ruben-iteng/ato-library/README.md

<!-- This document is autogenerated - Do not edit manually!! -->

# ato-library

This is a monorepo for various [ato](https://docs.atopile.io) and [fabll](https://docs.atopile.io/atopile/guides/faebryk) packages for your projects made with [atopile](https://www.github.com/atopile/atopile) that can be found in the official [atopile package registry](https://packages.atopile.io/)

## Available Packages

| Package | Modules | Description | Version |
|---|---|---|---|
| [analog-devices-max14778](packages/analog-devices-max14778/README.md) | 1 module | Analog Devices MAX14778 dual 4:1 +/-25V above/below the rails analog multiplexer | 0.1.2 |
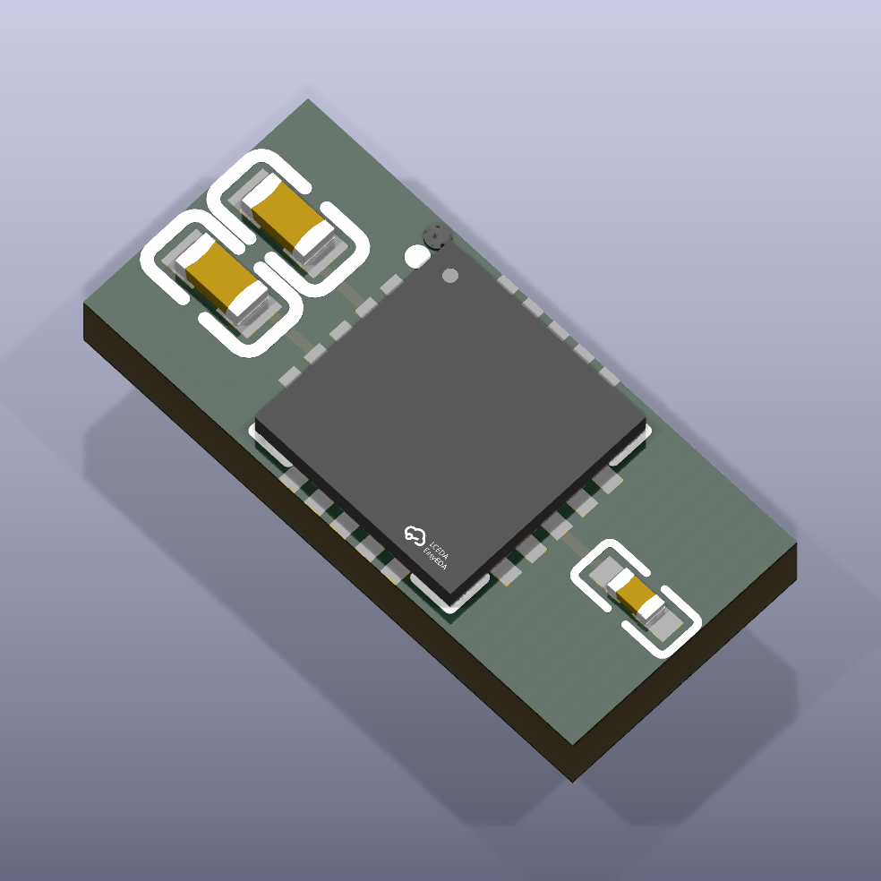
[picture p1: packages/analog-devices-max14778/assets/analog_devices_max14778_driver.png]
analog_devices_max14778_driver
|  | analog_devices_max14778_driver | Analog Devices MAX14778 dual 4:1 +/-25V above/below the rails analog multiplexer | |
| [connectors](packages/connectors/README.md) | 4 modules | Miscellaneous connectors | 0.2.3 |
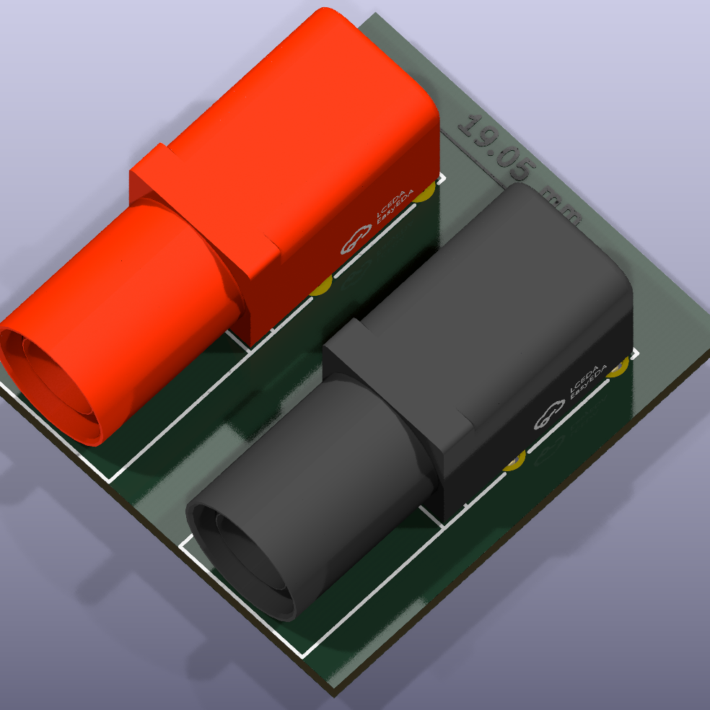
[picture p2: packages/connectors/assets/dual_banana_connectors.png]
dual_banana_connectors
|  | dual_banana_connectors | Dual banana connectors (Red and Black) with 3/4\" (19.05mm) spacing. | |
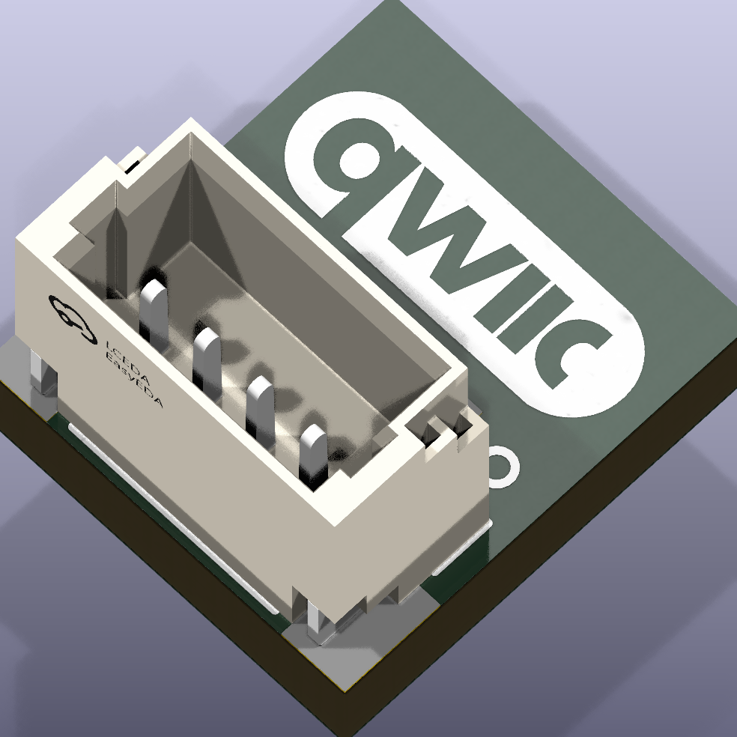
[picture p3: packages/connectors/assets/qwiic_vertical.png]
qwiic_vertical
|  | qwiic_vertical | Vertical QWIIC connector<br> https://www.sparkfun.com/qwiic | |
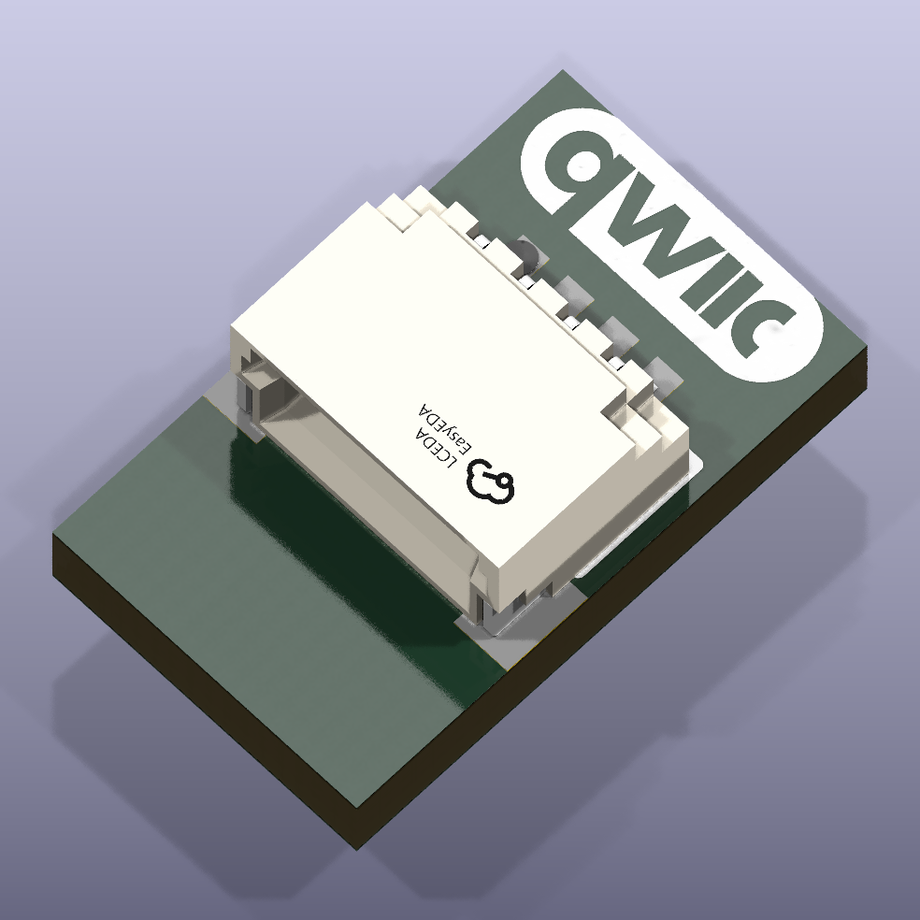
[picture p4: packages/connectors/assets/qwiic_horizontal.png]
qwiic_horizontal
|  | qwiic_horizontal | Horizontal QWIIC connector<br> https://www.sparkfun.com/qwiic | |
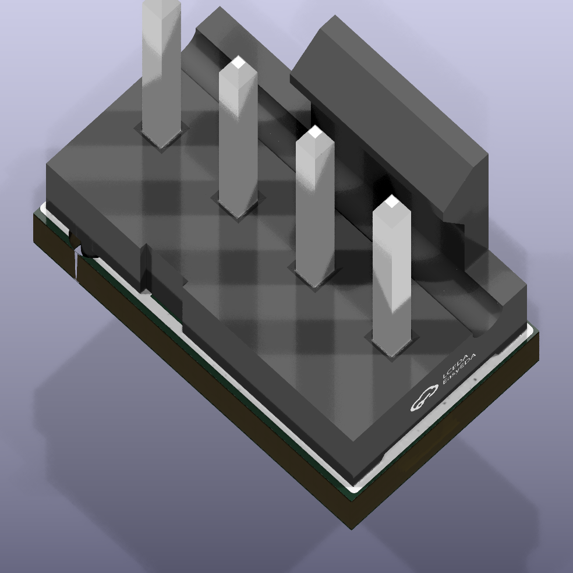
[picture p5: packages/connectors/assets/fan_connector.png]
fan_connector
|  | fan_connector | Connector for standard 4-pin 12v computer fans<br> - 12V<br> - Tach<br> - PWM | |
| [dcdc-converters](packages/dcdc-converters/README.md) | 2 modules | DCDC converters | 0.2.2 |
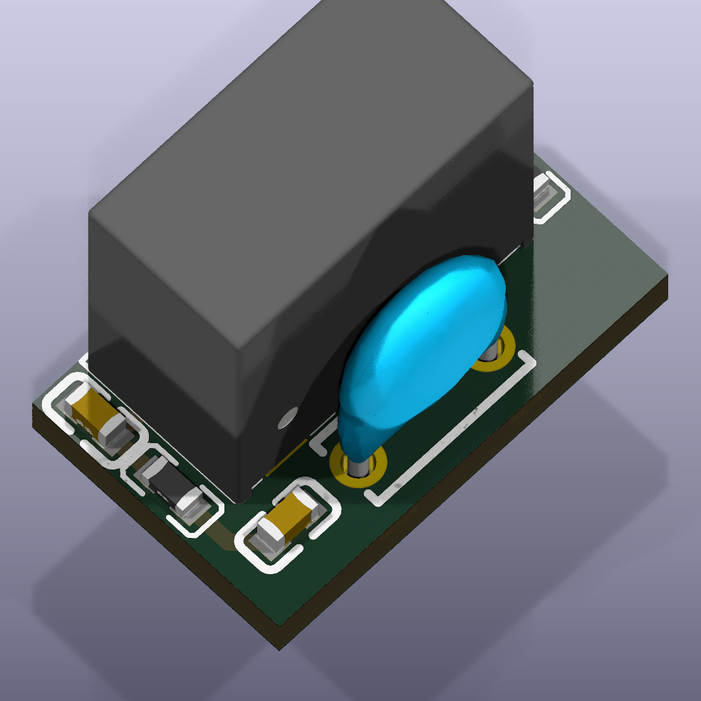
[picture p6: packages/dcdc-converters/assets/b0505s1wr3.png]
b0505s1wr3
|  | b0505s1wr3 | EVISUN B0505S-1WR3 5V to 5V isolated DCDC converter with shortcircuit protection<br> - 5V input<br> - 5V output<br> - 1W power rating | |
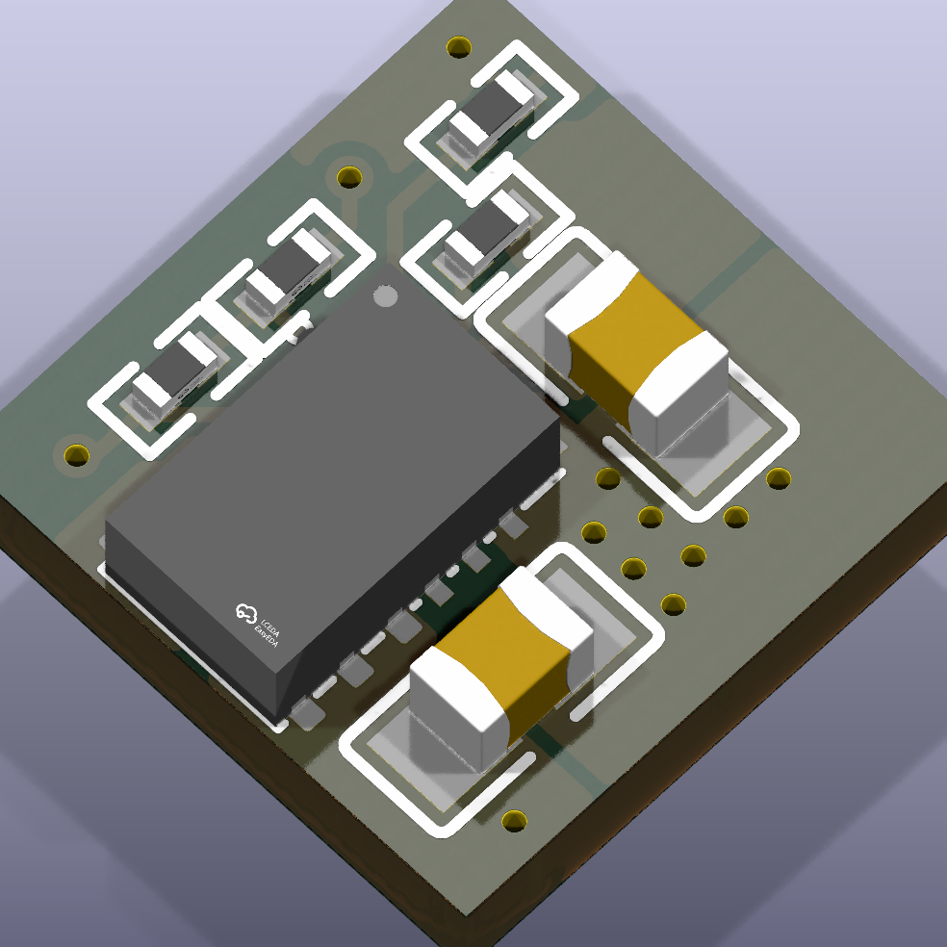
[picture p7: packages/dcdc-converters/assets/mpm3610-12vin-5vout.png]
mpm3610-12vin-5vout
|  | mpm3610-12vin-5vout | MPM3610 with component parameters optimized for 12V input and 5V output | |
| [debug-interfaces](packages/debug-interfaces/README.md) | 4 modules | SWD and tag connect headers for programming and debugging | 0.2.3 |
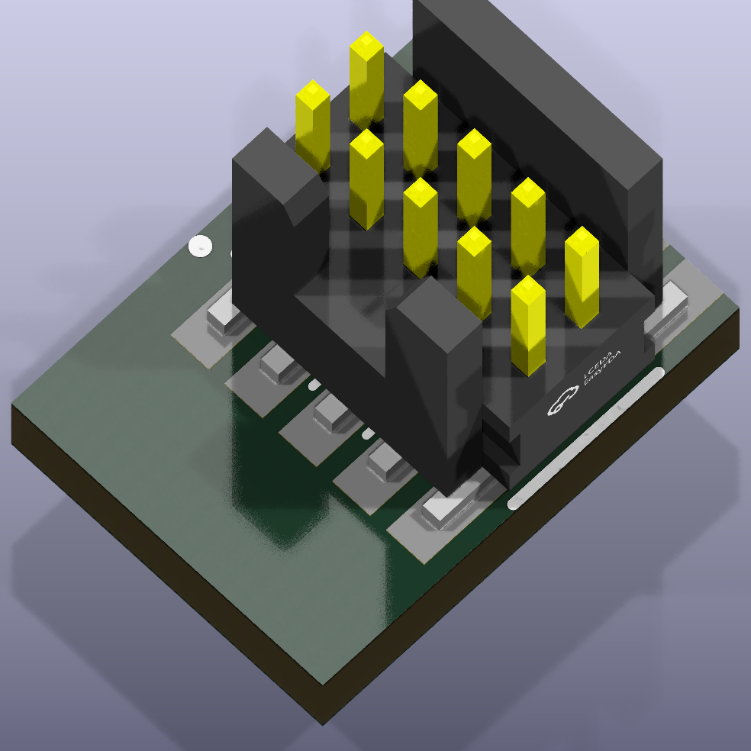
[picture p8: packages/debug-interfaces/assets/arm_cortex_m_debug_header.png]
arm_cortex_m_debug_header
|  | arm_cortex_m_debug_header | 10 pin debug header with SWD pinout according to ARM Cortex M debug specification<br> https://documentation-service.arm.com/static/5fce6c49e167456a35b36af1 | |
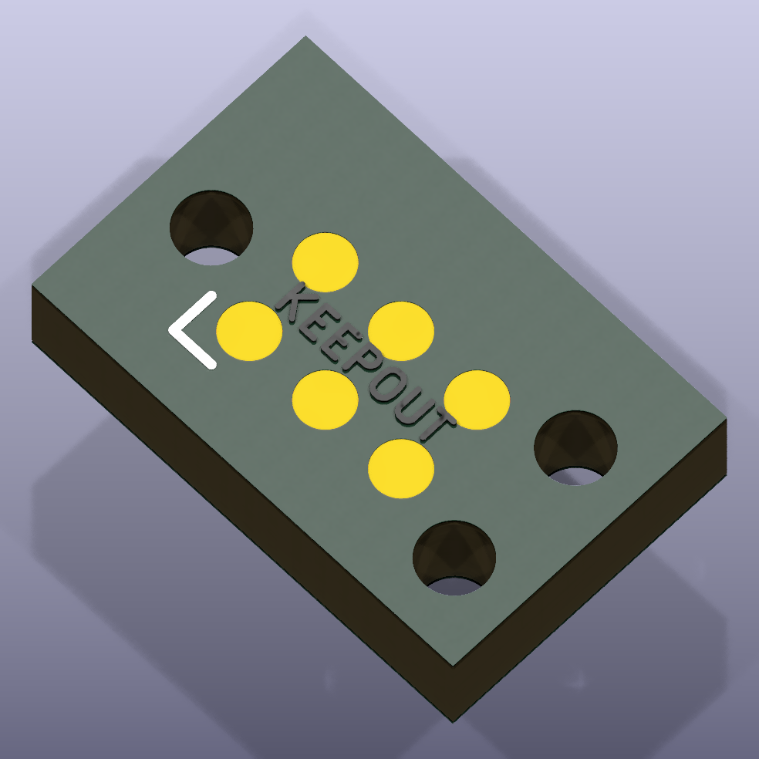
[picture p9: packages/debug-interfaces/assets/swd_tc2030_idc_nl.png]
swd_tc2030_idc_nl
|  | swd_tc2030_idc_nl | Tag-Connect TC2030-IDC-NL (6-pin) landing pattern with SWD pinout | |
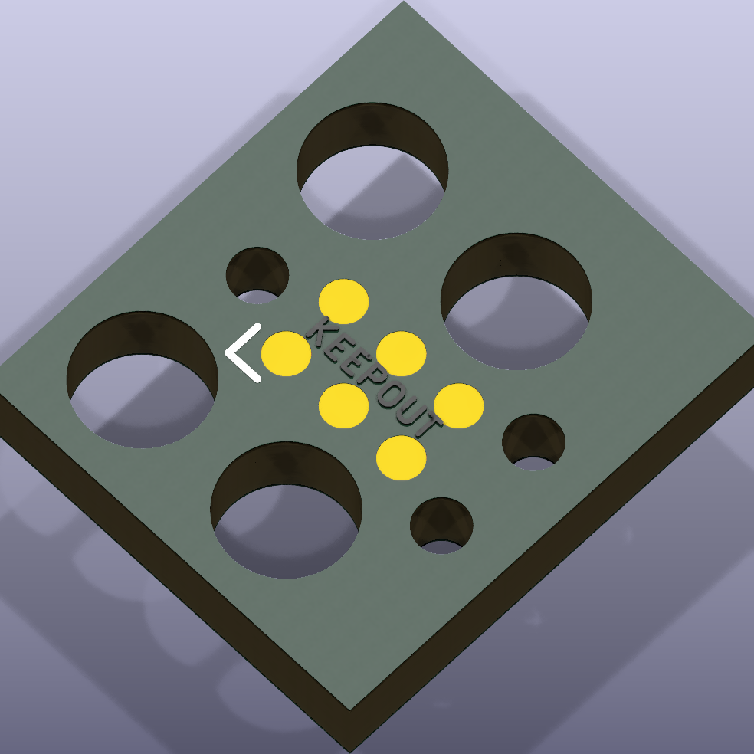
[picture p10: packages/debug-interfaces/assets/swd_tc2030_idc_fp.png]
swd_tc2030_idc_fp
|  | swd_tc2030_idc_fp | Tag-Connect TC2030-IDC-FP (6-pin) landing pattern with SWD pinout | |
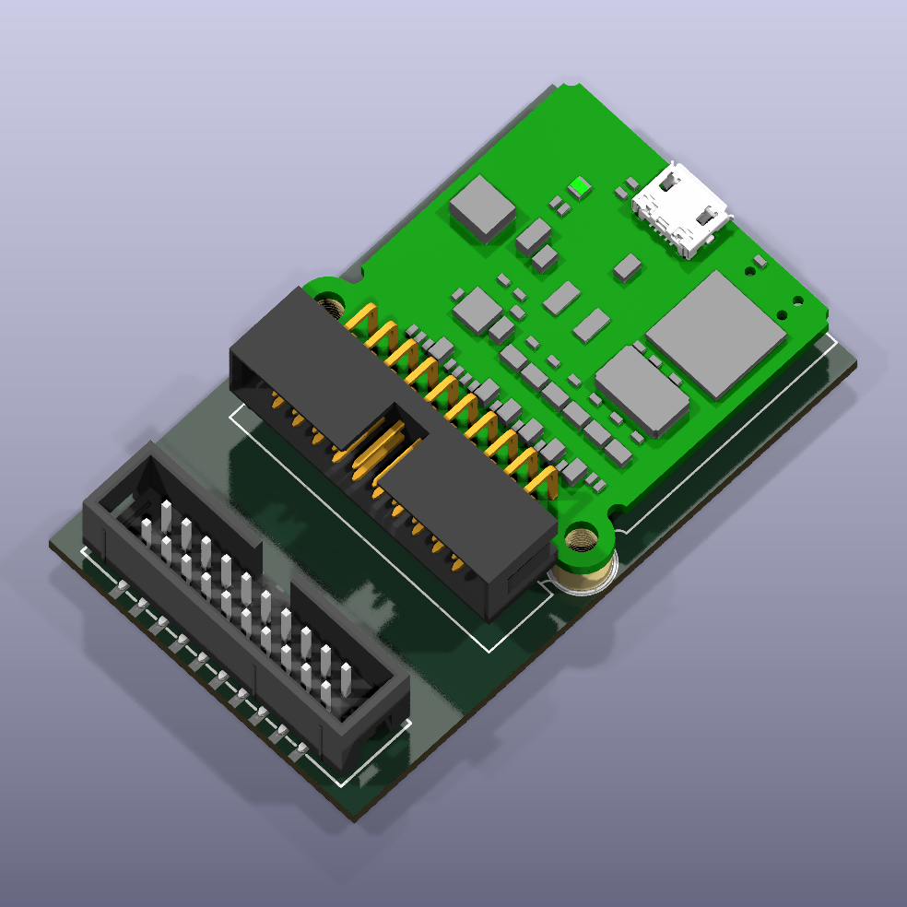
[picture p11: packages/debug-interfaces/assets/segger_jlink_compact.png]
segger_jlink_compact
|  | segger_jlink_compact | SEGGER J-Link compact PCBA mount | |
| [esp32c3](packages/esp32c3/README.md) | 2 modules | ESP32 C3 microcontroller | 0.2.3 |
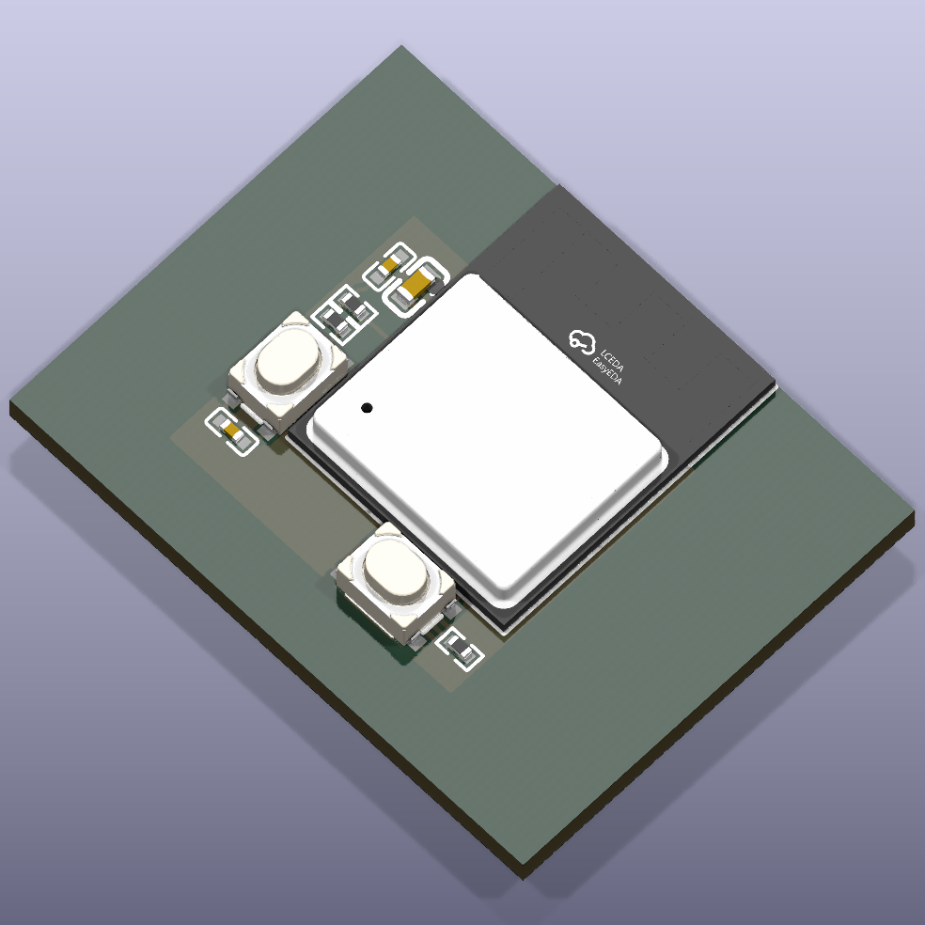
[picture p12: packages/esp32c3/assets/esp32_c3_mini_driver.png]
esp32_c3_mini_driver
|  | esp32_c3_mini_driver | ESP32 S3 WROOM-1 module with build-in antenna and supporting components | |
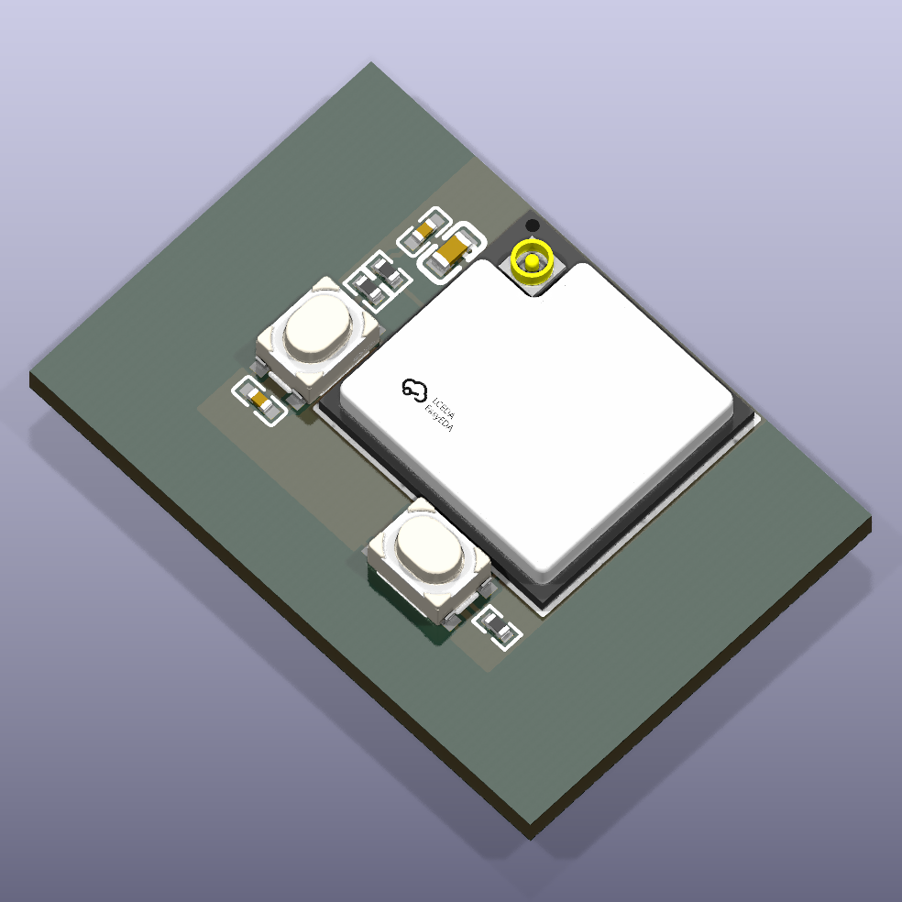
[picture p13: packages/esp32c3/assets/esp32_c3_mini_ufl_driver.png]
esp32_c3_mini_ufl_driver
|  | esp32_c3_mini_ufl_driver | ESP32 S3 WROOM-1 module with u.fl antenna connector and supporting components | |
| [esp32s3](packages/esp32s3/README.md) | 1 module | ESP32 S3 microcontroller | 0.2.2 |
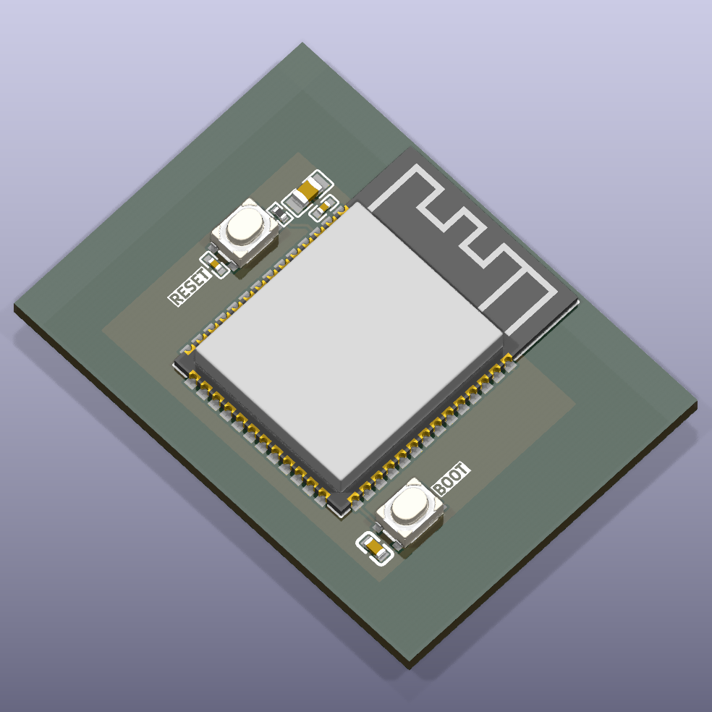
[picture p14: packages/esp32s3/assets/esp32_s3_wroom_driver.png]
esp32_s3_wroom_driver
|  | esp32_s3_wroom_driver | ESP32 S3 WROOM-1 module with build-in antenna and supporting components<br> - 32MB flash<br> - 2MB PSRAM | |
| [ina228](packages/ina228/README.md) | 1 module | INA228 low voltage power monitor with I2C interface | 0.2.2 |
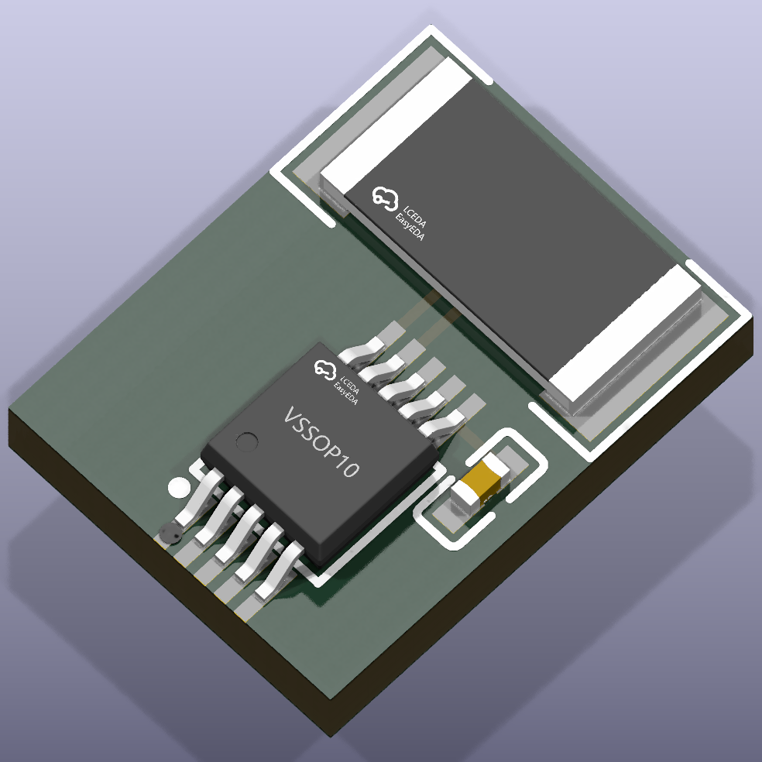
[picture p15: packages/ina228/assets/ina228.png]
ina228
|  | ina228 | INA228 85-V, 20-bit, ultra-precise, I2C output<br> current/voltage/power/energy/charge monitor with alert | |
| [ldos](packages/ldos/README.md) | 1 module | Various Low Dropout Regulators (LDOs) | 0.2.3 |
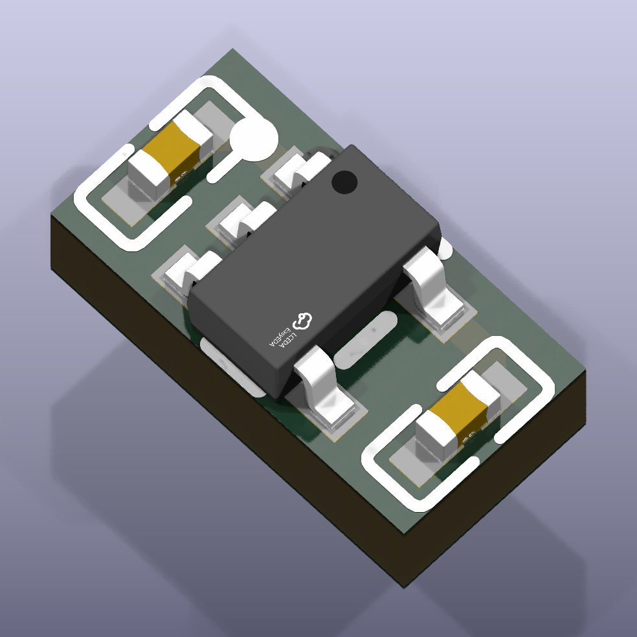
[picture p16: packages/ldos/assets/5v_to_3v3.png]
5v_to_3v3
|  | 5v_to_3v3 | 5V to 3.3V 600mA (max 1100mA) LDO | |
| [leds](packages/leds/README.md) | 2 modules | Various (addressable) LED components and modules | 0.2.2 |
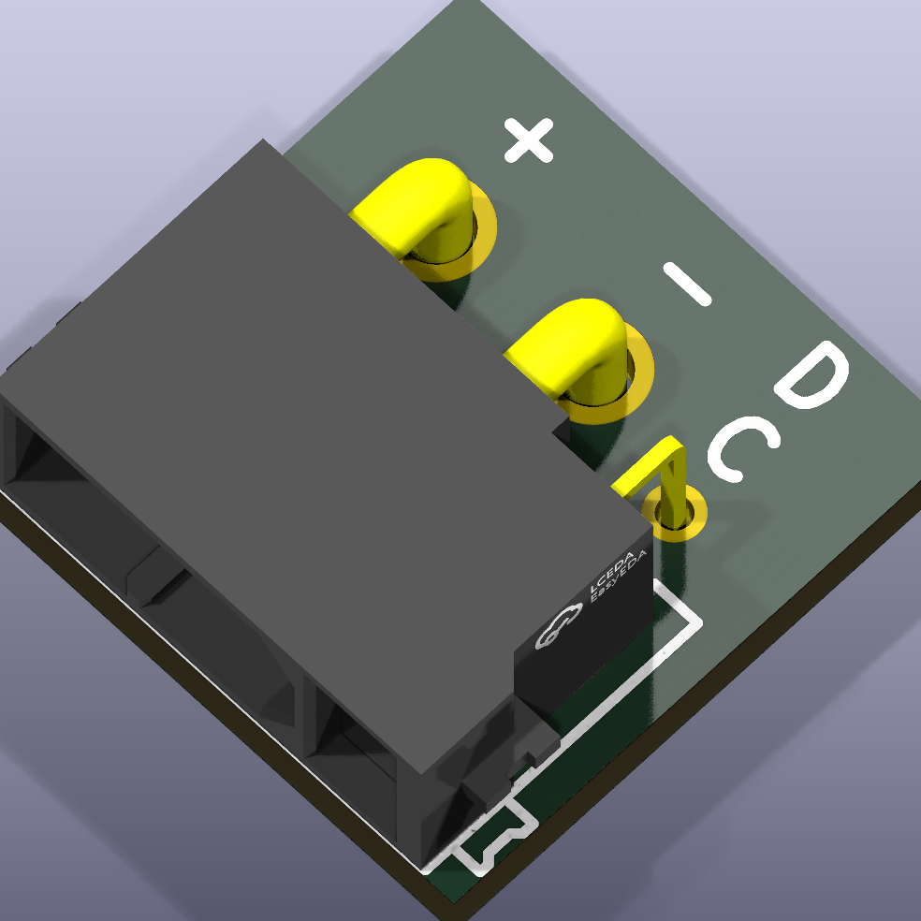
[picture p17: packages/leds/assets/addressable_led_connector_driver.png]
addressable_led_connector_driver
|  | addressable_led_connector_driver | XT30 connector with 2 additional data pins.<br> Wired for connecting to addressable LED strips. | |
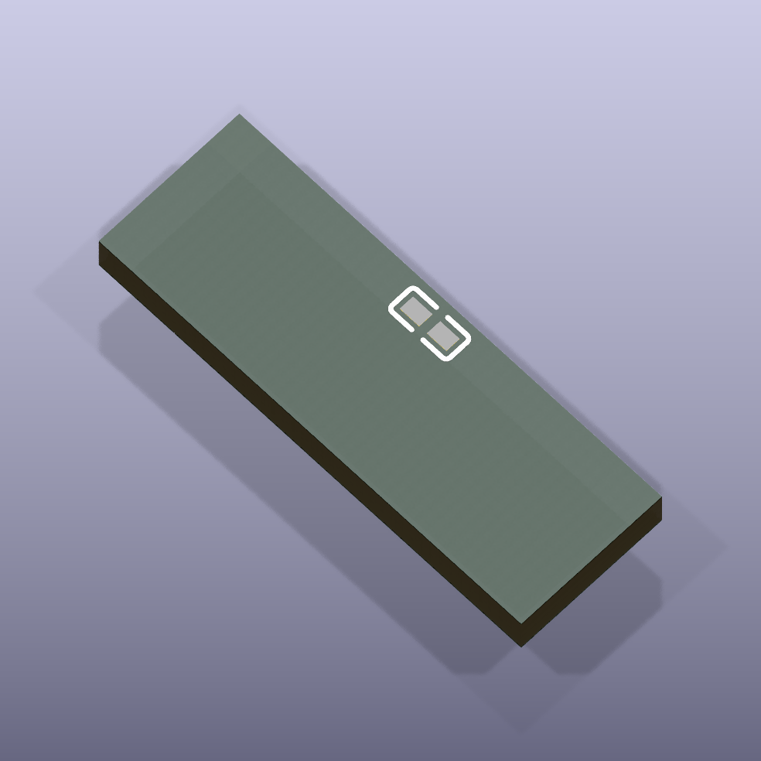
[picture p18: packages/leds/assets/addressable_led_driver.png]
addressable_led_driver
|  | addressable_led_driver | Addressable LED with decoupling capacitors.<br><br> Usage:<br> from "ruben-iteng/ato-library/leds/addressable_leds.ato" import AddressableLED<br><br> module MyProject:<br> ...<br> leds = new AddressableLED[3]<br><br> power = new ElectricPower<br> data_in = new ElectricLogic<br><br> for led in leds:<br> led -> WS2812B_5050_Black<br> led.power ~ power<br><br> data_in ~> leds[0] ~> leds[1] ~> leds[2] | |
| [logic](packages/logic/README.md) | 5 modules | Digital logic related components and modules | 0.2.2 |
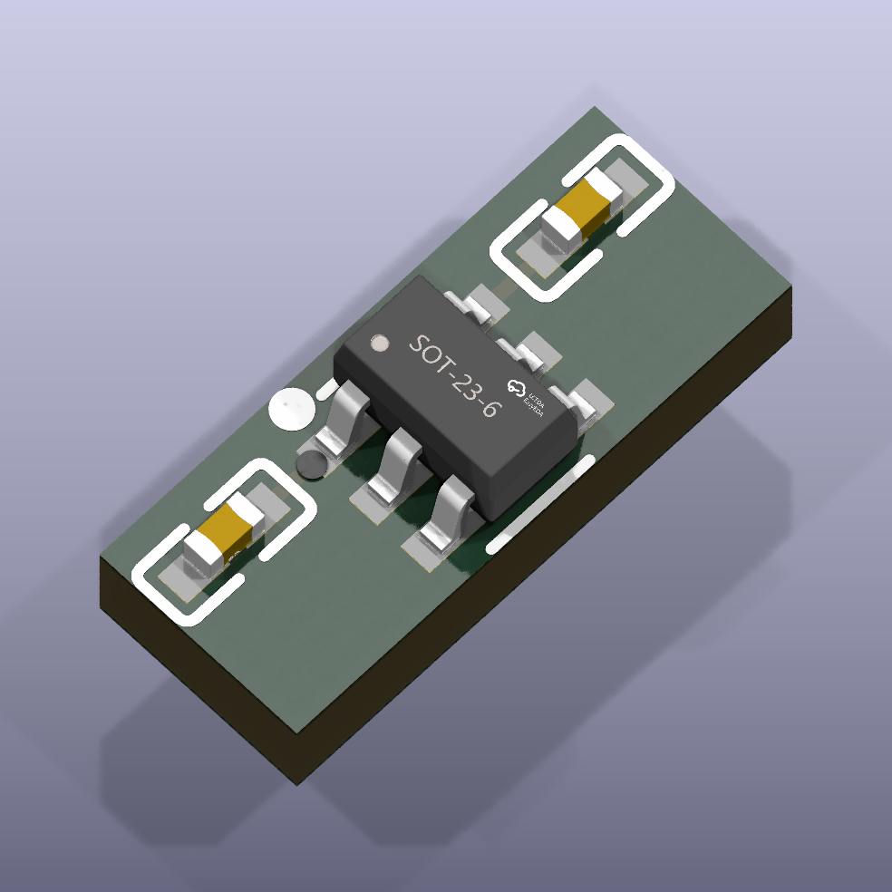
[picture p19: packages/logic/assets/aip74lvc1t45_driver.png]
aip74lvc1t45_driver
|  | aip74lvc1t45_driver | Single channel bidirectional buffer.<br> 1.2V-5.5V logic levels.<br> SOT-23-6 | |
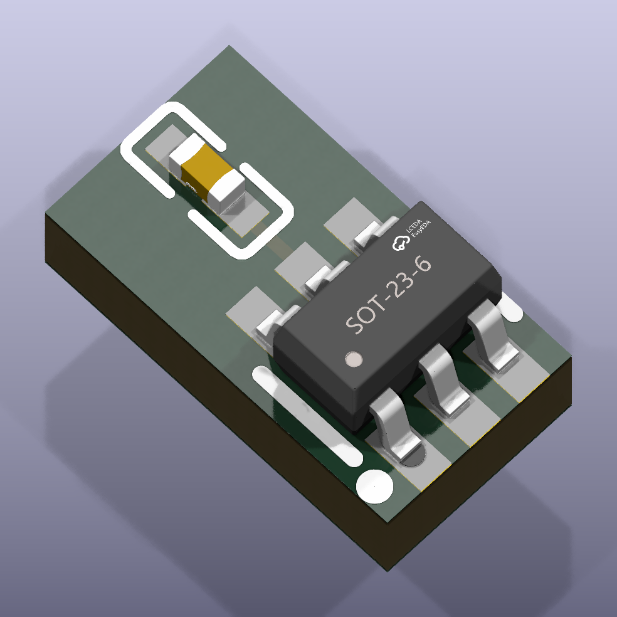
[picture p20: packages/logic/assets/sn74lvc2g34dbvrumw_driver.png]
sn74lvc2g34dbvrumw_driver
|  | sn74lvc2g34dbvrumw_driver | UMWYoutai Semiconductor Co., Ltd.<br> 74LVC2G34 Dual buffer. | |
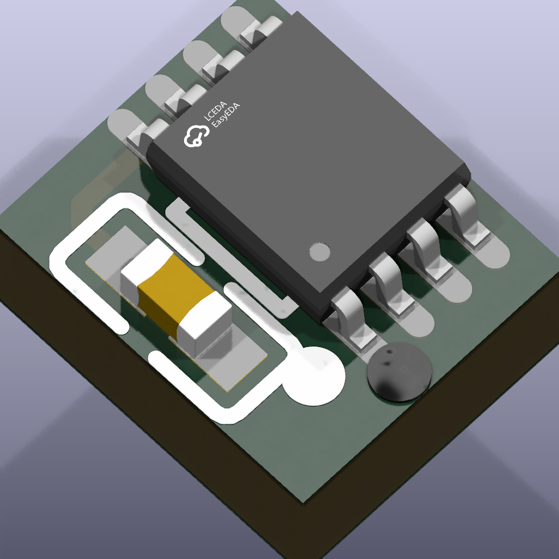
[picture p21: packages/logic/assets/sn74lvc3g14dc_driver.png]
sn74lvc3g14dc_driver
|  | sn74lvc3g14dc_driver | - | |
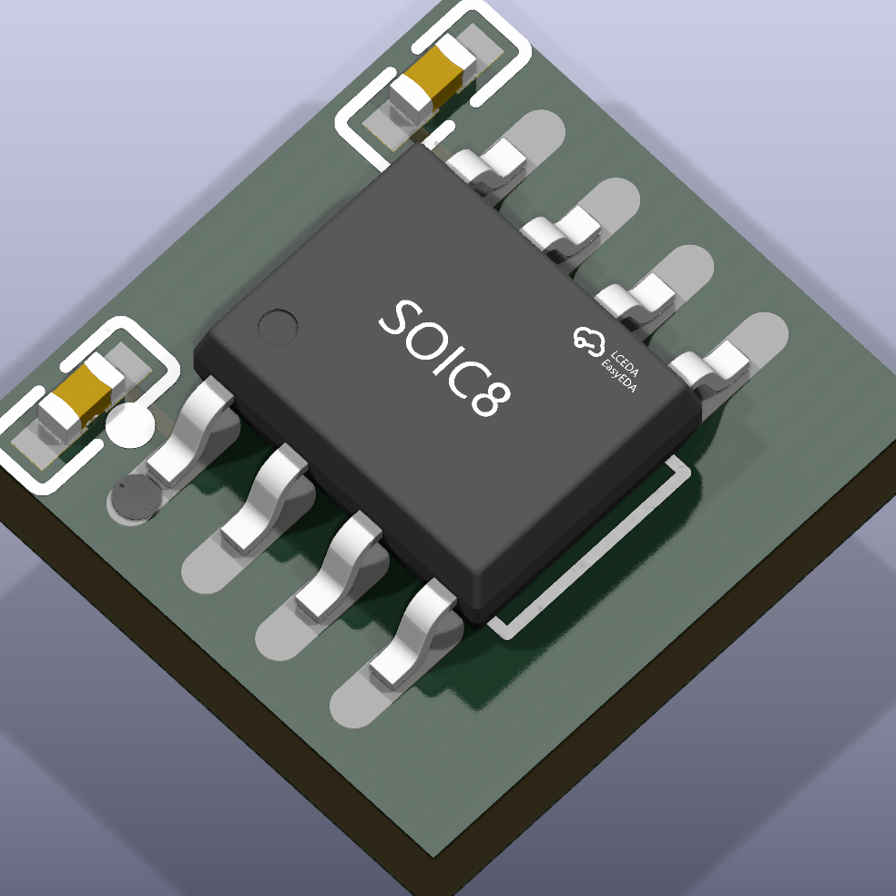
[picture p22: packages/logic/assets/iso1540_driver.png]
iso1540_driver
|  | iso1540_driver | ISO1540 low-power bidirectional I2C isolators.<br> - 3.0V to 5.5V power and signal levels<br> - up to 100Mhz I2C | |
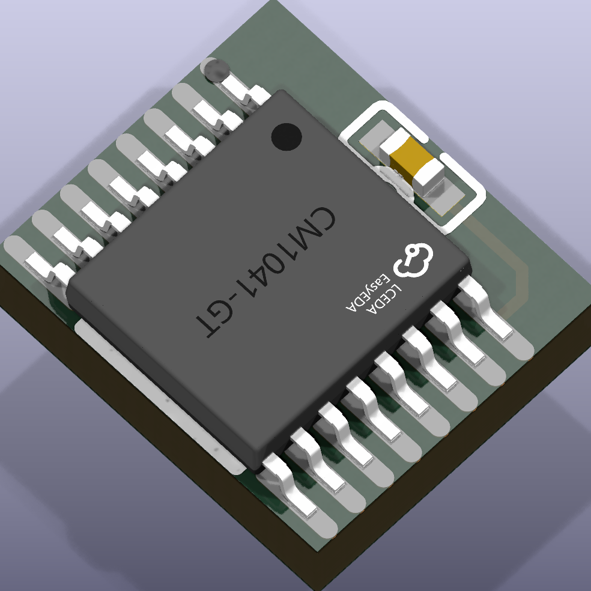
[picture p23: packages/logic/assets/sn74cb3q3251pwr_driver.png]
sn74cb3q3251pwr_driver
|  | sn74cb3q3251pwr_driver | Texas Instruments SN74CB3Q3251PWR<br> 1 to/from 8 FET multiplexer/demultiplexer<br> 2.5V/3.3V low-voltage high-bandwidth bus switch | |
| [logos](packages/logos/README.md) | 1 module | Various logos | 0.2.0 |
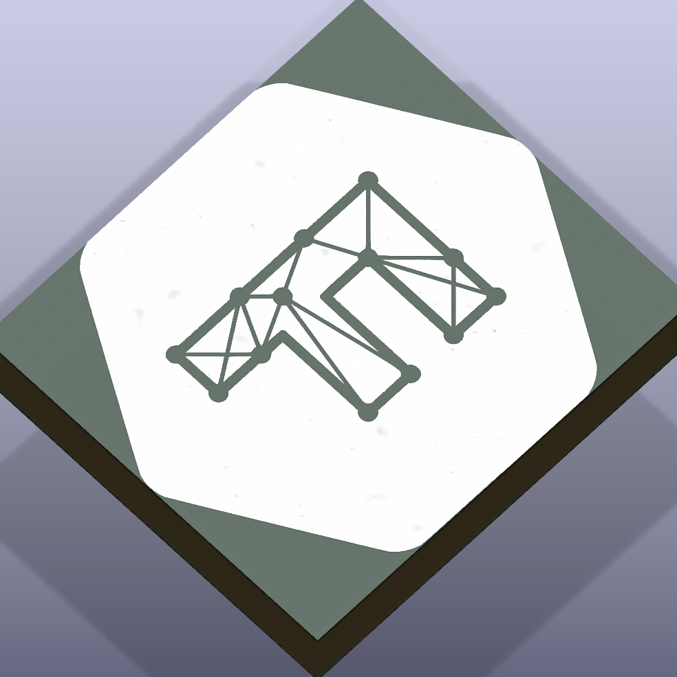
[picture p24: packages/logos/assets/faebryk_logo_8x9mm.png]
faebryk_logo_8x9mm
|  | faebryk_logo_8x9mm | faebryk Logo 8x9mm | |
| [microchip-emc2101](packages/microchip-emc2101/README.md) | 1 module | Microchip EMC2101 fan driver | 0.1.2 |
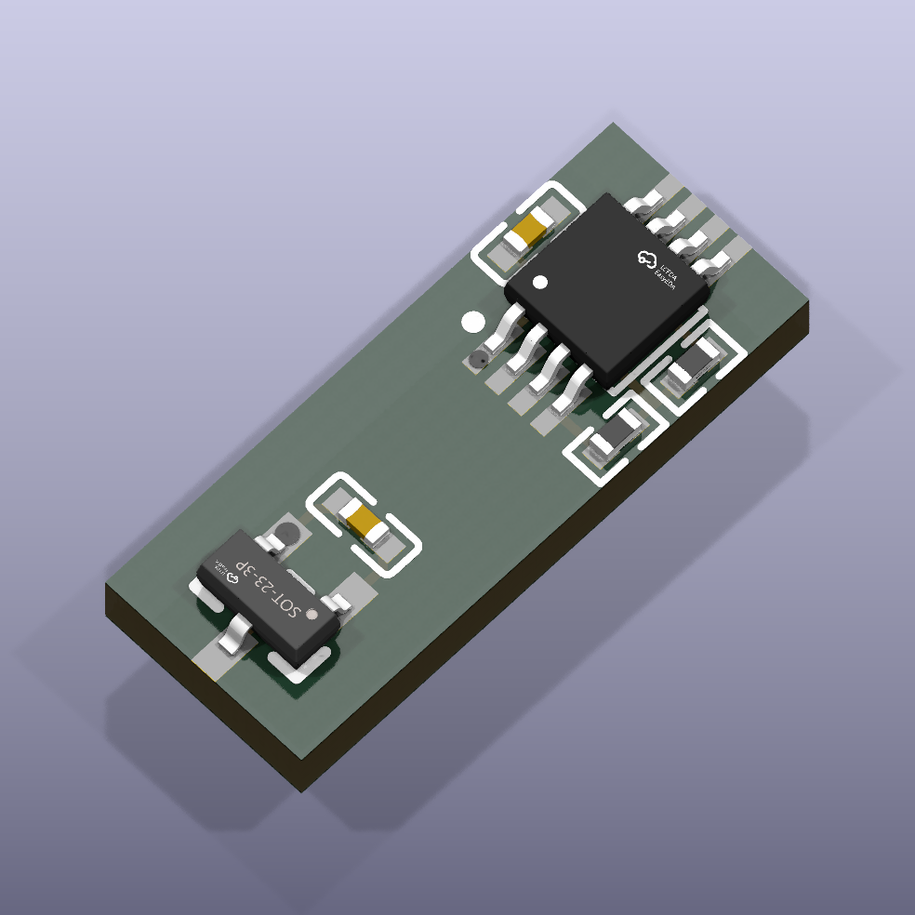
[picture p25: packages/microchip-emc2101/assets/microchip_emc2101_driver.png]
microchip_emc2101_driver
|  | microchip_emc2101_driver | MicrochipEMC2101 fan driver<br> Automatic Beta Compensation<br> - Resistance Error Correction<br> - Self-programming with available SMBus compatible EEPROM<br> - Selectable PWM or DAC fan driver output<br> - Temperature Monitors<br> - External channel ±1°C accuracy<br> - Internal channel ±2°C accuracy<br> - 3.3 Volt Operation (5 Volt Tolerant Input Buffers)<br> - SMBus 2.0 Compliant Interface, supports TIMEOUT | |
| [nxp_semiconductors-pca95xx](packages/nxp_semiconductors-pca95xx/README.md) | 7 modules | NXP Semiconductors PCA95xx family of I2C I/O expanders | 0.2.0 |
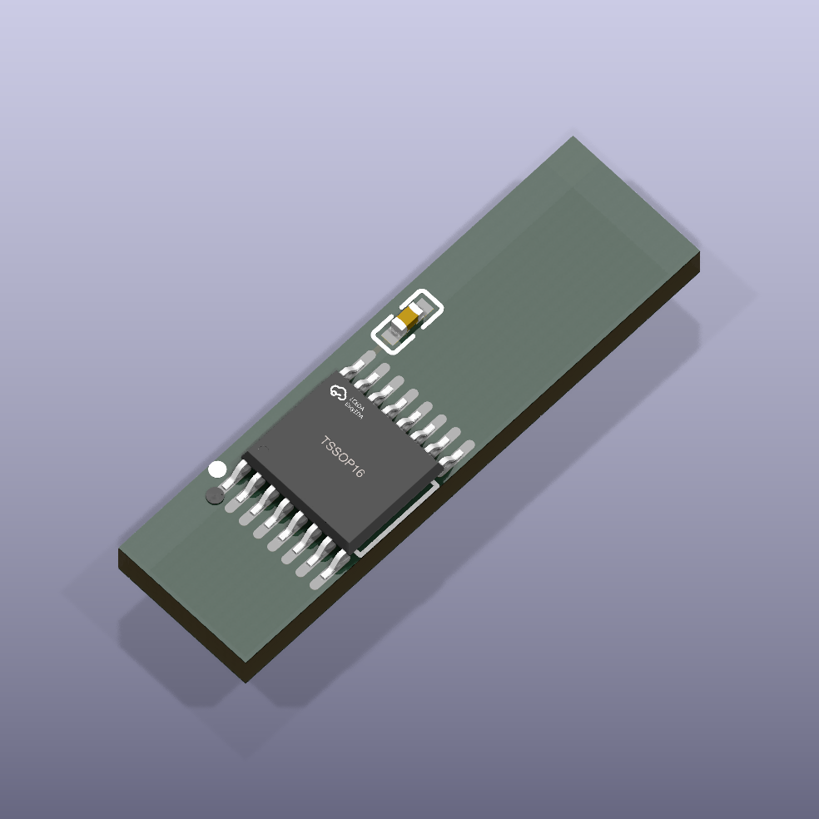
[picture p26: packages/nxp_semiconductors-pca95xx/assets/pca9554pw_driver.png]
pca9554pw_driver
|  | pca9554pw_driver | NXP Semiconductors PCA9554 TSSOP16 package | |
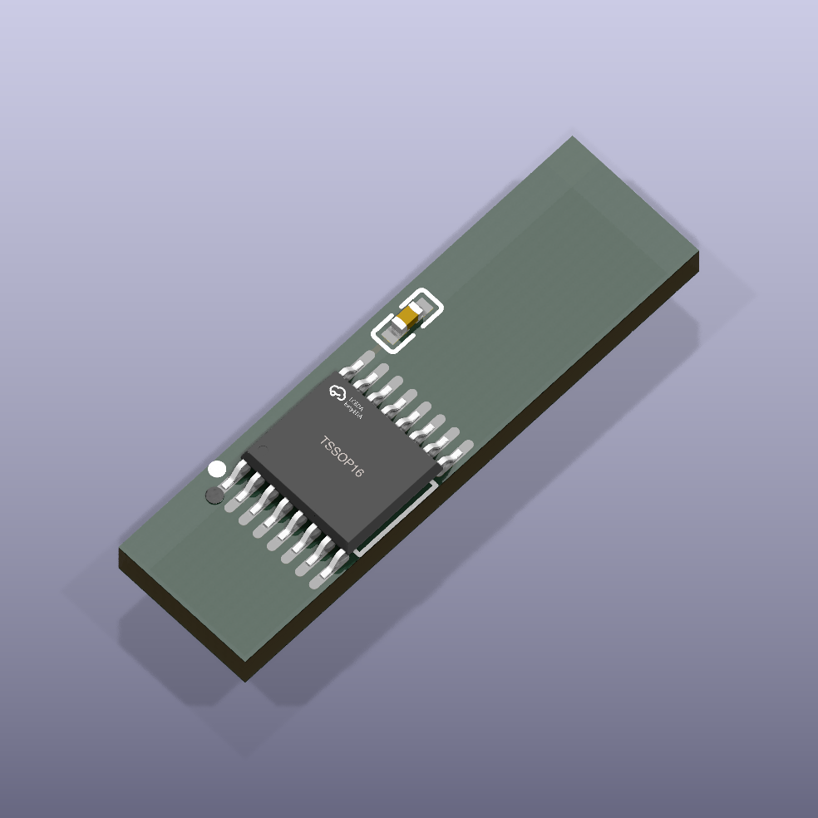
[picture p27: packages/nxp_semiconductors-pca95xx/assets/pca9554apw_driver.png]
pca9554apw_driver
|  | pca9554apw_driver | NXP Semiconductors PCA9554A TSSOP16 package | |
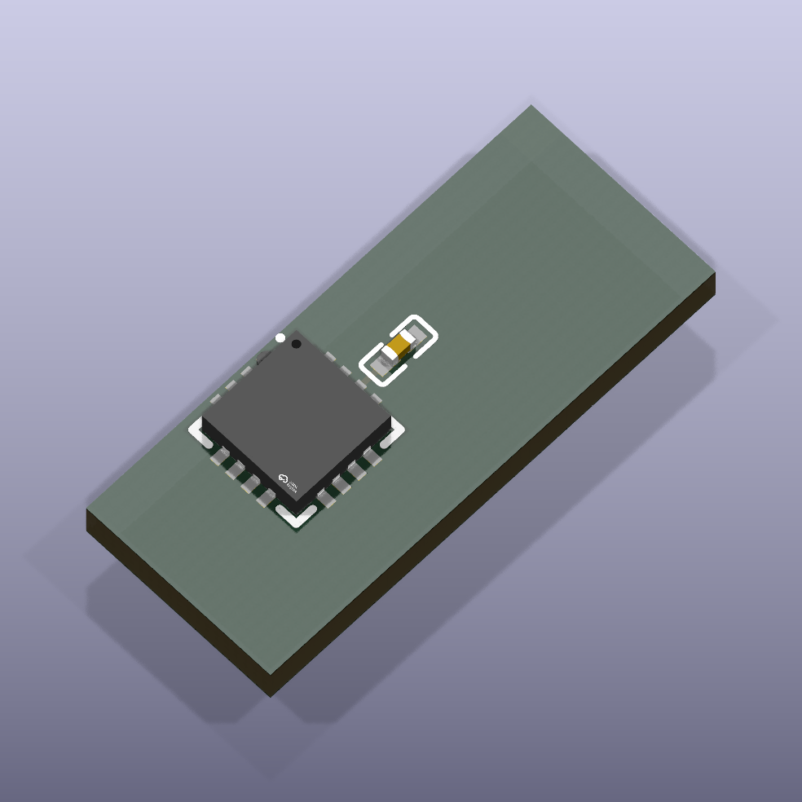
[picture p28: packages/nxp_semiconductors-pca95xx/assets/pca9554abs_driver.png]
pca9554abs_driver
|  | pca9554abs_driver | NXP Semiconductors PCA9554A HVQFN16(4x4mm) package | |
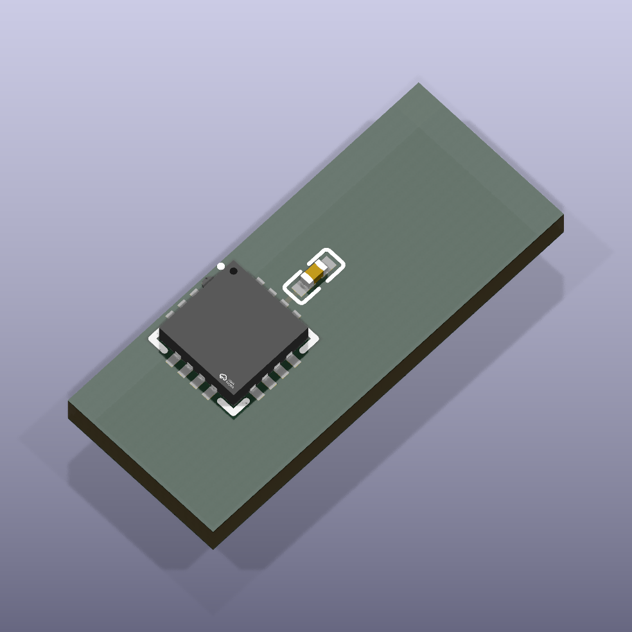
[picture p29: packages/nxp_semiconductors-pca95xx/assets/pca9554bs_driver.png]
pca9554bs_driver
|  | pca9554bs_driver | NXP Semiconductors PCA9554 HVQFN16(4x4mm) package | |
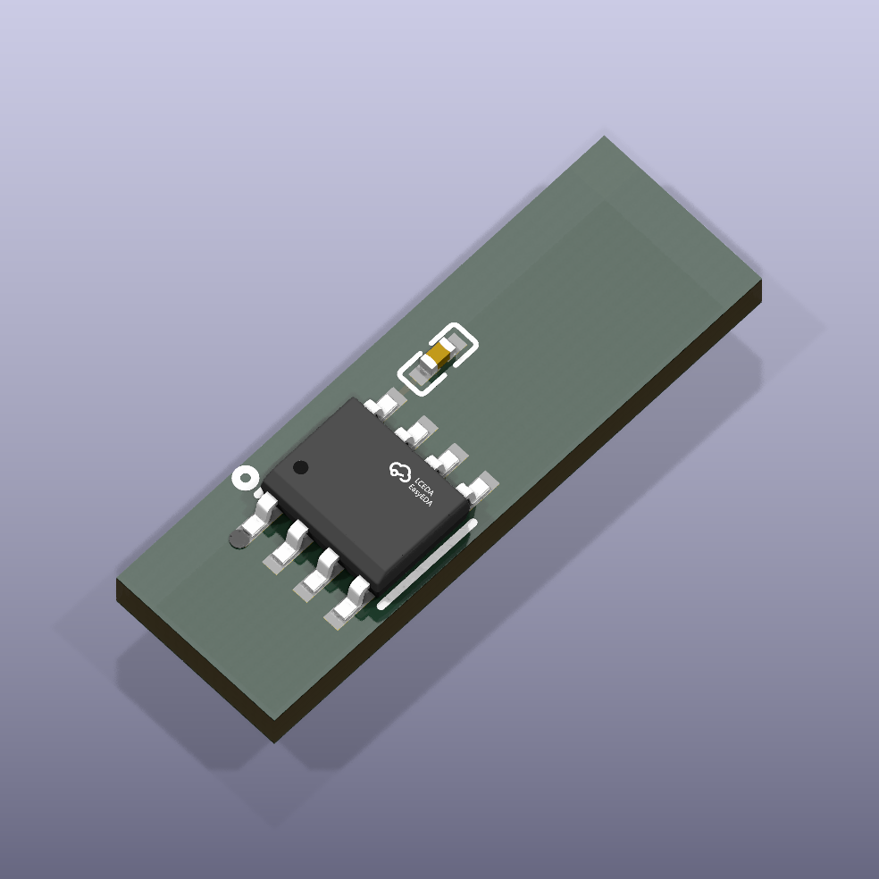
[picture p30: packages/nxp_semiconductors-pca95xx/assets/pca9536d_driver.png]
pca9536d_driver
|  | pca9536d_driver | NXP Semiconductors PCA9536D SO-8 package | |
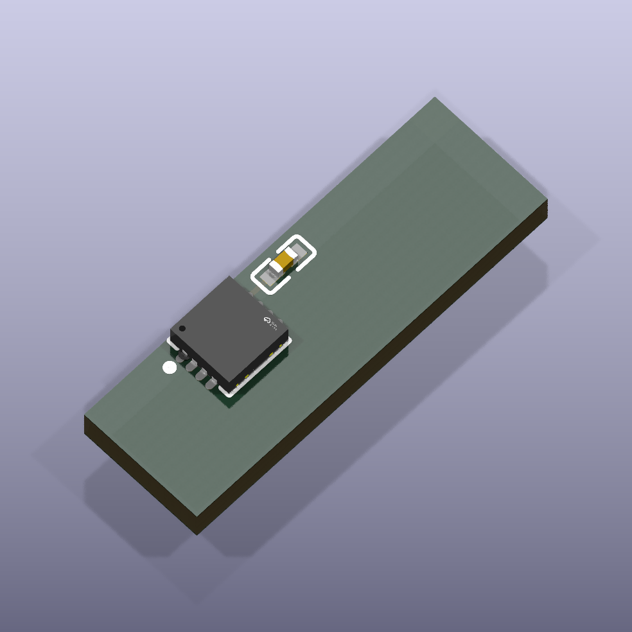
[picture p31: packages/nxp_semiconductors-pca95xx/assets/pca9536tk_driver.png]
pca9536tk_driver
|  | pca9536tk_driver | NXP Semiconductors PCA9536TK HVSON-8 package | |
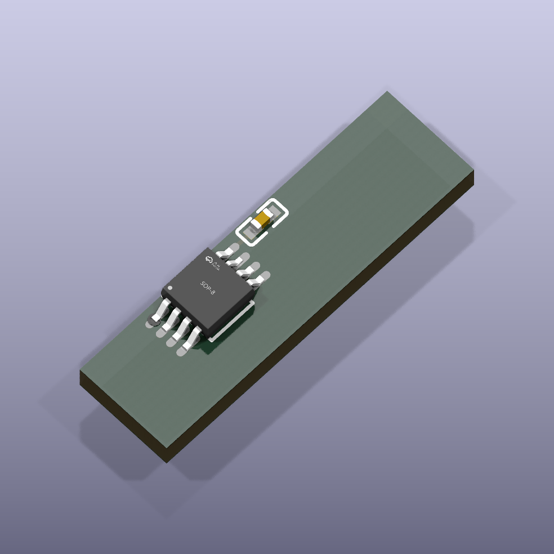
[picture p32: packages/nxp_semiconductors-pca95xx/assets/pca9536dp_driver.png]
pca9536dp_driver
|  | pca9536dp_driver | NXP Semiconductors PCA9536DP TSSOP-8 package | |
| [relays](packages/relays/README.md) | 3 modules | Relay modules | 0.2.2 |
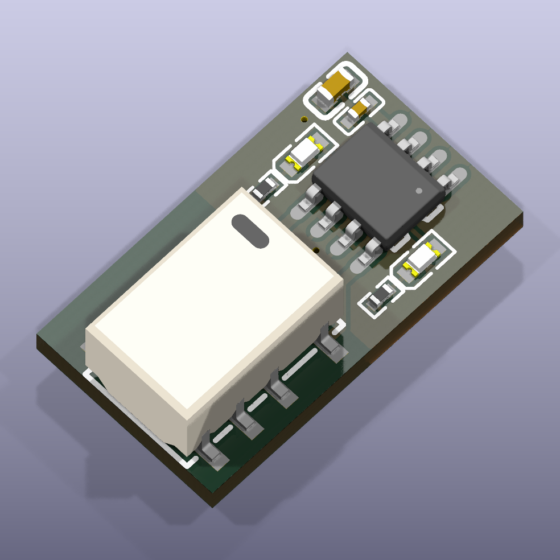
[picture p33: packages/relays/assets/driven_dpdt_bistable_relay.png]
driven_dpdt_bistable_relay
|  | driven_dpdt_bistable_relay | Bistable DPDT relay with driver and indicator LEDs<br> - 5V coil power<br> - 5V/3.3V logic power<br> - 2A contact carry current<br> - TC118S DC motor driver (H-bridge) as relay driver | |
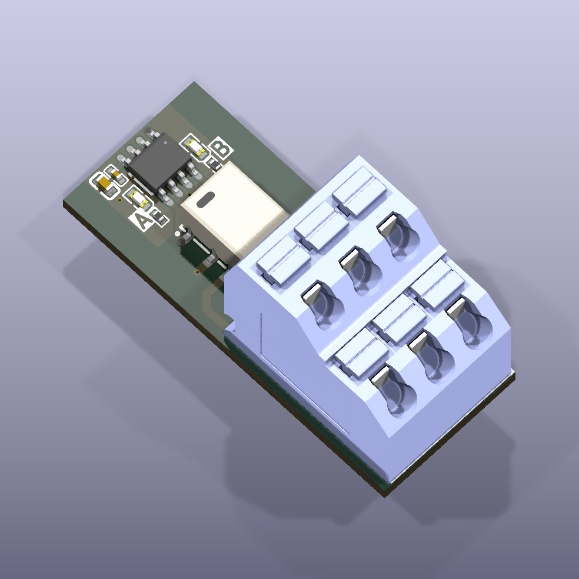
[picture p34: packages/relays/assets/driven_dpdt_bistable_relay_push_terminal.png]
driven_dpdt_bistable_relay_push_terminal
|  | driven_dpdt_bistable_relay_push_terminal | DrivenDPDTBistableRelay with push terminal | |
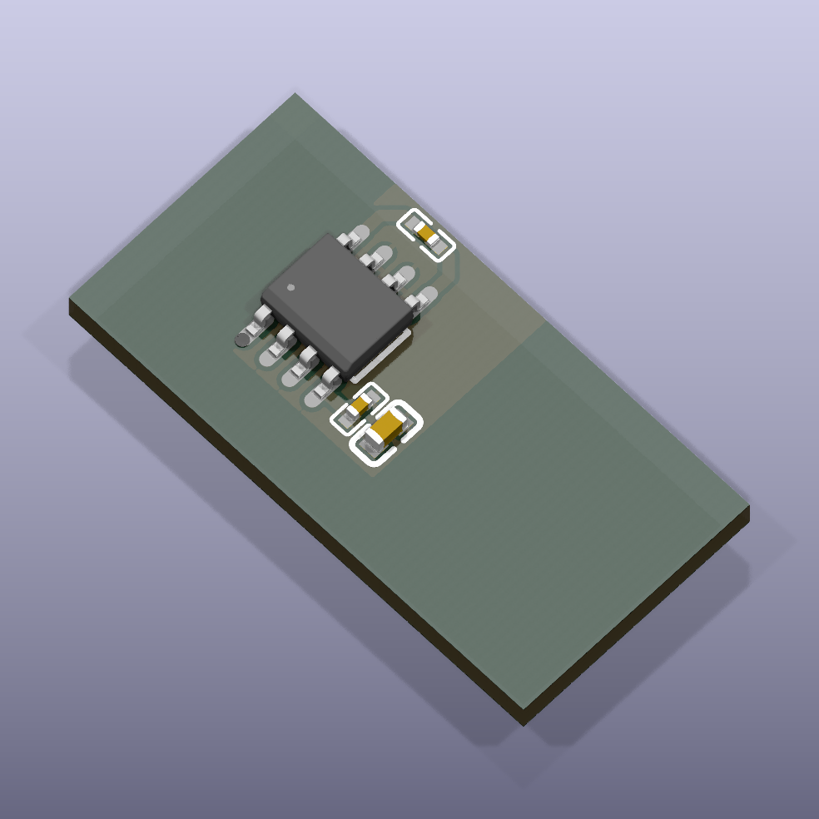
[picture p35: packages/relays/assets/dc_motor_driver.png]
dc_motor_driver
|  | dc_motor_driver | Shenzhen Fuman Elec TC118S dc motor driver<br> - Single-channel built-in high-power MOS full-bridge driver<br> - Supports forward, reverse, stop, and brake functions<br> - Built-in efficient thermal response and thermal protection<br> - Low on-resistance (1.6Ω)<br> - Maximum continuous output current: 1.8A, peak current: 2.5A | |
| [rohm_semiconductor_bh1750fvi](packages/rohm_semiconductor_bh1750fvi/README.md) | 1 module | ROHM Semiconductor BH1750FVI-TR Digital Ambient Light Sensor with I2C interface | 0.1.1 |
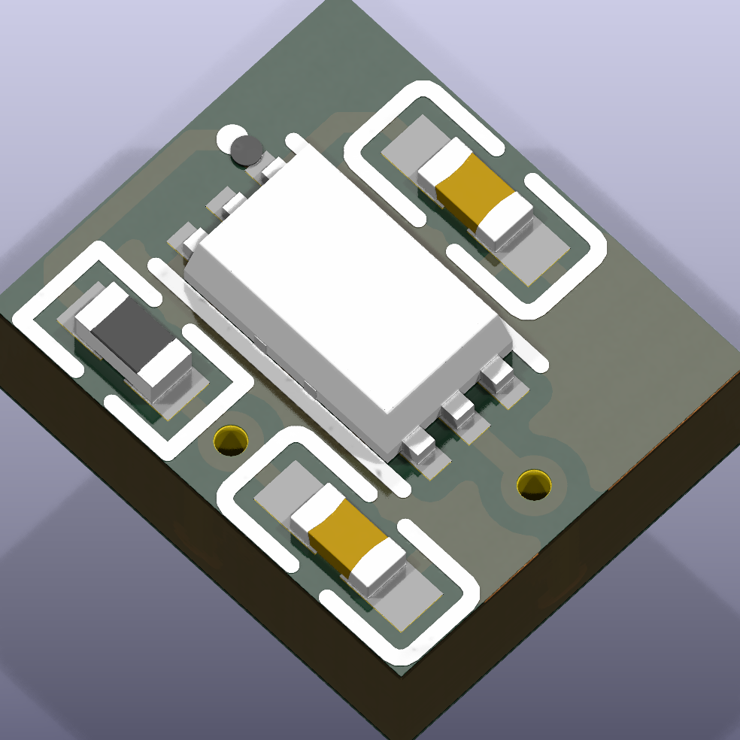
[picture p36: packages/rohm_semiconductor_bh1750fvi/assets/bh1750_driver.png]
bh1750_driver
|  | bh1750_driver | Digital ambient light sensor with I2C interface<br><br> - I2C bus Interface (f/s Mode Support)<br> - Spectral responsibility is approximately human eye response<br> - Illuminance to Digital Converter<br> - Wide range and High resolution (1 - 65535 lx)<br> - Low Current by power down function<br> - 50Hz/60Hz Light noise reject-function<br> - 1.8V Logic input interface<br> - No need any external parts<br> - Light source dependency is little (Incandescent Lamp, Fluorescent Lamp, Halogen Lamp, White LED, Sun Light)<br> - It is possible to select 2 type of I2C slave-address<br> - Adjustable measurement result for influence of optical window (It is possible to detect min. 0.11 lx, max. 100000 lx by using this function)<br> - Small measurement variation (+/- 20%)<br> - The influence of infrared is very small | |
| [rs485](packages/rs485/README.md) | 4 modules | RS485 related modules | 0.2.3 |
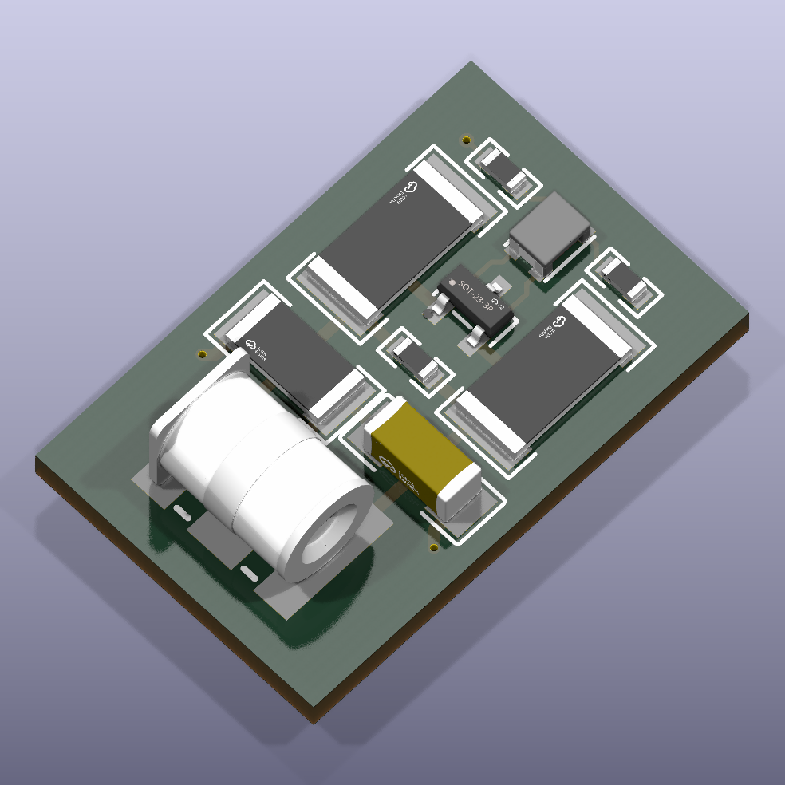
[picture p37: packages/rs485/assets/bus_protection.png]
bus_protection
|  | bus_protection | RS485 bus protection.<br> - Overvoltage protection<br> - Overcurrent protection<br> - Common mode filter<br> - Termination resistor<br> - ESD protection<br> - Lightning protection<br><br> based on: https://www.mornsun-power.com/public/uploads/pdf/TD(H)541S485H.pdf | |
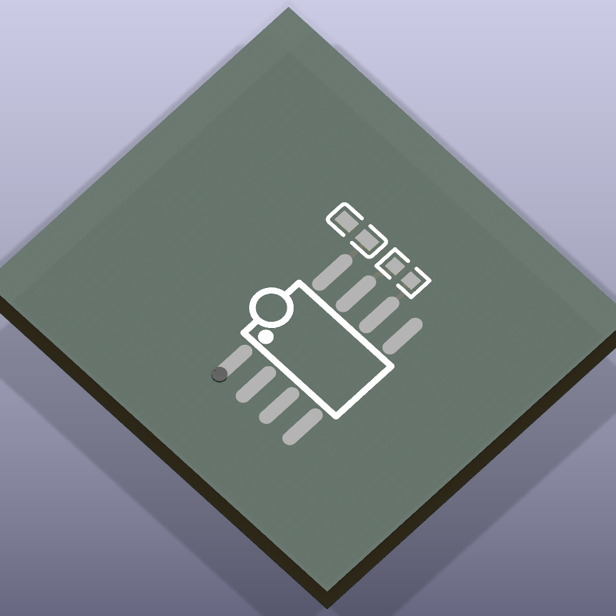
[picture p38: packages/rs485/assets/maxlinear_sp3485en_driver.png]
maxlinear_sp3485en_driver
|  | maxlinear_sp3485en_driver | Simple UART to RS485 converter.<br> UART and write enable interface in, RS485 interface out. | |
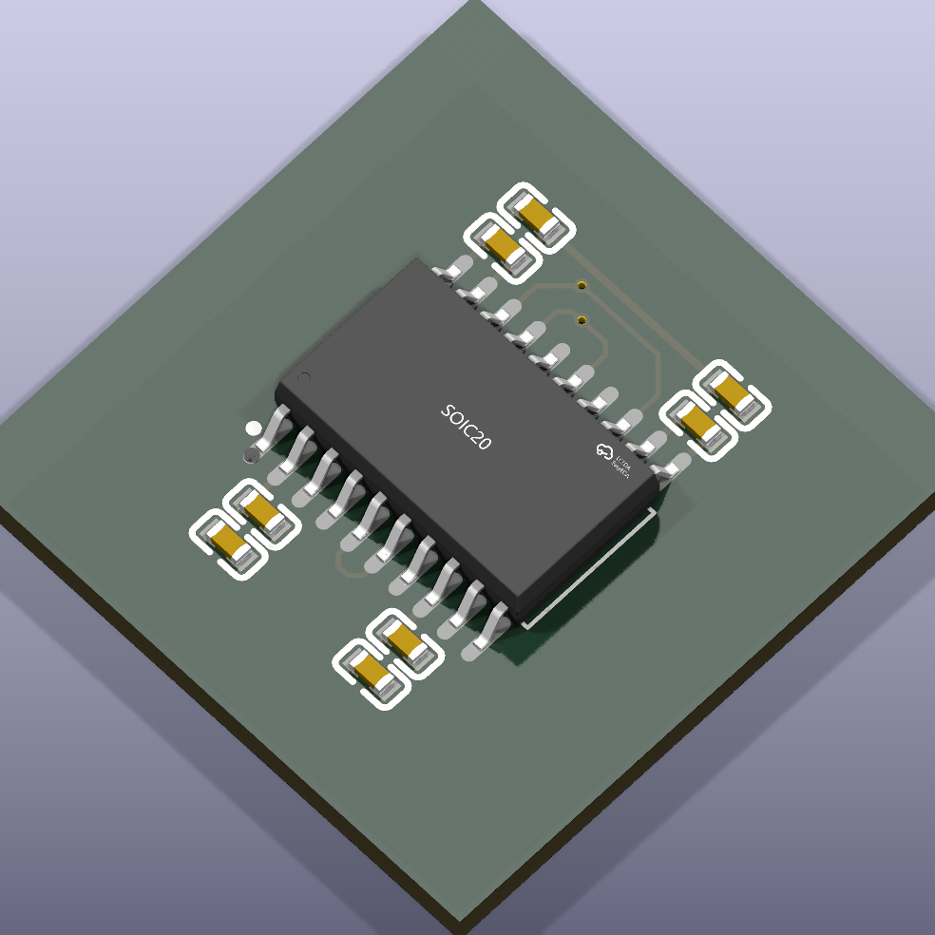
[picture p39: packages/rs485/assets/analog_devices_adm2587ebrwz_driver.png]
analog_devices_adm2587ebrwz_driver
|  | analog_devices_adm2587ebrwz_driver | Isolated UART to half duplex RS485 interface | |
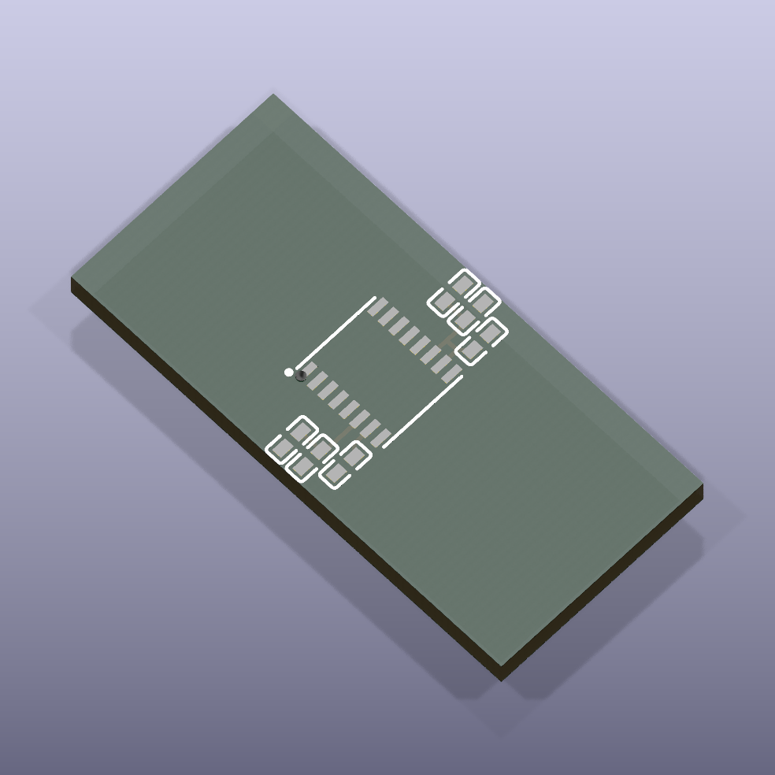
[picture p40: packages/rs485/assets/chipanalog_is2092a_driver.png]
chipanalog_is2092a_driver
|  | chipanalog_is2092a_driver | Isolated powered UART to RS485 transceiver design block.<br> - 3.3V or 5V logic power<br> - 3.3V or 5V module power<br> - 0.5 Mbps UART<br> - Read enable/write enable input<br> - RS485 half duplex<br> - ANSI/ESDA/JEDEC JS-001 ESD protection<br> - JESD22-C101 CDM protection | |
| [switches](packages/switches/README.md) | 2 modules | Rotary encoders, switches, and other switch like components and modules | 0.1.4 |
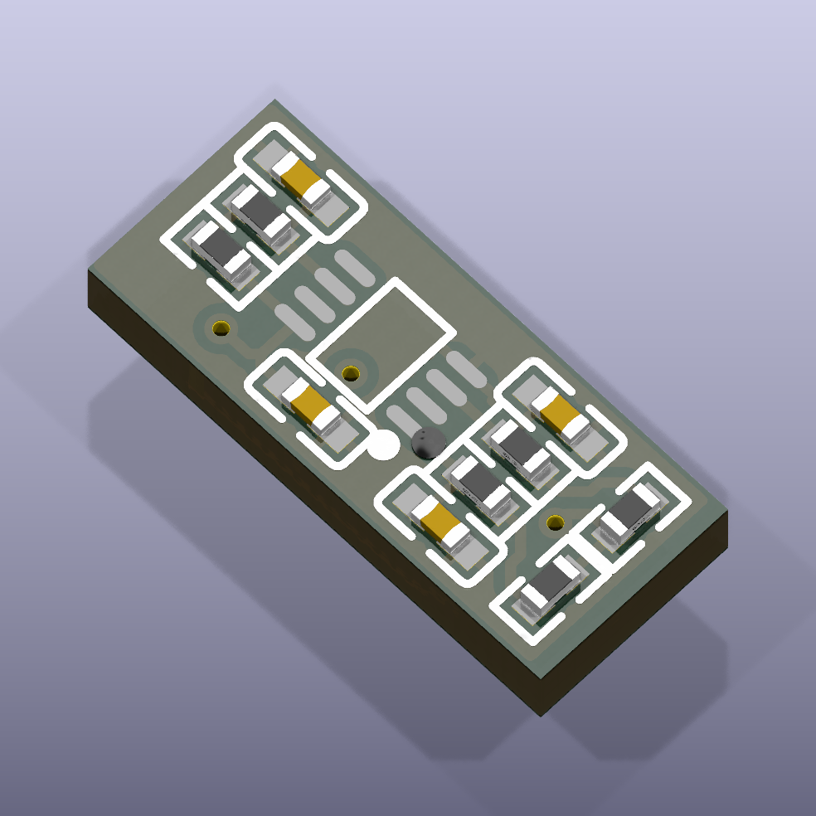
[picture p41: packages/switches/assets/rotary_encoder_advanced.png]
rotary_encoder_advanced
|  | rotary_encoder_advanced | Rotary encoder + switchwith debouncing and hysteresis.<br><br> Specialize the rotary encoder in your application:<br> rot_encoder = new RotaryEncoderAdvanced<br> rot_encoder.encoder -> ALPSALPINE_EC11E15244B2 | |
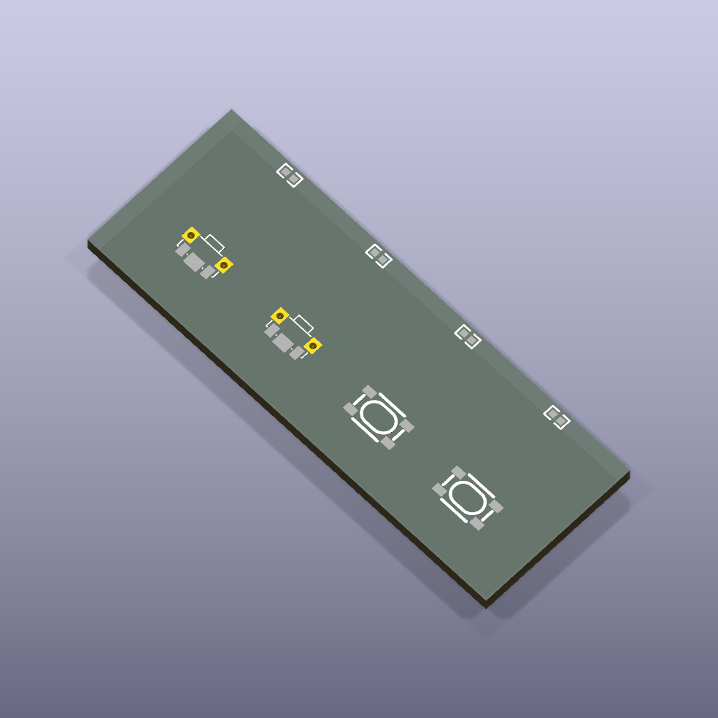
[picture p42: packages/switches/assets/test.png]
test
|  | test | Test module for buttons | |
| [texas_instruments_lm66200](packages/texas_instruments_lm66200/README.md) | 1 module | Texas Instruments LM66200DRLR 1.6 V to 5 V, 2.5-A Dual Ideal Diode With Automatic Switchover | 0.1.1 |
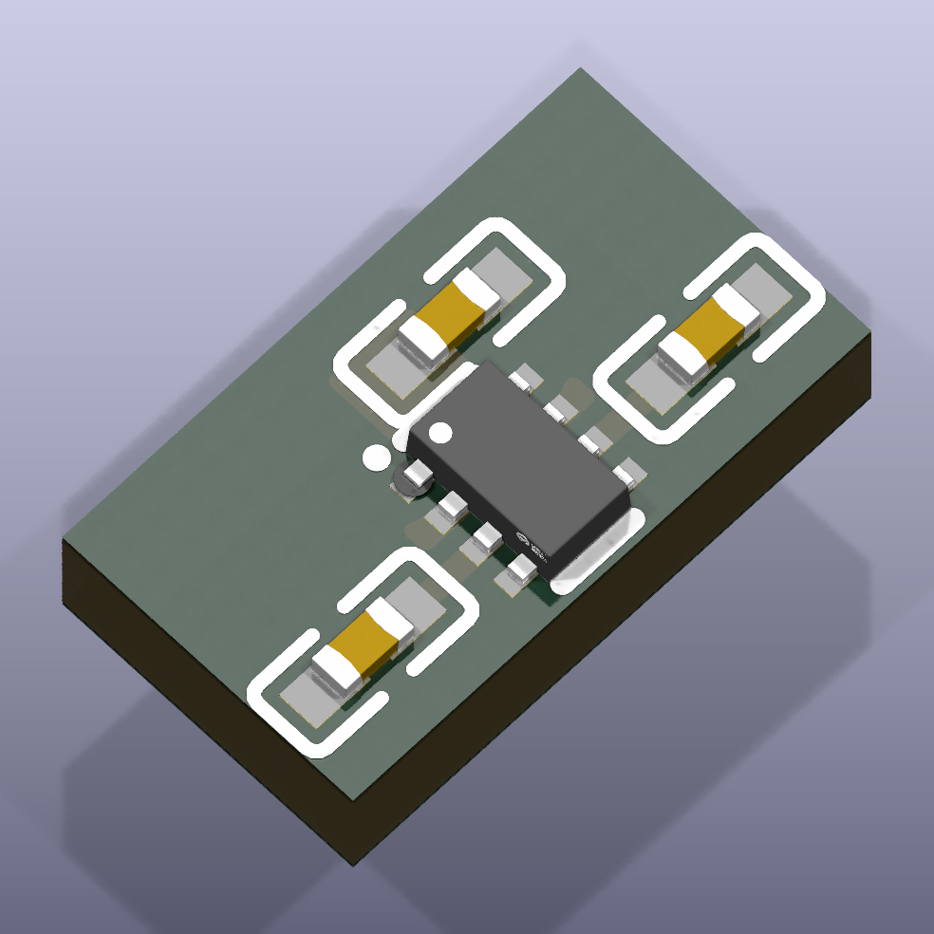
[picture p43: packages/texas_instruments_lm66200/assets/lm66200.png]
lm66200
|  | lm66200 | Texas Instruments LM66200 dual ideal diode with automatic switchover.<br> - Input voltage range: 1.6 V to 5.5 V<br> - Maximum continuous current: 2.5 A<br> - On-resistance: 40 mΩ (typical)<br> - Standby current: 50 nA (typical)<br> - Quiescent current: 1.32 μA (typical)<br> - Automatic diode switchover<br> - Controlled output slew rate:<br> - 1.3 ms (typical) at 3.3 V.<br> - Reverse current blocking when VOUT > VINx.<br> - Thermal shutdown. | |
| [usb](packages/usb/README.md) | 4 modules | USB connectors and circuitry | 0.3.1 |
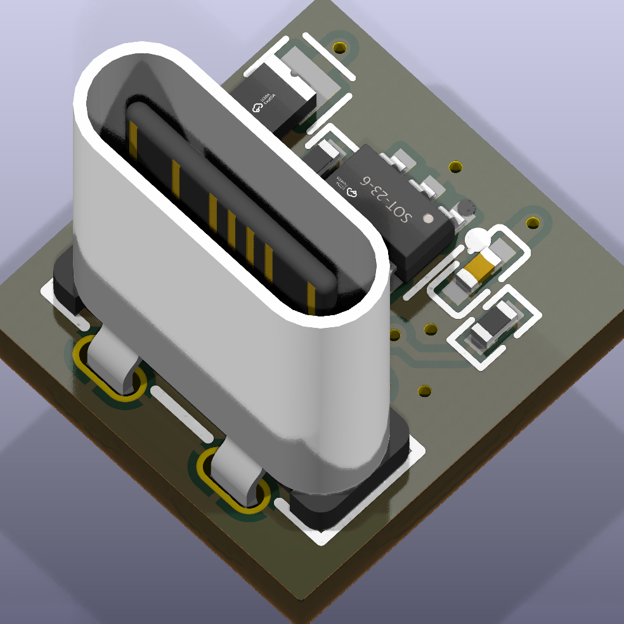
[picture p44: packages/usb/assets/usb_2_0_type_c_data_power_vertical_connector.png]
usb_2_0_type_c_data_power_vertical_connector
|  | usb_2_0_type_c_data_power_vertical_connector | USB 2.0 Type-C connector<br> - 5V PD compatible<br> - ESD protection<br> - Fuse [500mA(hold), 1A(trip)]<br> - Vertical USB Type-C connector | |
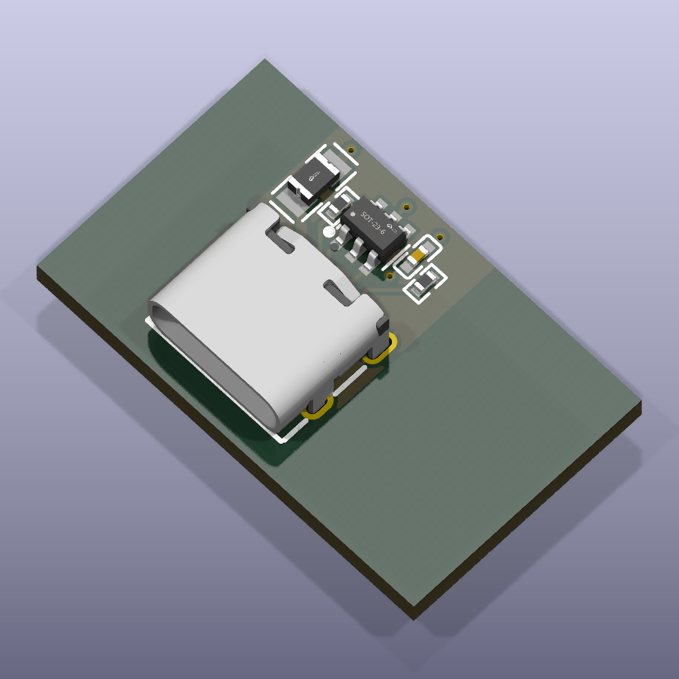
[picture p45: packages/usb/assets/usb_2_0_type_c_data_power_horizontal_connector.png]
usb_2_0_type_c_data_power_horizontal_connector
|  | usb_2_0_type_c_data_power_horizontal_connector | USB 2.0 Type-C connector<br> - 5V PD compatible<br> - ESD protection<br> - Fuse [500mA(hold), 1A(trip)]<br> - Horizontal USB Type-C connector | |
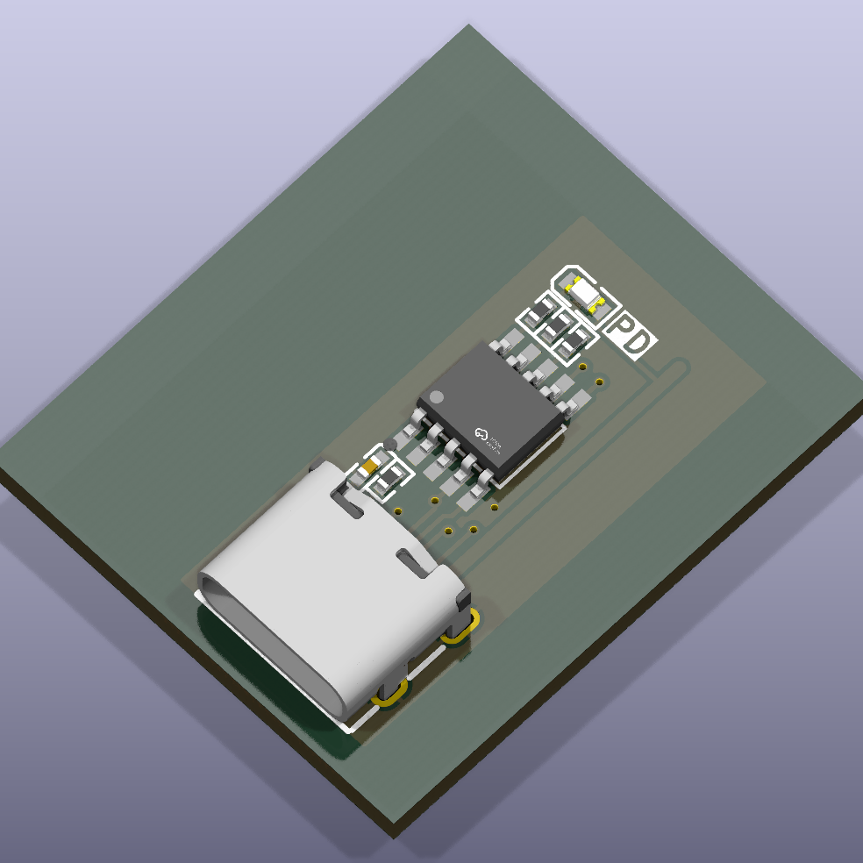
[picture p46: packages/usb/assets/usb_pd_power_sink_horizontal_connector.png]
usb_pd_power_sink_horizontal_connector
|  | usb_pd_power_sink_horizontal_connector | USB PD power sink with Horizontal Type-C connector<br><br> Set the requested PD voltages as follows:<br> 9V  -> resistance = 6.8kohm<br> 12V -> resistance = 24kohm<br> 15V -> resistance = 56kohm<br> 20V -> resistance = DNP<br> pd_sink = new USBPDPowerSink<br> pd_sink.pd_trigger.voltage_set_resistor.resistance = 56kohm +/- 1% | |
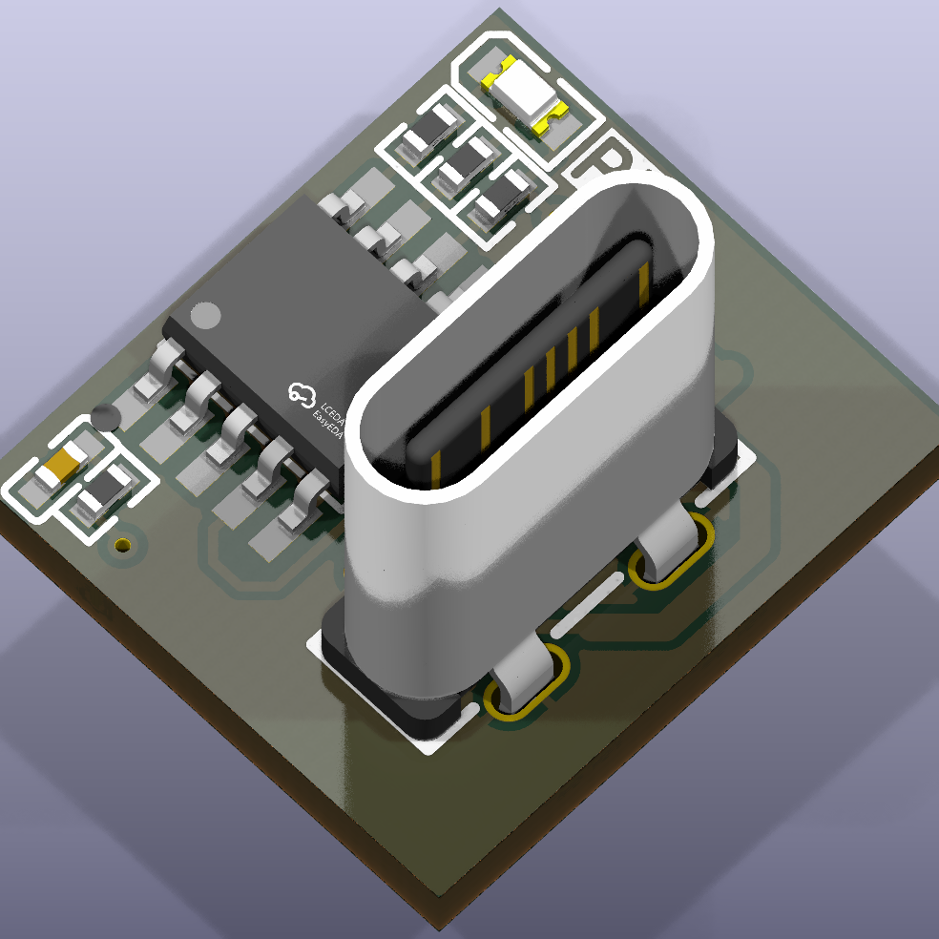
[picture p47: packages/usb/assets/usb_pd_power_sink_vertical_connector.png]
usb_pd_power_sink_vertical_connector
|  | usb_pd_power_sink_vertical_connector | USB PD power sink with Vertical Type-C connector<br><br> Set the requested PD voltages as follows:<br> 9V  -> resistance = 6.8kohm<br> 12V -> resistance = 24kohm<br> 15V -> resistance = 56kohm<br> 20V -> resistance = DNP<br> pd_sink = new USBPDPowerSink<br> pd_sink.pd_trigger.voltage_set_resistor.resistance = 56kohm +/- 1% | |
