ruben-iteng/ato-library/packages/analog-devices-max14778/README.md

# analog-devices-max14778

Analog Devices MAX14778 dual 4:1 +/-25V above/below the rails analog multiplexer

## Package Information

- Version: 0.1.2
- Total Modules: 1
- Author(s): Ruben Baldewsing
- License: MIT
- Homepage: https://github.com/ruben-iteng/ato-library/blob/main/packages/analog-devices-max14778/README.md

## Available Modules

### Module List

| Image | Module | Description |
|---|---|---|
|analog_devices_max14778_driver| analog_devices_max14778_driver | Analog Devices MAX14778 dual 4:1 +/-25V above/below the rails analog multiplexer |
