ruben-iteng/ato-library/packages/esp32c3/README.md

# esp32c3

ESP32 C3 microcontroller

## Package Information

- Version: 0.2.3
- Total Modules: 2
- Author(s): Ruben Baldewsing
- License: MIT
- Homepage: https://github.com/ruben-iteng/ato-library/blob/main/packages/esp32c3/README.md

## Available Modules

### Module List

| Image | Module | Description |
|---|---|---|
|esp32_c3_mini_driver| esp32_c3_mini_driver | ESP32 S3 WROOM-1 module with build-in antenna and supporting components |
|esp32_c3_mini_ufl_driver| esp32_c3_mini_ufl_driver | ESP32 S3 WROOM-1 module with u.fl antenna connector and supporting components |
