ruben-iteng/ato-library/packages/esp32s3/README.md

# esp32s3

ESP32 S3 microcontroller

## Package Information

- Version: 0.2.2
- Total Modules: 1
- Author(s): Ruben Baldewsing
- License: MIT
- Homepage: https://github.com/ruben-iteng/ato-library/blob/main/packages/esp32s3/README.md

## Available Modules

### Module List

| Image | Module | Description |
|---|---|---|
|esp32_s3_wroom_driver| esp32_s3_wroom_driver | ESP32 S3 WROOM-1 module with build-in antenna and supporting components<br> - 32MB flash<br> - 2MB PSRAM |
