ruben-iteng/ato-library/packages/ina228/README.md

# ina228

INA228 low voltage power monitor with I2C interface

## Package Information

- Version: 0.2.2
- Total Modules: 1
- Author(s): Ruben Baldewsing
- License: MIT
- Homepage: https://github.com/ruben-iteng/ato-library/blob/main/packages/ina228/README.md

## Available Modules

### Module List

| Image | Module | Description |
|---|---|---|
|ina228| ina228 | INA228 85-V, 20-bit, ultra-precise, I2C output<br> current/voltage/power/energy/charge monitor with alert |
