ruben-iteng/ato-library/packages/ldos/README.md

# ldos

Various Low Dropout Regulators (LDOs)

## Package Information

- Version: 0.2.3
- Total Modules: 1
- Author(s): Ruben Baldewsing
- License: MIT
- Homepage: https://github.com/ruben-iteng/ato-library/blob/main/packages/ldos/README.md

## Available Modules

### Module List

| Image | Module | Description |
|---|---|---|
|5v_to_3v3| 5v_to_3v3 | 5V to 3.3V 600mA (max 1100mA) LDO |
