ruben-iteng/ato-library/packages/switches/README.md

# switches

Rotary encoders, switches, and other switch like components and modules

## Package Information

- Version: 0.1.4
- Total Modules: 2
- Author(s): Ruben Baldewsing
- License: MIT
- Homepage: https://github.com/ruben-iteng/ato-library/blob/main/packages/switches/README.md

## Available Modules

### Module List

| Image | Module | Description |
|---|---|---|
|rotary_encoder_advanced| rotary_encoder_advanced | Rotary encoder + switchwith debouncing and hysteresis.<br><br> Specialize the rotary encoder in your application:<br> rot_encoder = new RotaryEncoderAdvanced<br> rot_encoder.encoder -> ALPSALPINE_EC11E15244B2 |
|test| test | Test module for buttons |
