ruben-iteng/ato-library/packages/logos/README.md

# logos

Various logos

## Package Information

- Version: 0.2.0
- Total Modules: 1
- Author(s): Ruben Baldewsing
- License: MIT
- Homepage: https://github.com/ruben-iteng/ato-library/blob/main/packages/logos/README.md

## Available Modules

### Module List

| Image | Module | Description |
|---|---|---|
|faebryk_logo_8x9mm| faebryk_logo_8x9mm | faebryk Logo 8x9mm |
