ruben-iteng/ato-library/packages/connectors/parts/Sparkfun_QWIIC_Logo/README.md

QWIIC logo aquired from https://www.sparkfun.com/qwiic
https://cdn.sparkfun.com/assets/custom_pages/2/7/2/SparkFun_Qwiic_Logo_-_KiCad.zip
at 2025-05-11
