ruben-iteng/ato-library/packages/analog-devices-max14778/parts/FH_0603B104K101NT/C0603_L1.6-W0.8-H0.8.step

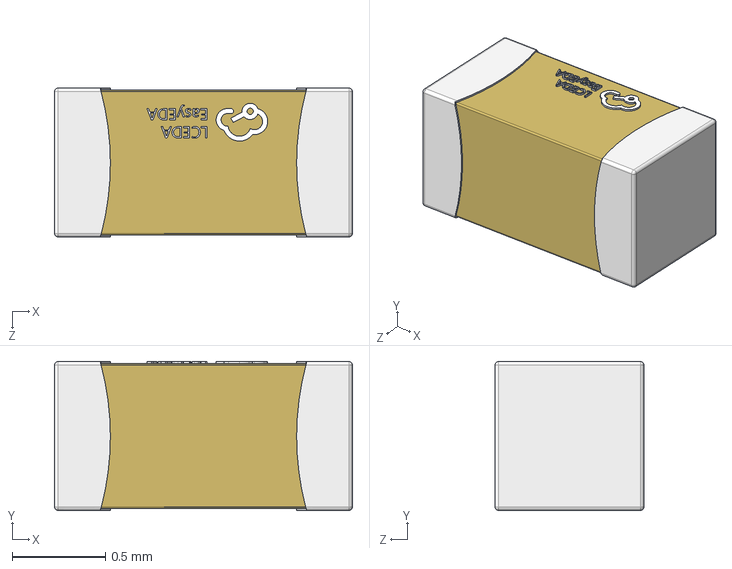
[picture p49: CAD file, 2025-06-28]
packages/analog-devices-max14778/parts/FH_0603B104K101NT/C0603_L1.6-W0.8-H0.8.step
1.60 x 0.8 x 0.8 mm
