ruben-iteng/ato-library/packages/analog-devices-max14778/parts/Maxim_Integrated_MAX14778ETP_T/TQFN-20_L5.0-W5.0-P0.65-TL-EP3.1.step

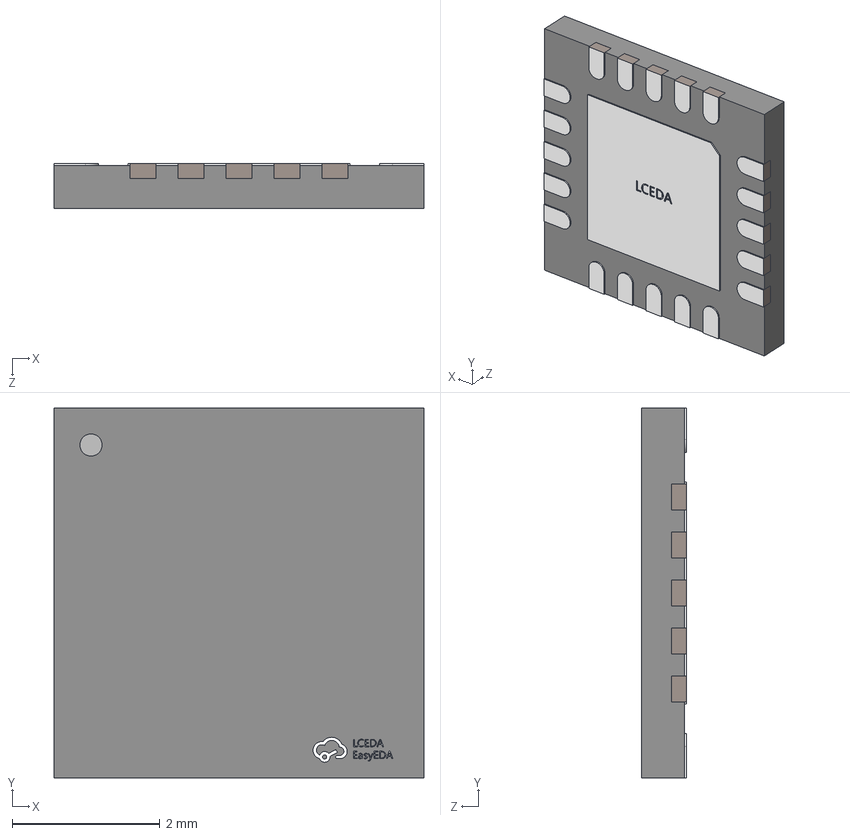
[picture p50: CAD file, 2025-06-28]
packages/analog-devices-max14778/parts/Maxim_Integrated_MAX14778ETP_T/TQFN-20_L5.0-W5.0-P0.65-TL-EP3.1.step
5.00 x 5.00 x 0.606 mm
