ruben-iteng/ato-library/packages/analog-devices-max14778/parts/Samsung_Electro_Mechanics_CL05B104KO5NNNC/C0402_L1.0-W0.5-H0.5.step

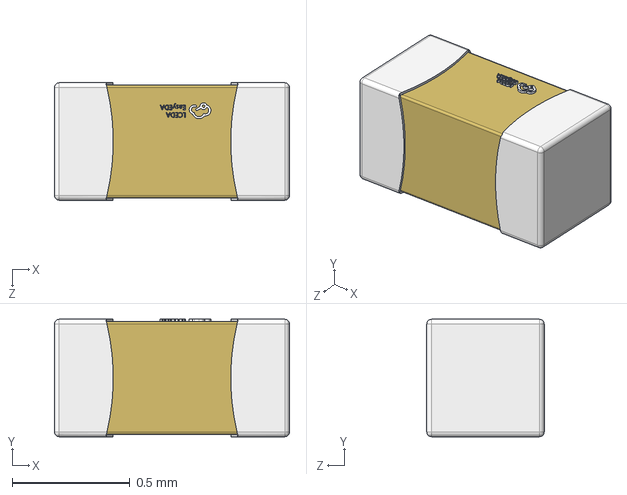
[picture p51: CAD file, 2025-04-13]
packages/analog-devices-max14778/parts/Samsung_Electro_Mechanics_CL05B104KO5NNNC/C0402_L1.0-W0.5-H0.5.step
1.00 x 0.5 x 0.5 mm
