ruben-iteng/ato-library/packages/connectors/parts/Changzhou_Amass_Elec_24_245_1/ANT-TH_L33.0-W12.0_RED.step

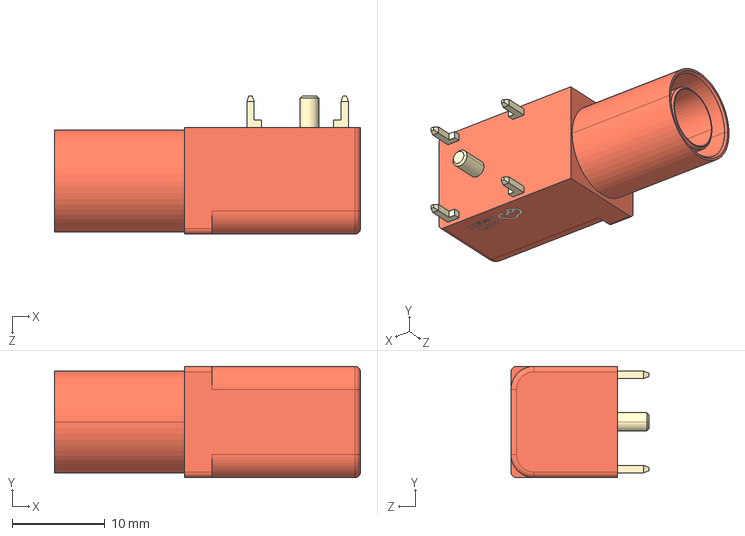
[picture p52: CAD file, 2025-06-28]
packages/connectors/parts/Changzhou_Amass_Elec_24_245_1/ANT-TH_L33.0-W12.0_RED.step
33.0 x 12.0 x 14.9 mm
