ruben-iteng/ato-library/packages/connectors/parts/HCTL_HC_2510_4A/CONN-TH_4P-P2.54_HCTL_HC-2510-4A.step

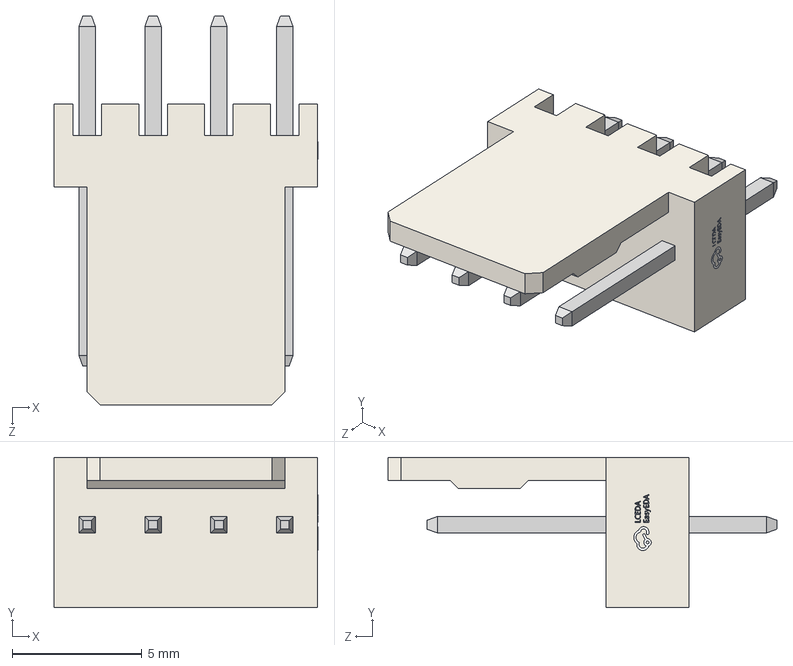
[picture p53: CAD file, 2025-05-20]
packages/connectors/parts/HCTL_HC_2510_4A/CONN-TH_4P-P2.54_HCTL_HC-2510-4A.step
10.2 x 5.80 x 15.0 mm
