ruben-iteng/ato-library/packages/connectors/parts/JST_Sales_America_BM04B_SRSS_TB_LF__SN/CONN-SMD_4P-L6.0-W2.9-H4.3-P1.0.step

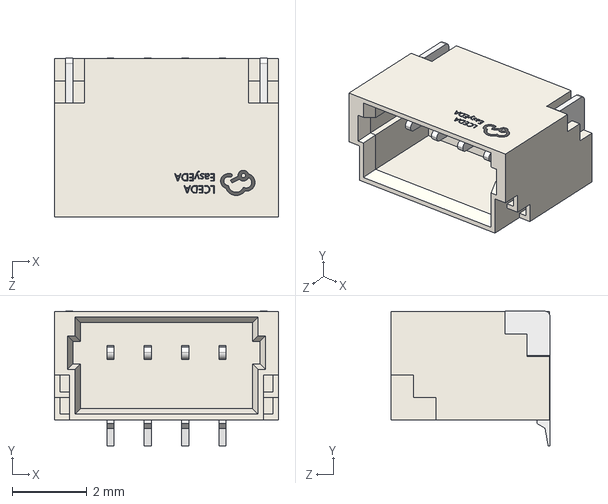
[picture p54: CAD file, 2025-06-28]
packages/connectors/parts/JST_Sales_America_BM04B_SRSS_TB_LF__SN/CONN-SMD_4P-L6.0-W2.9-H4.3-P1.0.step
6.00 x 3.61 x 4.26 mm
