ruben-iteng/ato-library/packages/connectors/parts/JST_Sales_America_SM04B_SRSS_TB_LF__SN/CONN-SMD_SR1.00-WS-4P.step

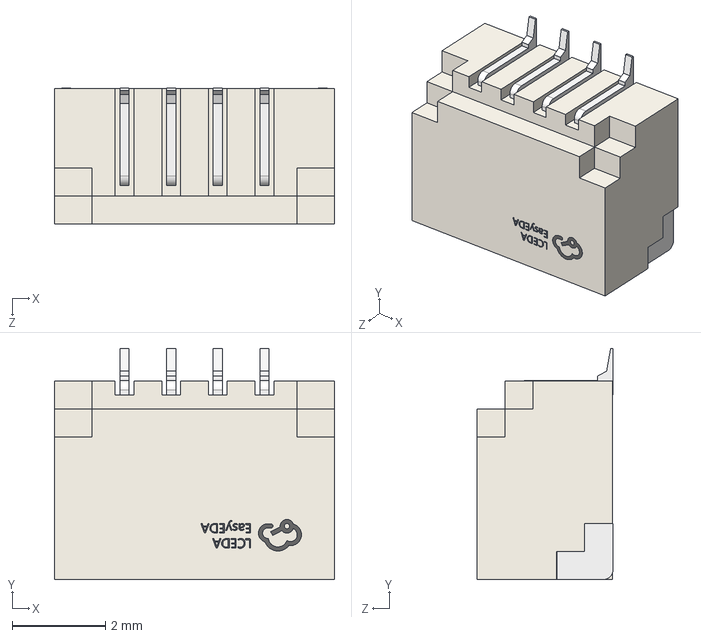
[picture p55: CAD file, 2025-06-28]
packages/connectors/parts/JST_Sales_America_SM04B_SRSS_TB_LF__SN/CONN-SMD_SR1.00-WS-4P.step
6.00 x 4.95 x 2.91 mm
