ruben-iteng/ato-library/packages/connectors/parts/PINREX_744_81_04TG20/CONN-TH_4P-P2.54-V-M_744-81-04TXXX.step

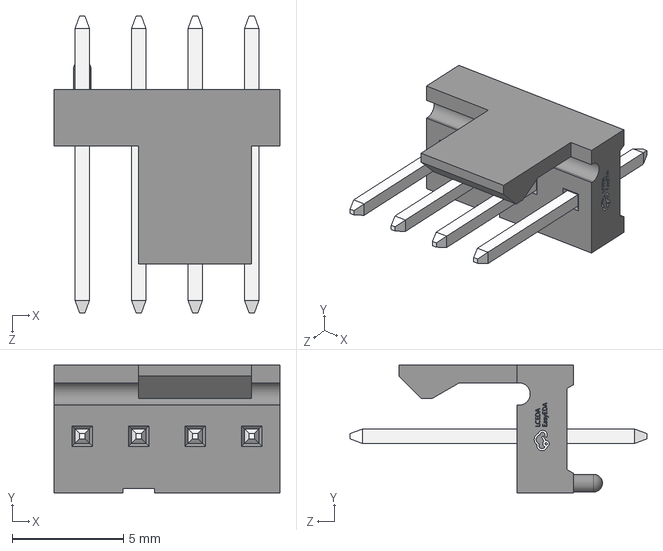
[picture p56: CAD file, 2025-06-28]
packages/connectors/parts/PINREX_744_81_04TG20/CONN-TH_4P-P2.54-V-M_744-81-04TXXX.step
10.2 x 5.75 x 13.4 mm
