ruben-iteng/ato-library/packages/dcdc-converters/parts/CCTC_TCC0805X5R226K100FT/C0805_L2.0-W1.3-H1.3.step

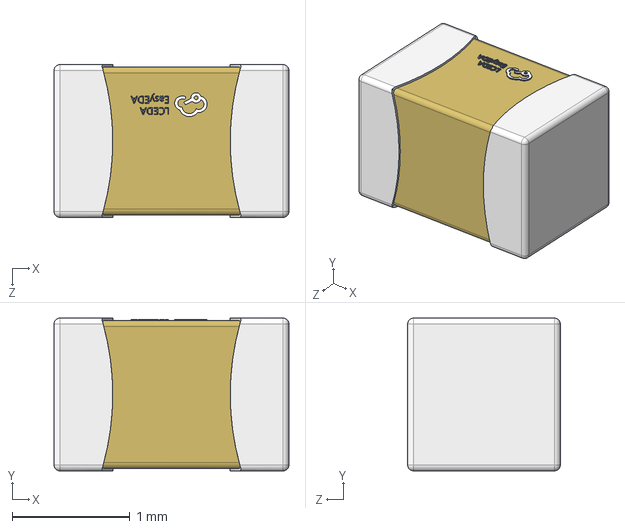
[picture p57: CAD file, 2025-06-28]
packages/dcdc-converters/parts/CCTC_TCC0805X5R226K100FT/C0805_L2.0-W1.3-H1.3.step
2.00 x 1.30 x 1.30 mm
