ruben-iteng/ato-library/packages/dcdc-converters/parts/EVISUN_B0505S_1WR3/PWRM-TH_B0505S-1WR3.step

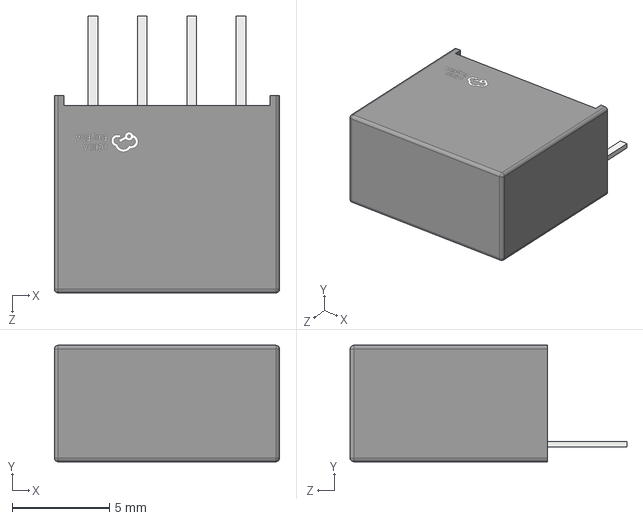
[picture p58: CAD file, 2025-06-28]
packages/dcdc-converters/parts/EVISUN_B0505S_1WR3/PWRM-TH_B0505S-1WR3.step
11.6 x 6.00 x 14.3 mm
