ruben-iteng/ato-library/packages/dcdc-converters/parts/FH_CMH160808B4R7MT/L0603_L1.6-W0.8-H0.5_BEAD.step

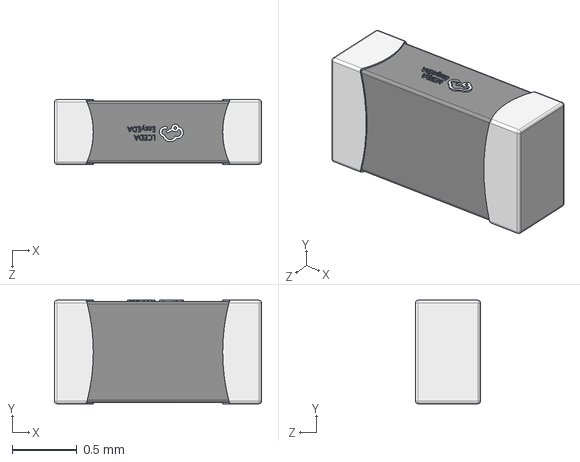
[picture p59: CAD file, 2025-06-28]
packages/dcdc-converters/parts/FH_CMH160808B4R7MT/L0603_L1.6-W0.8-H0.5_BEAD.step
1.60 x 0.8 x 0.5 mm
