ruben-iteng/ato-library/packages/dcdc-converters/parts/MONOLITHIC_POWER_SYSTEMS_INC_MPM3610GQV_Z/QFN-20_L5.0-W3.0-TL-MPM3610GQV-Z.STEP

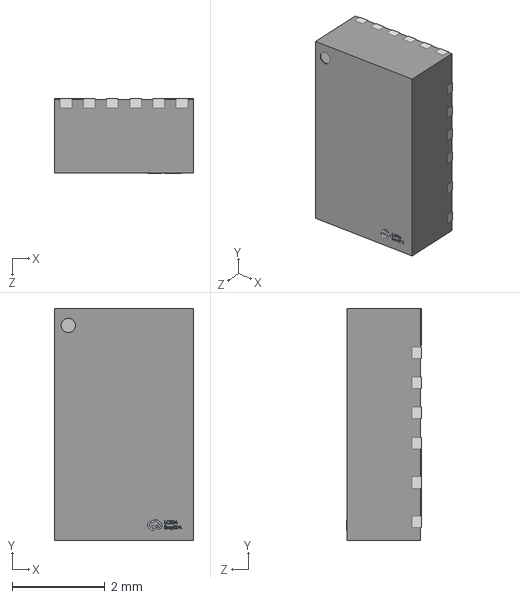
[picture p60: CAD file, 2025-06-28]
packages/dcdc-converters/parts/MONOLITHIC_POWER_SYSTEMS_INC_MPM3610GQV_Z/QFN-20_L5.0-W3.0-TL-MPM3610GQV-Z.STEP
3.00 x 5.00 x 1.61 mm
