ruben-iteng/ato-library/packages/dcdc-converters/parts/STE_R06B1B271KN0B0S0N0/CAP-TH_L6.0-W2.5-P5.0.step

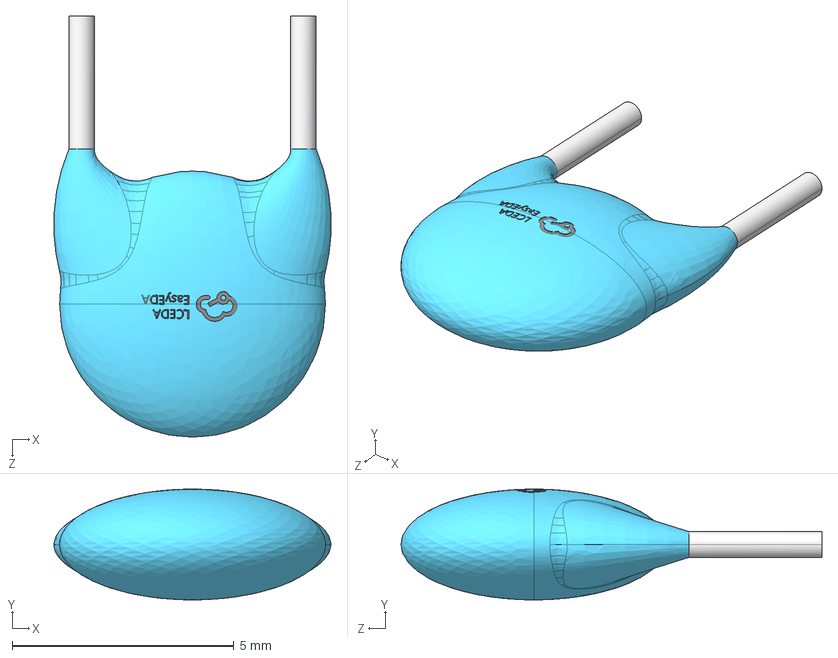
[picture p61: CAD file, 2025-06-28]
packages/dcdc-converters/parts/STE_R06B1B271KN0B0S0N0/CAP-TH_L6.0-W2.5-P5.0.step
6.25 x 2.50 x 9.50 mm
