ruben-iteng/ato-library/packages/dcdc-converters/parts/UNI_ROYAL_0402WGF1003TCE/R0402_L1.0-W0.5-H0.4.step

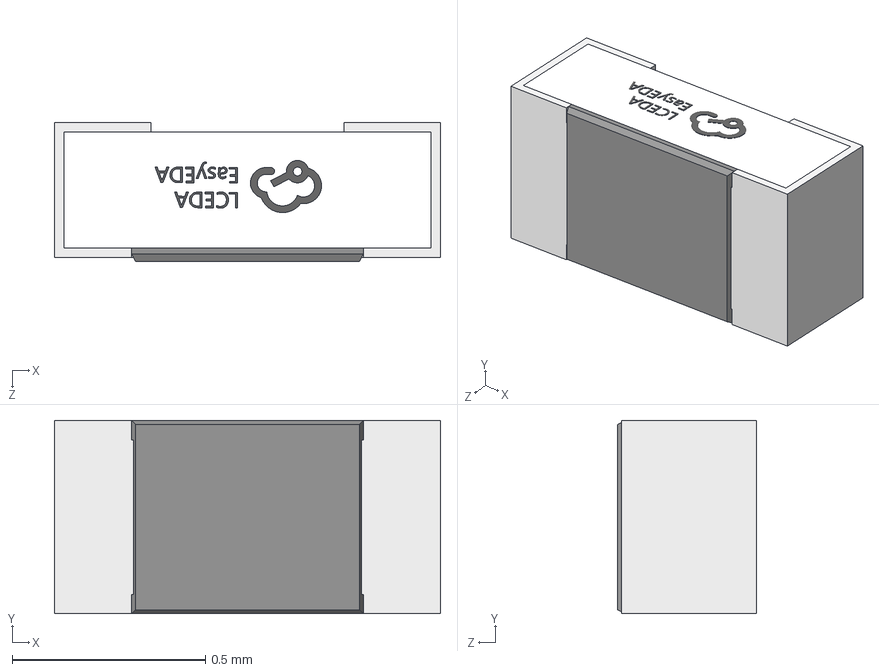
[picture p62: CAD file, 2025-04-13]
packages/dcdc-converters/parts/UNI_ROYAL_0402WGF1003TCE/R0402_L1.0-W0.5-H0.4.step
1.00 x 0.501 x 0.36 mm
