ruben-iteng/ato-library/packages/debug-interfaces/parts/Liansheng_BH_00019/CONN-SMD_20P-P2.54_BH-00019.step

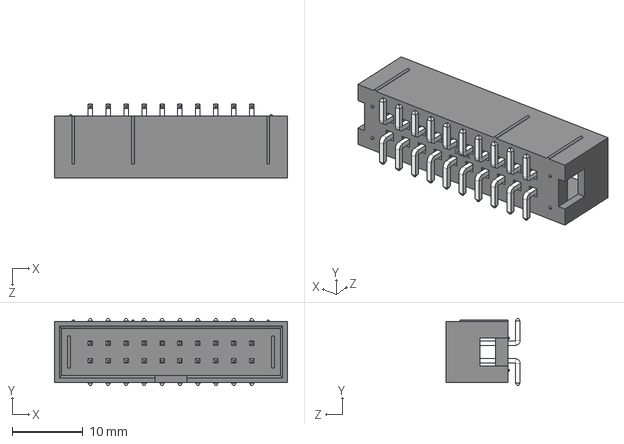
[picture p63: CAD file, 2025-06-28]
packages/debug-interfaces/parts/Liansheng_BH_00019/CONN-SMD_20P-P2.54_BH-00019.step
33.0 x 9.50 x 10.5 mm
