ruben-iteng/ato-library/packages/debug-interfaces/parts/Samtec_FTSH_105_01_L_DV_K_TR/CONN-SMD_FTSH-105-01-L-DV-K-TR.step

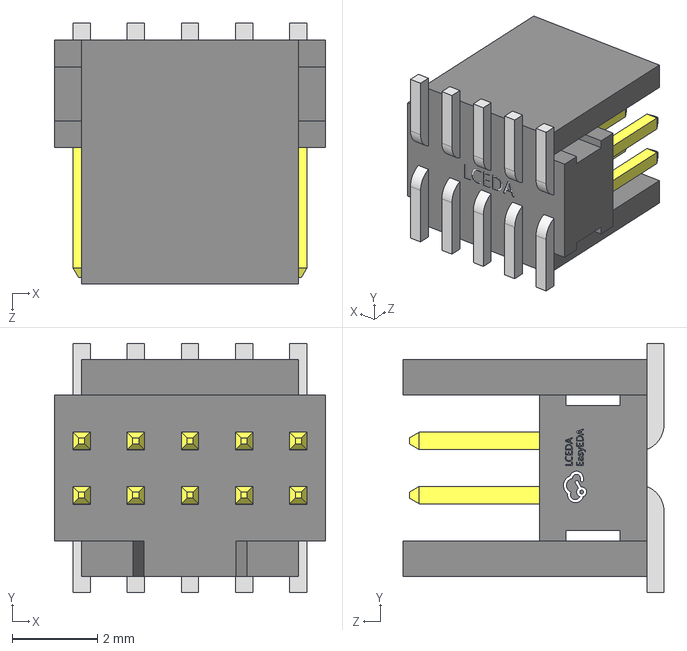
[picture p64: CAD file, 2025-04-13]
packages/debug-interfaces/parts/Samtec_FTSH_105_01_L_DV_K_TR/CONN-SMD_FTSH-105-01-L-DV-K-TR.step
6.35 x 5.84 x 6.12 mm
