ruben-iteng/ato-library/packages/debug-interfaces/parts/SEGGER_JLink_Compact/J_Link_Compact_V1.0A.step

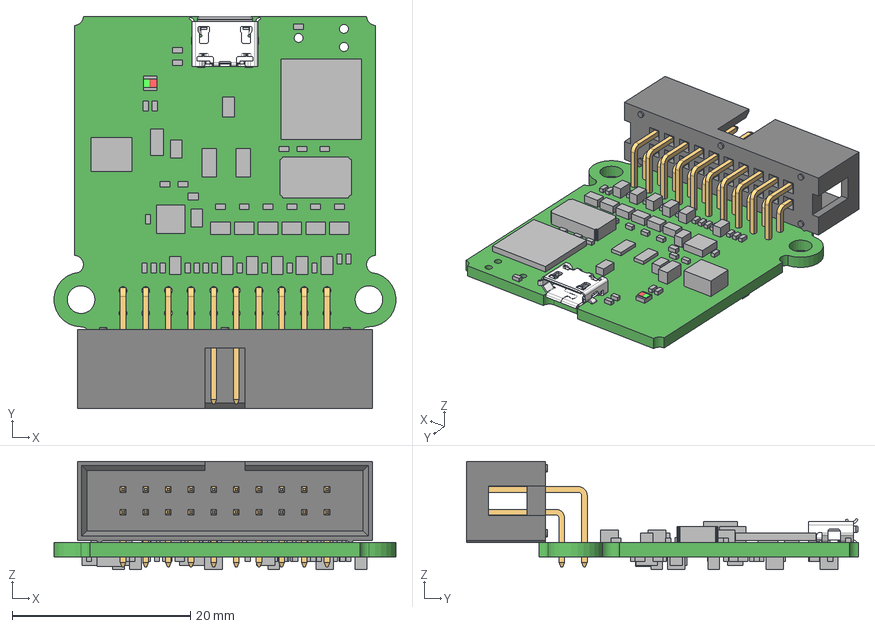
[picture p65: CAD file, 2025-05-24]
packages/debug-interfaces/parts/SEGGER_JLink_Compact/J_Link_Compact_V1.0A.step
38.3 x 44.0 x 12.2 mm
