ruben-iteng/ato-library/packages/debug-interfaces/parts/Sinhoo_SMTSO2530CTJ/SMD_BD5.6-L5.6-W5.6-D4.1.step

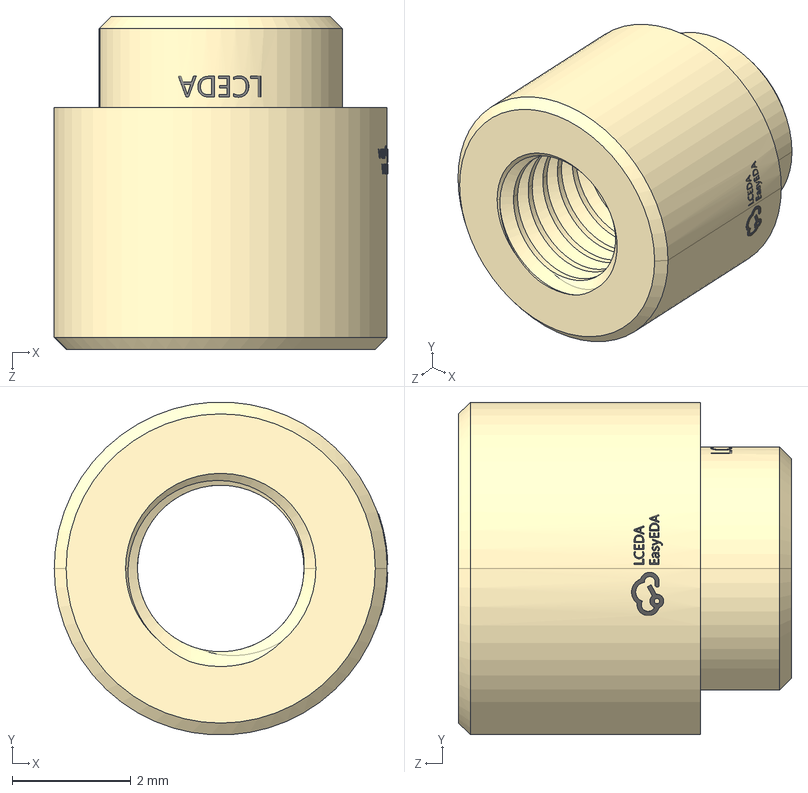
[picture p66: CAD file, 2025-06-28]
packages/debug-interfaces/parts/Sinhoo_SMTSO2530CTJ/SMD_BD5.6-L5.6-W5.6-D4.1.step
5.61 x 5.59 x 5.60 mm
