ruben-iteng/ato-library/packages/esp32c3/parts/Espressif_Systems_ESP32_C3_MINI_1_N4/WIFIM-SMD_ESP32-C3-MINI-1.step

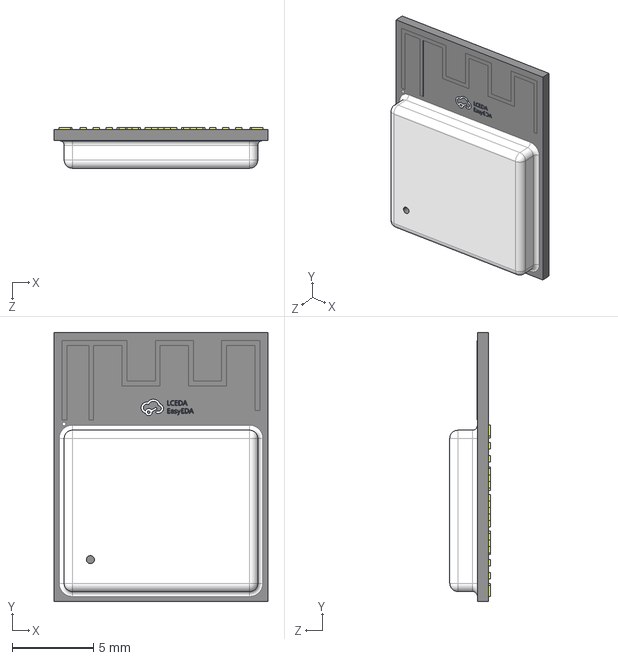
[picture p68: CAD file, 2025-06-28]
packages/esp32c3/parts/Espressif_Systems_ESP32_C3_MINI_1_N4/WIFIM-SMD_ESP32-C3-MINI-1.step
13.2 x 16.6 x 2.50 mm
