ruben-iteng/ato-library/packages/esp32c3/parts/Espressif_Systems_ESP32_C3_MINI_1U_H4/WIFIM-SMD_ESP32-C3-MINI-MINI-1U.step

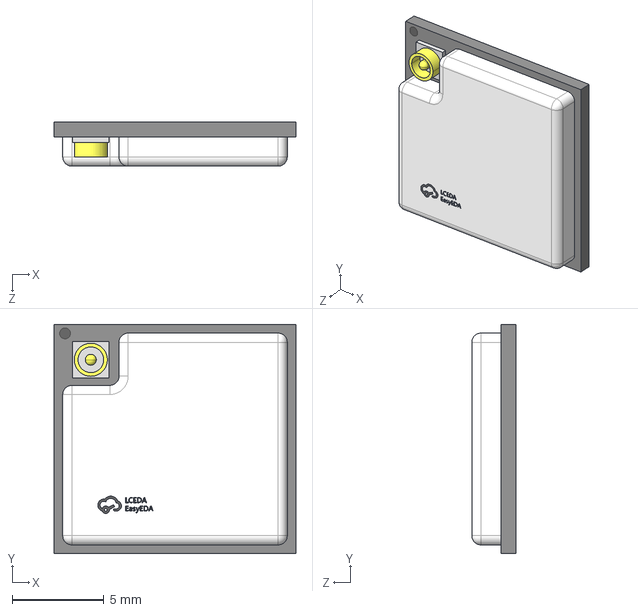
[picture p69: CAD file, 2025-06-28]
packages/esp32c3/parts/Espressif_Systems_ESP32_C3_MINI_1U_H4/WIFIM-SMD_ESP32-C3-MINI-MINI-1U.step
13.2 x 12.5 x 2.42 mm
