ruben-iteng/ato-library/packages/esp32s3/parts/Espressif_Systems_ESP32_S3_WROOM_1_N16R2/WIRELM-SMD_ESP32-S3-WROOM-1.STEP

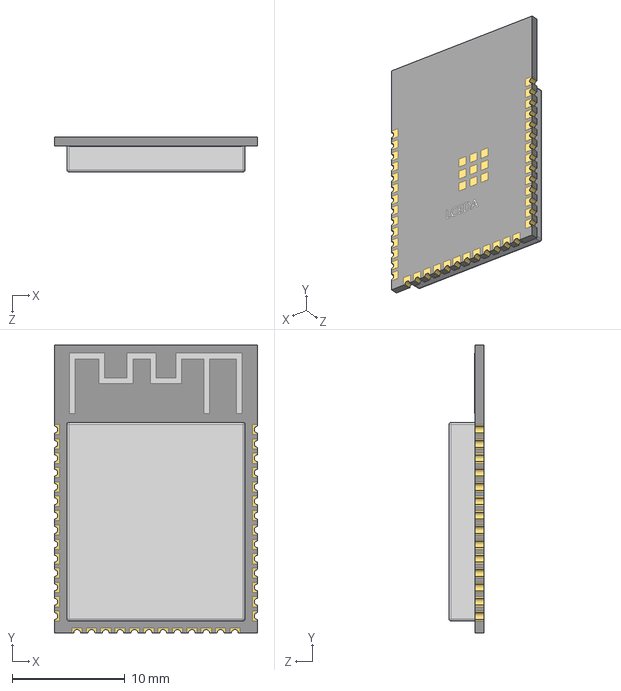
[picture p70: CAD file, 2025-06-28]
packages/esp32s3/parts/Espressif_Systems_ESP32_S3_WROOM_1_N16R2/WIRELM-SMD_ESP32-S3-WROOM-1.STEP
18.0 x 25.5 x 3.11 mm
