ruben-iteng/ato-library/packages/ina228/parts/TA_I_Tech_RLP25FEGR015/R2512_L6.3-W3.2-H0.6.step

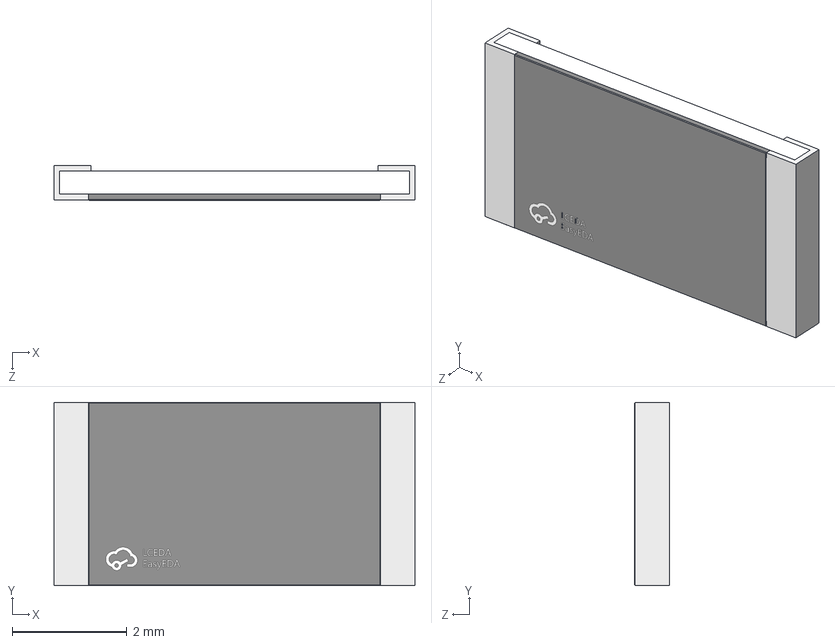
[picture p71: CAD file, 2025-06-28]
packages/ina228/parts/TA_I_Tech_RLP25FEGR015/R2512_L6.3-W3.2-H0.6.step
6.30 x 3.20 x 0.611 mm
