ruben-iteng/ato-library/packages/ina228/parts/Texas_Instruments_INA228AIDGSR/VSSOP-10_L3.0-W3.0-H1.1-LS4.9-P0.50.step

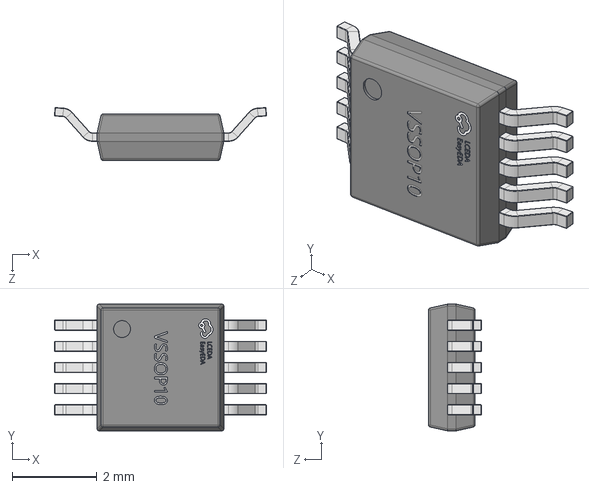
[picture p72: CAD file, 2025-06-28]
packages/ina228/parts/Texas_Instruments_INA228AIDGSR/VSSOP-10_L3.0-W3.0-H1.1-LS4.9-P0.50.step
5.01 x 3.00 x 1.25 mm
