ruben-iteng/ato-library/packages/ldos/parts/TECH_PUBLIC_TPAP2112K_3_3TRG1/SOT-23-5_L2.9-W1.6-P0.95-LS2.8-BR.step

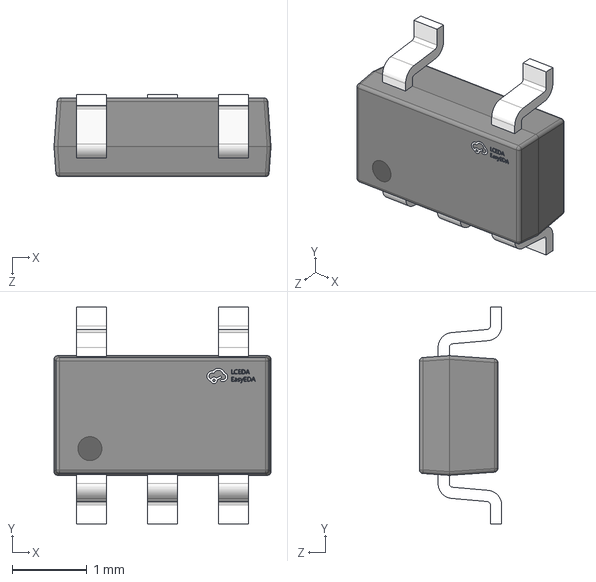
[picture p73: CAD file, 2025-06-28]
packages/ldos/parts/TECH_PUBLIC_TPAP2112K_3_3TRG1/SOT-23-5_L2.9-W1.6-P0.95-LS2.8-BR.step
2.90 x 2.90 x 1.10 mm
