ruben-iteng/ato-library/packages/leds/parts/Changzhou_Amass_Elec_XT30PW_2_2__M_G_B/CONN-TH_4P-XT30PW-M.STEP

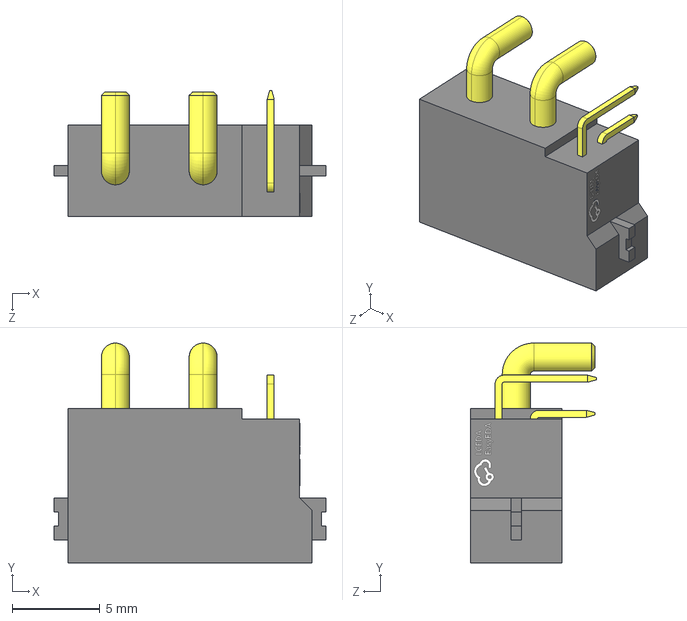
[picture p74: CAD file, 2025-06-28]
packages/leds/parts/Changzhou_Amass_Elec_XT30PW_2_2__M_G_B/CONN-TH_4P-XT30PW-M.STEP
15.5 x 12.5 x 7.17 mm
