ruben-iteng/ato-library/packages/logic/parts/Texas_Instruments_ISO1540DR/SOIC-8_L4.9-W3.9-H1.7-LS6.0-P1.27.step

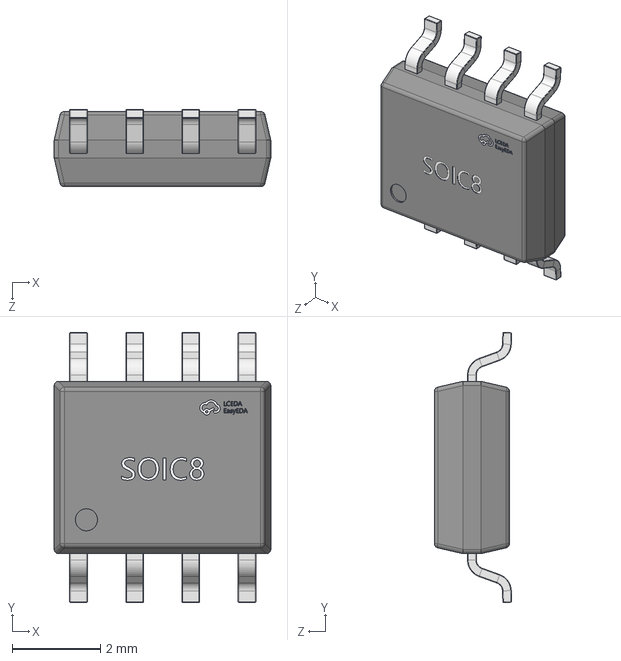
[picture p75: CAD file, 2025-06-28]
packages/logic/parts/Texas_Instruments_ISO1540DR/SOIC-8_L4.9-W3.9-H1.7-LS6.0-P1.27.step
4.90 x 6.11 x 1.75 mm
