ruben-iteng/ato-library/packages/logic/parts/Texas_Instruments_SN74CB3Q3251PWR/TSSOP-16_L5.0-W4.4-P0.64-LS6.4-BL.step

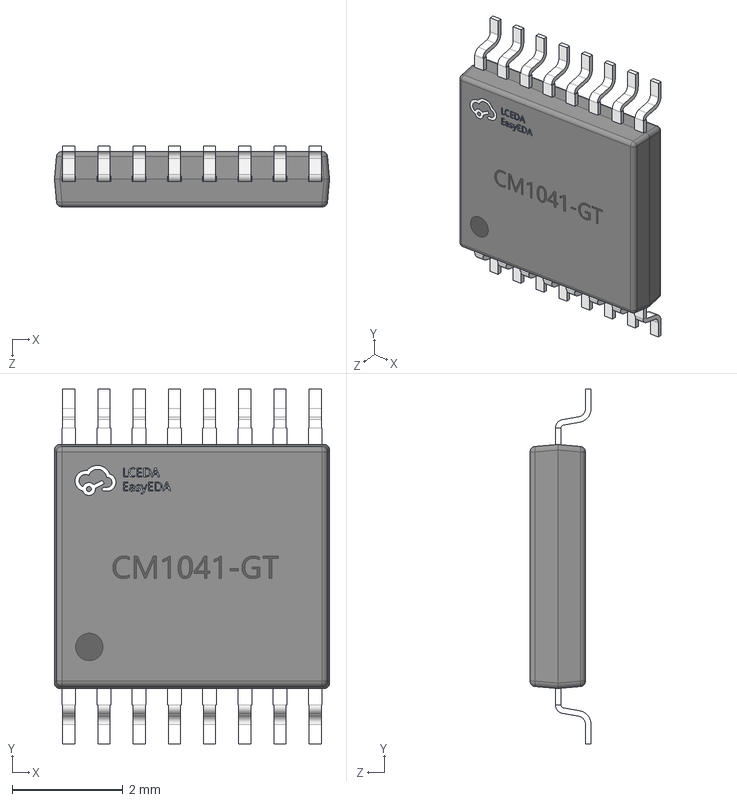
[picture p76: CAD file, 2025-06-28]
packages/logic/parts/Texas_Instruments_SN74CB3Q3251PWR/TSSOP-16_L5.0-W4.4-P0.64-LS6.4-BL.step
4.96 x 6.40 x 1.10 mm
