ruben-iteng/ato-library/packages/logic/parts/Texas_Instruments_SN74LVC3G14DCUR/VSSOP-8_L2.3-W2.0-P0.50-LS3.1-BL.step

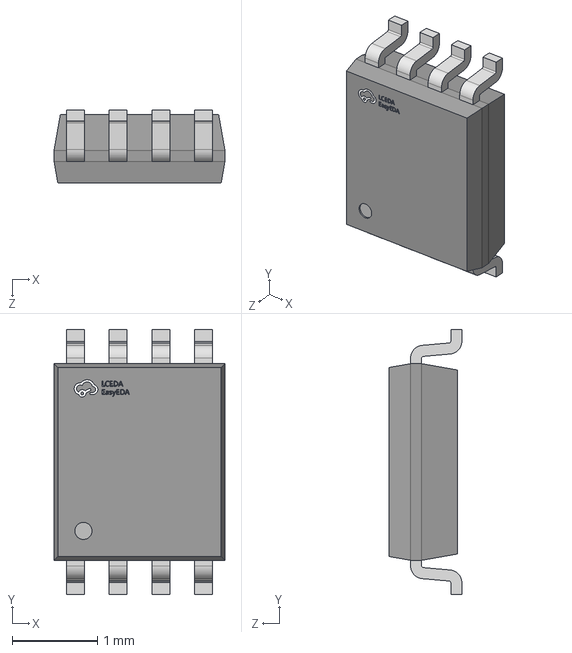
[picture p77: CAD file, 2025-06-28]
packages/logic/parts/Texas_Instruments_SN74LVC3G14DCUR/VSSOP-8_L2.3-W2.0-P0.50-LS3.1-BL.step
2.00 x 3.10 x 0.851 mm
