ruben-iteng/ato-library/packages/logic/parts/UMW_SN74LVC2G34DBVR_UMW/SOT-23-6_L2.9-W1.6-H1.5-LS2.8-P0.95.step

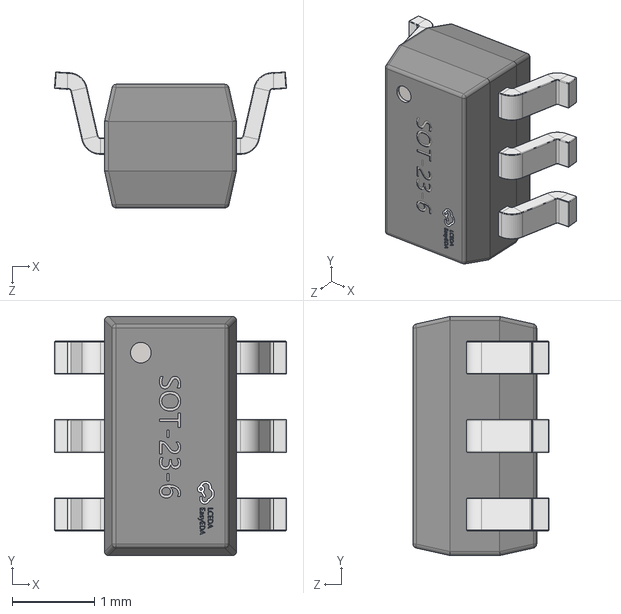
[picture p78: CAD file, 2025-06-28]
packages/logic/parts/UMW_SN74LVC2G34DBVR_UMW/SOT-23-6_L2.9-W1.6-H1.5-LS2.8-P0.95.step
2.81 x 2.90 x 1.65 mm
