ruben-iteng/ato-library/packages/microchip-emc2101/parts/KEC_Semicon_2N3906S_RTK_PS/SOT-23-3P_L2.9-W1.3-H1.0-LS2.4-P0.95.step

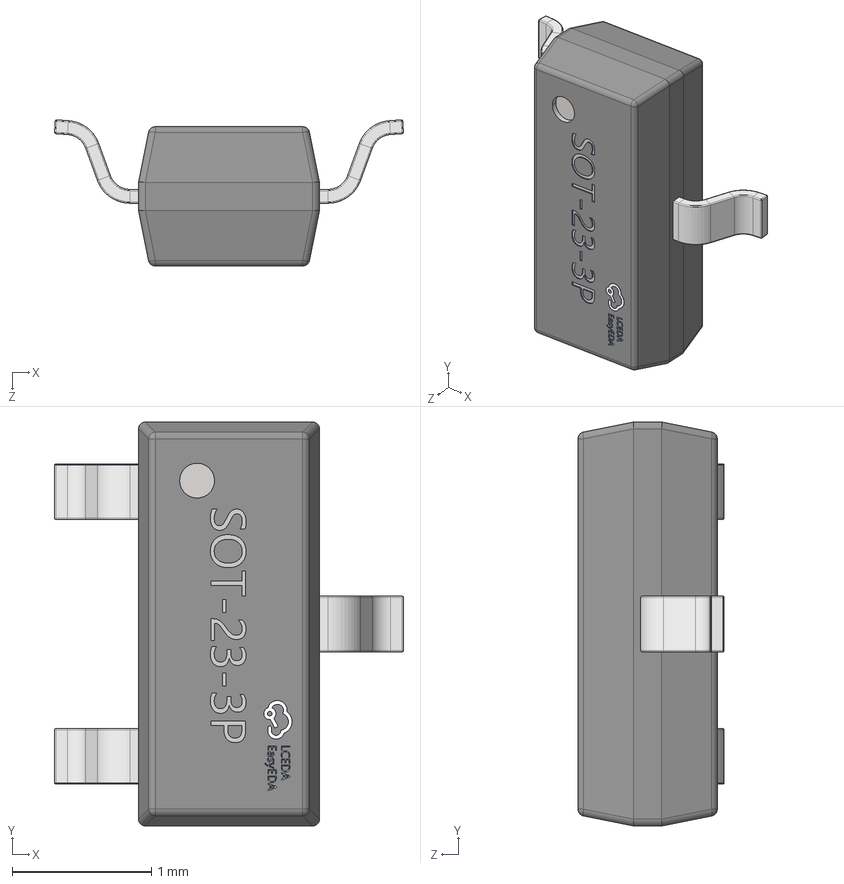
[picture p79: CAD file, 2025-06-28]
packages/microchip-emc2101/parts/KEC_Semicon_2N3906S_RTK_PS/SOT-23-3P_L2.9-W1.3-H1.0-LS2.4-P0.95.step
2.51 x 2.90 x 1.05 mm
