ruben-iteng/ato-library/packages/nxp_semiconductors-pca95xx/parts/NXP_Semicon_PCA9536D_118/SO-8_L4.9-W3.9-P1.27-LS6.0-BL.step

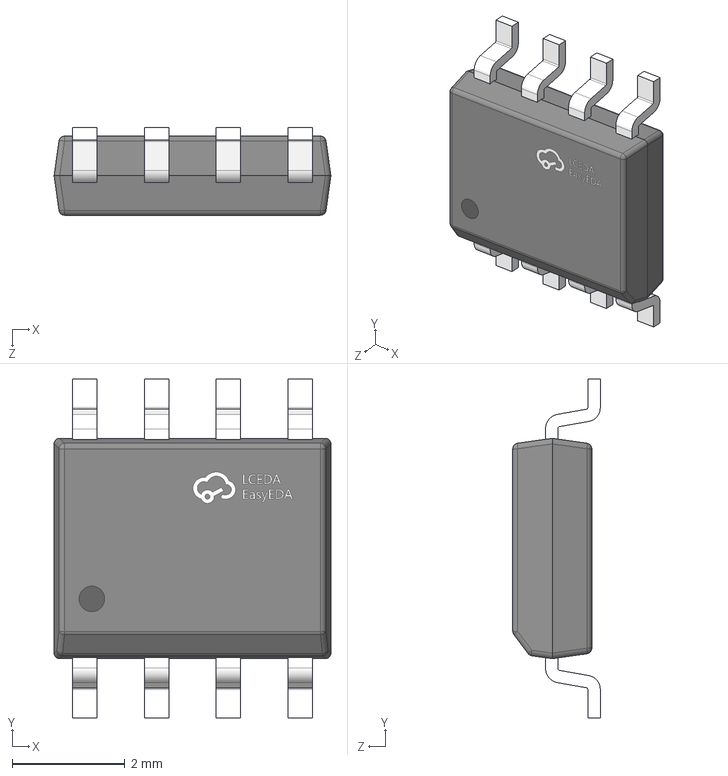
[picture p81: CAD file, 2025-06-28]
packages/nxp_semiconductors-pca95xx/parts/NXP_Semicon_PCA9536D_118/SO-8_L4.9-W3.9-P1.27-LS6.0-BL.step
4.90 x 6.00 x 1.55 mm
