ruben-iteng/ato-library/packages/nxp_semiconductors-pca95xx/parts/NXP_Semicon_PCA9536DP_118/TSSOP-8_L3.0-W3.0-H1.1-LS4.9-P0.65.step

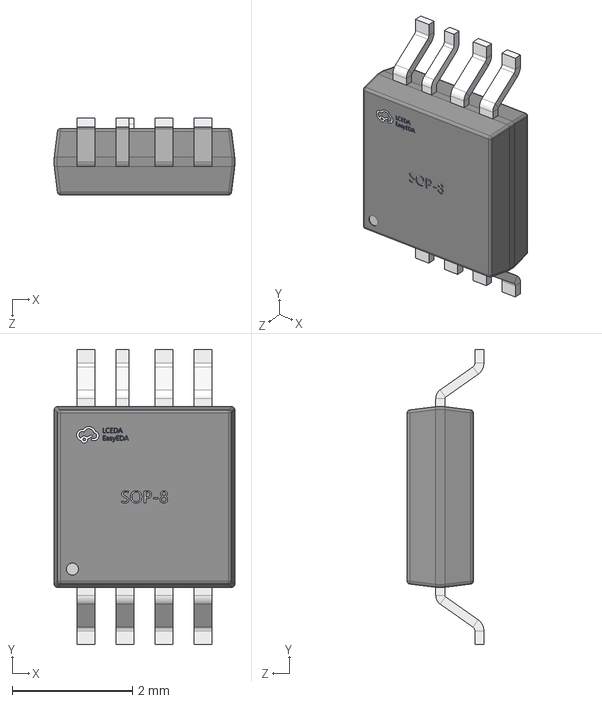
[picture p82: CAD file, 2025-06-28]
packages/nxp_semiconductors-pca95xx/parts/NXP_Semicon_PCA9536DP_118/TSSOP-8_L3.0-W3.0-H1.1-LS4.9-P0.65.step
3.00 x 4.90 x 1.28 mm
