ruben-iteng/ato-library/packages/nxp_semiconductors-pca95xx/parts/NXP_Semicon_PCA9536TK_118/HVSON-8_L3.0-W3.0-P0.50-BL-EP.step

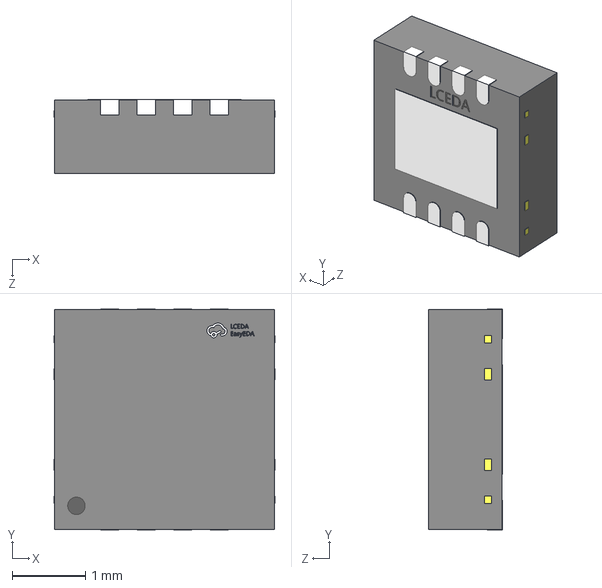
[picture p83: CAD file, 2025-06-28]
packages/nxp_semiconductors-pca95xx/parts/NXP_Semicon_PCA9536TK_118/HVSON-8_L3.0-W3.0-P0.50-BL-EP.step
3.02 x 3.02 x 1.01 mm
