ruben-iteng/ato-library/packages/nxp_semiconductors-pca95xx/parts/NXP_Semicon_PCA9554ABS_118/HVQFN-16_L4.0-W4.0-P0.65-TL-EP2.2.step

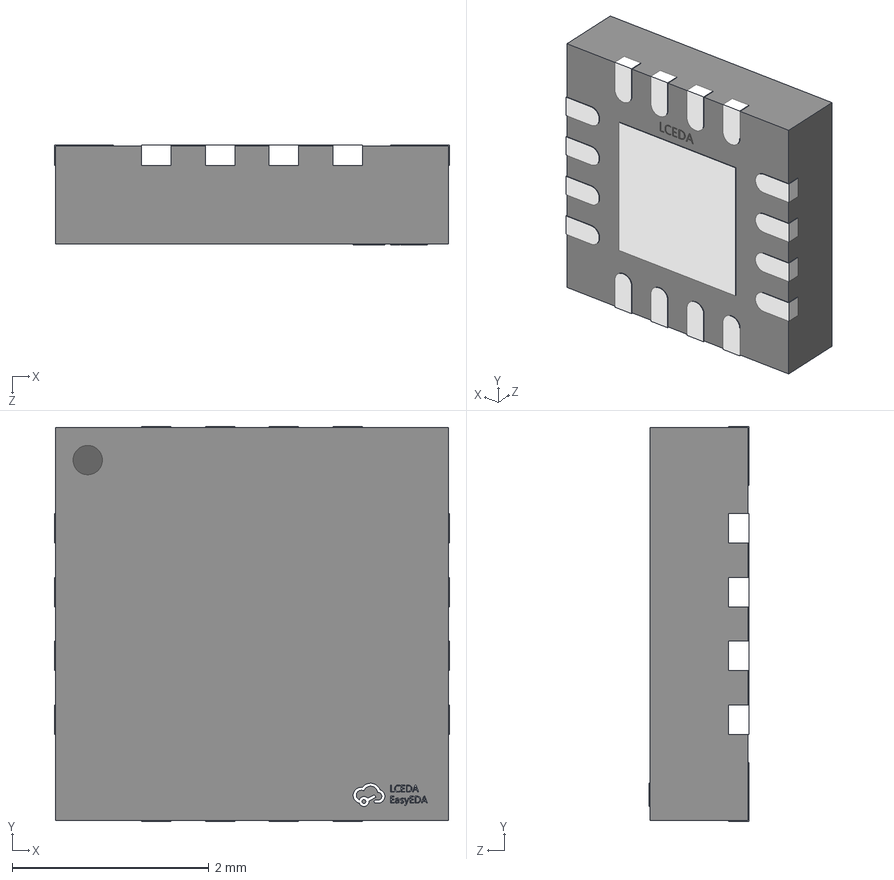
[picture p84: CAD file, 2025-06-28]
packages/nxp_semiconductors-pca95xx/parts/NXP_Semicon_PCA9554ABS_118/HVQFN-16_L4.0-W4.0-P0.65-TL-EP2.2.step
4.02 x 4.02 x 1.02 mm
