ruben-iteng/ato-library/packages/relays/parts/Cixi_Kefa_Elec_KF250T_5_0_2_3P/CONN-TH_KF250T-5.0-2X3P.step

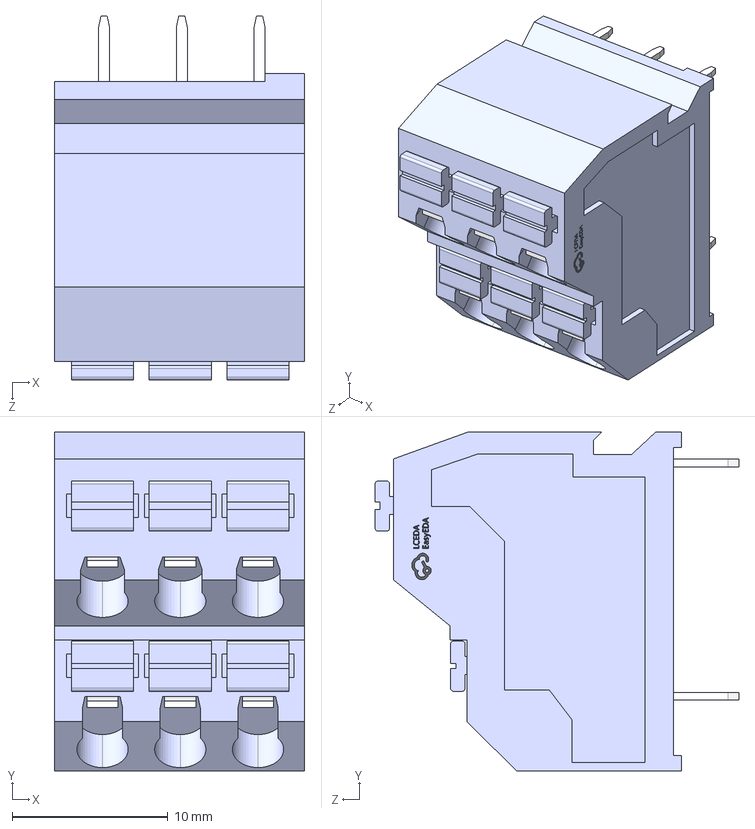
[picture p85: CAD file, 2025-06-28]
packages/relays/parts/Cixi_Kefa_Elec_KF250T_5_0_2_3P/CONN-TH_KF250T-5.0-2X3P.step
16.1 x 21.8 x 23.4 mm
