ruben-iteng/ato-library/packages/relays/parts/Hubei_KENTO_Elec_KT_0603G/LED0603-RD-YELLOW.STEP

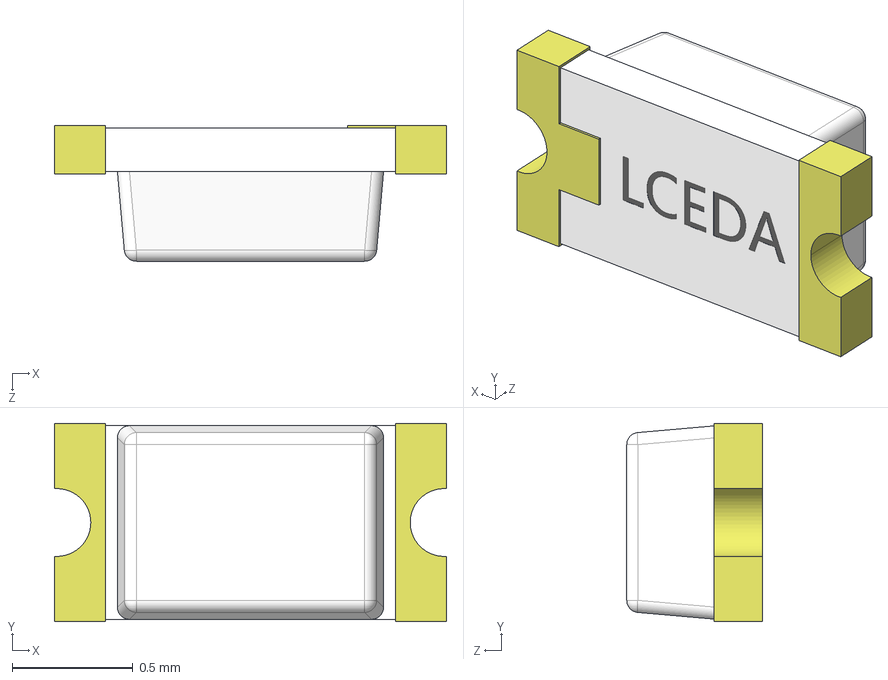
[picture p86: CAD file, 2025-06-28]
packages/relays/parts/Hubei_KENTO_Elec_KT_0603G/LED0603-RD-YELLOW.STEP
1.62 x 0.82 x 0.56 mm
