ruben-iteng/ato-library/packages/relays/parts/Omron_Electronics_G6KU_2F_Y_TR_DC5/RELAY-SMD_G6KU-2F-Y.STEP

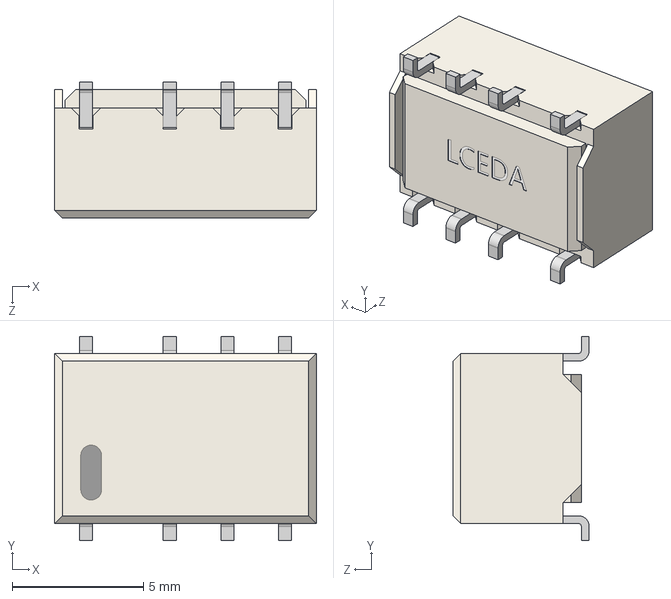
[picture p87: CAD file, 2025-06-28]
packages/relays/parts/Omron_Electronics_G6KU_2F_Y_TR_DC5/RELAY-SMD_G6KU-2F-Y.STEP
10.0 x 7.80 x 5.20 mm
