ruben-iteng/ato-library/packages/relays/parts/Shenzhen_Fuman_Elec_TC118S/SOP-8_L4.9-W3.9-P1.27-LS6.0-BL-1.STEP

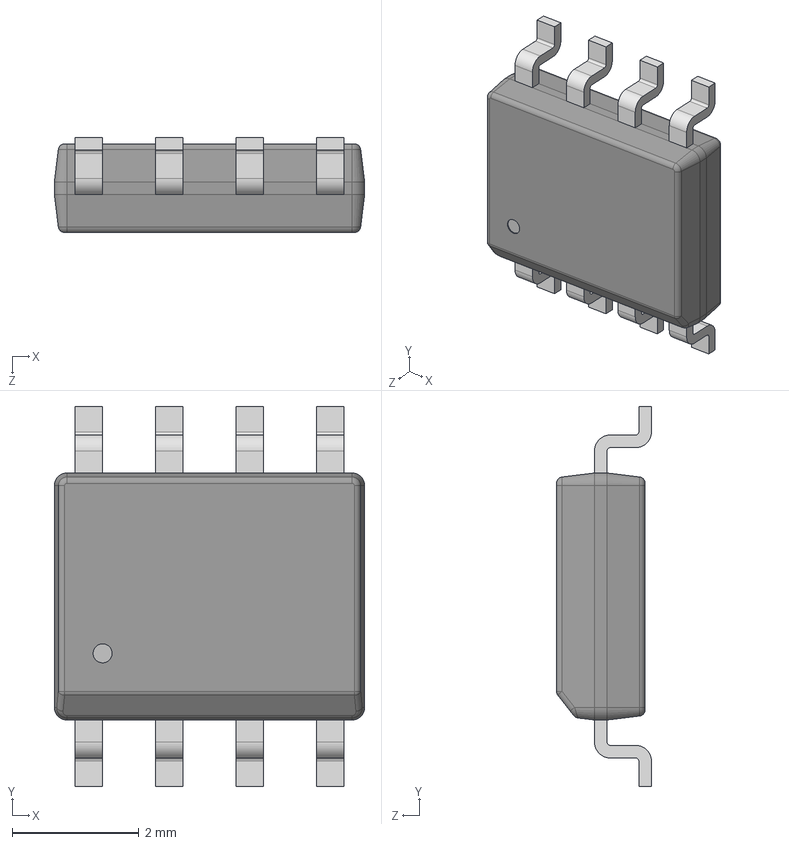
[picture p88: CAD file, 2025-06-28]
packages/relays/parts/Shenzhen_Fuman_Elec_TC118S/SOP-8_L4.9-W3.9-P1.27-LS6.0-BL-1.STEP
4.90 x 6.00 x 1.50 mm
