ruben-iteng/ato-library/packages/rohm_semiconductor_bh1750fvi/parts/ROHM_Semicon_BH1750FVI_TR/WSOF-6_L1.6-W2.6-H0.8-P0.50.step

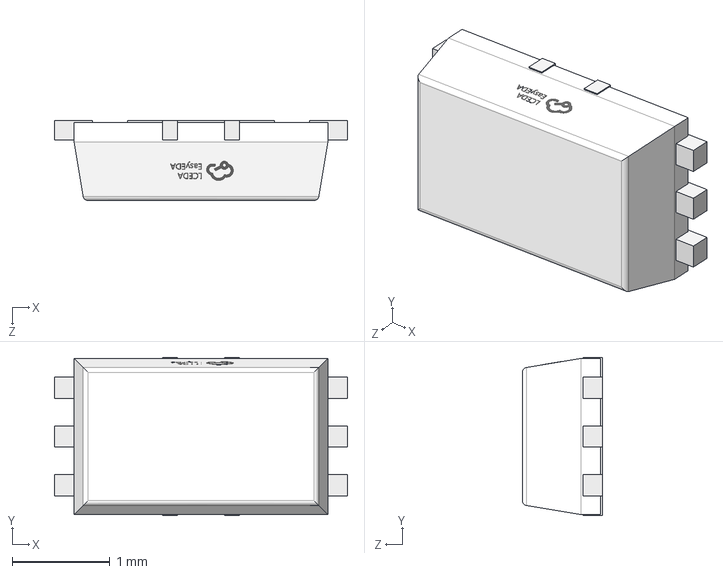
[picture p89: CAD file, 2025-06-28]
packages/rohm_semiconductor_bh1750fvi/parts/ROHM_Semicon_BH1750FVI_TR/WSOF-6_L1.6-W2.6-H0.8-P0.50.step
3.00 x 1.62 x 0.82 mm
