ruben-iteng/ato-library/packages/rs485/parts/Brightking_Elec_3RL090M_5_S/DIO-DT-SMD_L7.2-W5.0.step

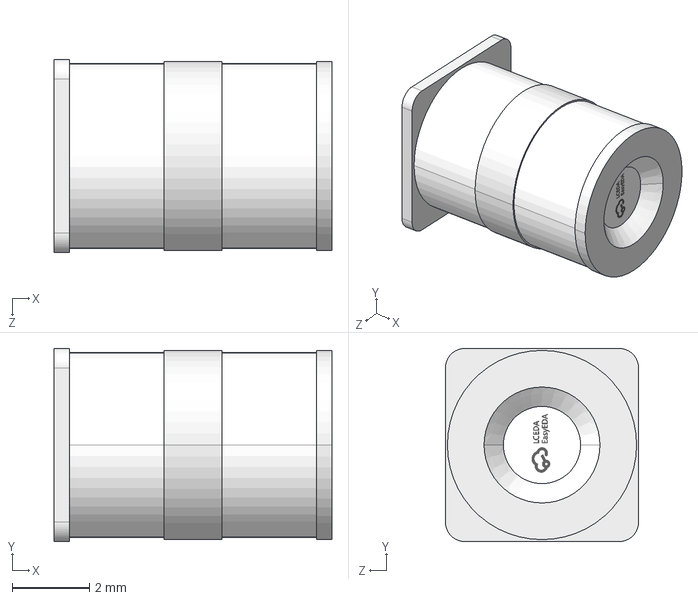
[picture p90: CAD file, 2025-06-28]
packages/rs485/parts/Brightking_Elec_3RL090M_5_S/DIO-DT-SMD_L7.2-W5.0.step
7.20 x 5.00 x 5.00 mm
