ruben-iteng/ato-library/packages/rs485/parts/Chipanalog_CA_IS2092A/LGA-16_L5.2-W4.7-P0.65-TL_CA-IS2062A-FRANK2.STEP

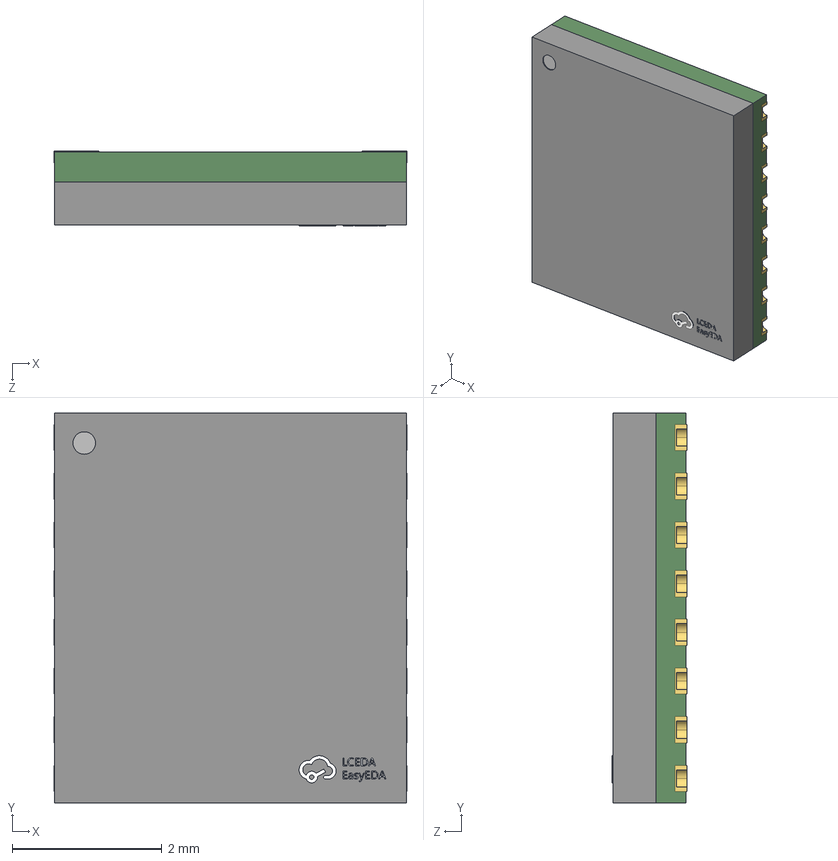
[picture p91: CAD file, 2025-06-28]
packages/rs485/parts/Chipanalog_CA_IS2092A/LGA-16_L5.2-W4.7-P0.65-TL_CA-IS2062A-FRANK2.STEP
4.70 x 5.20 x 1.00 mm
