ruben-iteng/ato-library/packages/rs485/parts/IHHEC_C1808X102K202T/C1808_L4.5-W2.0-H2.0.step

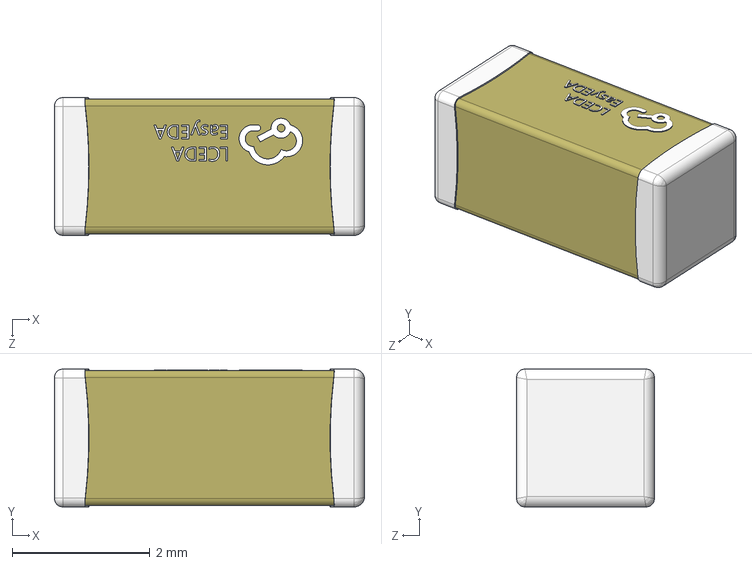
[picture p92: CAD file, 2025-06-28]
packages/rs485/parts/IHHEC_C1808X102K202T/C1808_L4.5-W2.0-H2.0.step
4.50 x 2.00 x 2.00 mm
