ruben-iteng/ato-library/packages/rs485/parts/UNI_ROYAL_0603WAF1200T5E/R0603.STEP

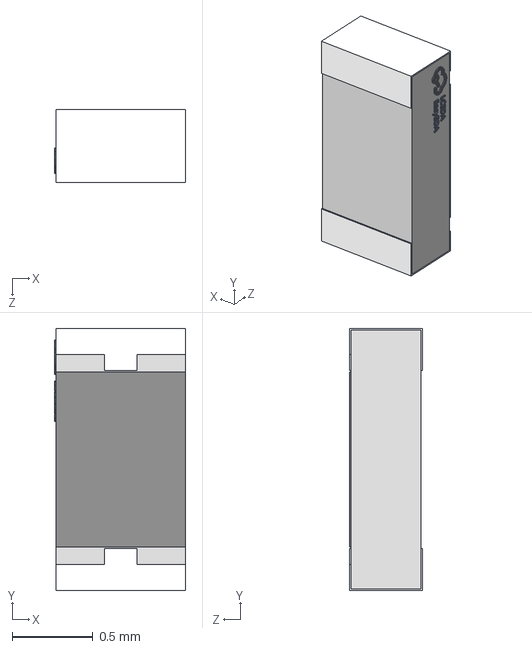
[picture p93: CAD file, 2025-06-28]
packages/rs485/parts/UNI_ROYAL_0603WAF1200T5E/R0603.STEP
0.81 x 1.62 x 0.45 mm
