ruben-iteng/ato-library/packages/rs485/parts/Vishay_Intertech_RCV20101M00FKEFAT/R2010_L5.0-W2.5-H0.6.step

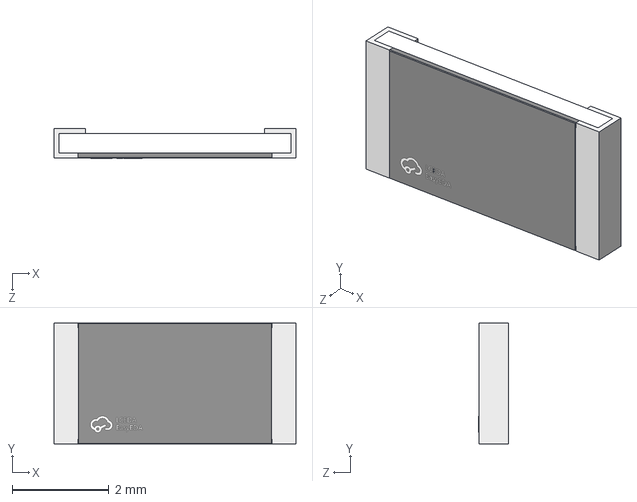
[picture p94: CAD file, 2025-06-28]
packages/rs485/parts/Vishay_Intertech_RCV20101M00FKEFAT/R2010_L5.0-W2.5-H0.6.step
5.00 x 2.50 x 0.611 mm
