ruben-iteng/ato-library/packages/texas_instruments_lm66200/parts/Texas_Instruments_LM66200DRLR/SOT-583-8_L2.1-W1.2-P0.50-LS1.6-BL.STEP

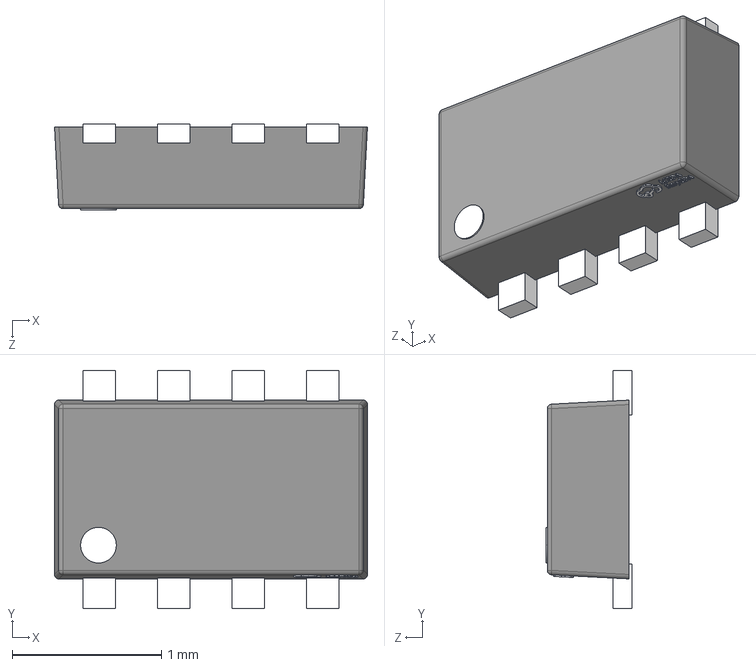
[picture p95: CAD file, 2025-06-28]
packages/texas_instruments_lm66200/parts/Texas_Instruments_LM66200DRLR/SOT-583-8_L2.1-W1.2-P0.50-LS1.6-BL.STEP
2.10 x 1.60 x 0.58 mm
