ruben-iteng/ato-library/packages/usb/parts/BHFUSE_BSMD0805_050_15V/F0805_L2.1-W1.4-H0.8.step

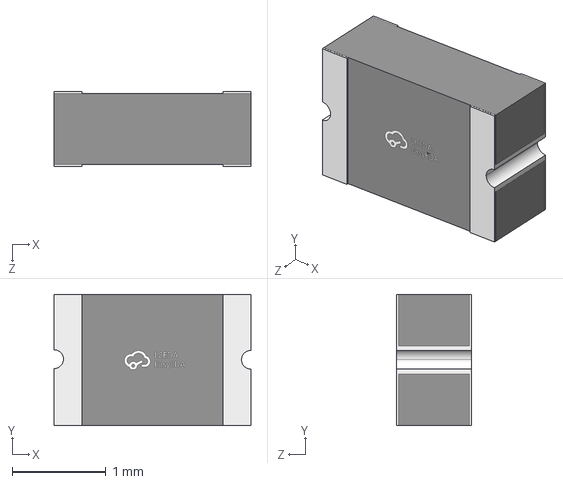
[picture p96: CAD file, 2025-06-28]
packages/usb/parts/BHFUSE_BSMD0805_050_15V/F0805_L2.1-W1.4-H0.8.step
2.10 x 1.40 x 0.8 mm
