ruben-iteng/ato-library/packages/usb/parts/Jing_Extension_of_the_Electronic_Co_918_418K2022Y40000/TYPE-C-TH_L8.9-W3.1-H10.0.step

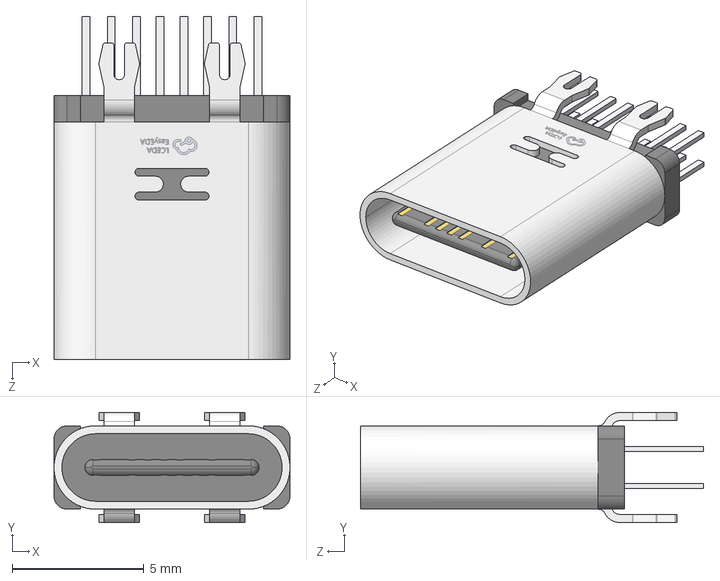
[picture p97: CAD file, 2025-06-28]
packages/usb/parts/Jing_Extension_of_the_Electronic_Co_918_418K2022Y40000/TYPE-C-TH_L8.9-W3.1-H10.0.step
8.94 x 4.17 x 13.0 mm
