ruben-iteng/ato-library/packages/usb/parts/SHOU_HAN_TYPE_C_16PIN_2MD_073/USB-C-SMD_TYPE-C-6PIN-2MD-073.STEP

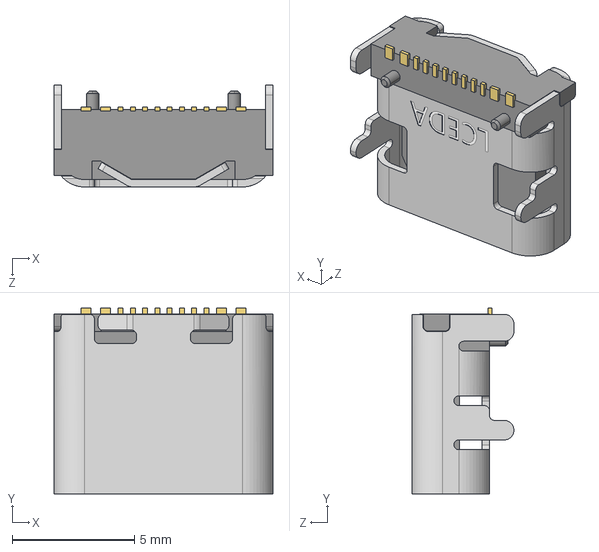
[picture p98: CAD file, 2025-06-28]
packages/usb/parts/SHOU_HAN_TYPE_C_16PIN_2MD_073/USB-C-SMD_TYPE-C-6PIN-2MD-073.STEP
8.94 x 7.58 x 4.16 mm
