ruben-iteng/ato-library/(list of files, cad)

Other CAD files:
packages/connectors/parts/Changzhou_Amass_Elec_24_245_2/ANT-TH_L33.0-W12.0_BLACK.step
packages/logic/parts/Samsung_Electro_Mechanics_CL05B104KO5NNNC/C0402_L1.0-W0.5-H0.5.step
packages/relays/parts/Hubei_KENTO_Elec_KT_0603R/LED0603-RD-YELLOW.STEP
