ruben-iteng/ato-library/packages/esp32c3/layouts/esp32_c3_mini_ufl_driver/esp32_c3_mini_ufl_driver.kicad_pcb

## KiCad design packages/esp32c3/layouts/esp32_c3_mini_ufl_driver/esp32_c3_mini_ufl_driver.kicad_pcb (2025-06-28)

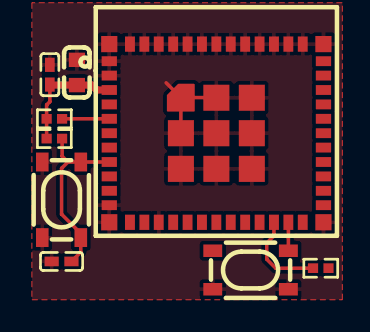
[picture p100: board esp32_c3_mini_ufl_driver.kicad_pcb from above]

Board: 2 copper layers, 9 parts (0 on the bottom side), 6 nets.

Parts:
C1: 22µF ±20% 6.3V X5R; C0603
C2: 100nF ±10% 16V X7R; C0402
C3: 1µF ±10% 25V X5R; C0402
R1, R2, R3: 10kΩ ±1% 62.5mW; R0402
U1, U3: KEY-SMD_4P-L4.2-W3.2-P2.20-LS4.6
U2: WIFIM-SMD_ESP32-C3-MINI-MINI-1U

Connections:
EN: C3.1, R3.2, U2.8, U3.1, U3.2
IO2: R1.1, U2.5
IO9: U1.1, U1.2, U2.23
gnd: C1.2, C2.2, C3.2, U1.3, U1.4, U2.1, U2.2, U2.11, U2.14, U2.36, U2.37, U2.38, U2.39, U2.40, U2.41, U2.42, U2.43, U2.44, U2.45, U2.46, U2.47, U2.48, U2.49, U2.50, U2.51, U2.52, U2.53, U3.3, U3.4
hv: C1.1, C2.1, R1.2, R2.2, R3.1, U2.3
line: R2.1, U2.22
