ruben-iteng/ato-library/packages/rs485/layouts/maxlinear_sp3485en_driver/maxlinear_sp3485en_driver.kicad_pcb

## KiCad design packages/rs485/layouts/maxlinear_sp3485en_driver/maxlinear_sp3485en_driver.kicad_pcb (2025-06-28)

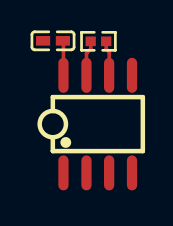
[picture p101: board maxlinear_sp3485en_driver.kicad_pcb from above]

Board: 2 copper layers, 3 parts (0 on the bottom side), 4 nets.

Parts:
C1: 100nF ±10% 16V X7R; C0402
R1: 120Ω ±1% 62.5mW; R0402
U1: SOIC-8_L5.0-W4.0-P1.27-LS6.0-BL

Connections:
A: R1.1, U1.6
B: R1.2, U1.7
VCC: C1.1, U1.8
gnd: C1.2, U1.5
