ruben-iteng/ato-library/packages/relays/layouts/driven_dpdt_bistable_relay/driven_dpdt_bistable_relay.kicad_pcb

## KiCad design packages/relays/layouts/driven_dpdt_bistable_relay/driven_dpdt_bistable_relay.kicad_pcb (2025-06-28)

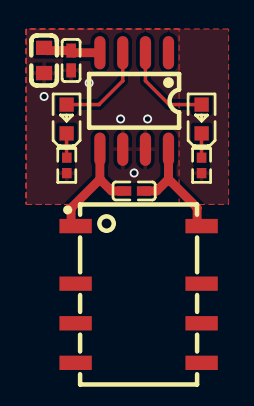
[picture p102: board driven_dpdt_bistable_relay.kicad_pcb from above]

Board: 2 copper layers, 9 parts (0 on the bottom side), 8 nets.

Parts:
C1: 100nF ±10% 16V X7R; C0402
C2: 4.7µF ±10% 16V X5R; C0603
C3: 100pF ±5% 50V C0G; C0402
LED1, LED2: LED0603-RD
R1, R2: 10kΩ ±1% 62.5mW; R0402
U1: SOP-8_L4.9-W3.9-P1.27-LS6.0-BL
U2: RELAY-SMD_G6KU-2F-Y

Connections:
OUTA: C3.1, U1.8, U2.8
anode: LED2.2, U1.3
anode-1: LED1.2, U1.2
cathode: LED2.1, R2.1
cathode-1: LED1.1, R1.1
gnd: C1.2, C2.2, R1.2, R2.2, U1.6, U1.7
gnd-1: C3.2, U1.5, U2.1
hv: C1.1, C2.1, U1.4
