ruben-iteng/ato-library/packages/rohm_semiconductor_bh1750fvi/layouts/bh1750_driver/bh1750_driver.kicad_pcb

## KiCad design packages/rohm_semiconductor_bh1750fvi/layouts/bh1750_driver/bh1750_driver.kicad_pcb (2025-06-28)

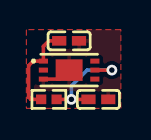
[picture p103: board bh1750_driver.kicad_pcb from above]

Board: 2 copper layers, 4 parts (0 on the bottom side), 3 nets.

Parts:
C1, C2: 100nF ±10% 16V X7R; C0402
R1: 1kΩ ±1% 62.5mW; R0402
U1: WSOF-6_L2.6-W1.6-P0.50-TL-EP

Connections:
DVI: C2.1, R1.2, U1.5
VCC: C1.1, R1.1, U1.1
gnd: C1.2, C2.2, U1.3, U1.7
