ruben-iteng/ato-library/packages/microchip-emc2101/layouts/microchip_emc2101_driver/microchip_emc2101_driver.kicad_pcb

## KiCad design packages/microchip-emc2101/layouts/microchip_emc2101_driver/microchip_emc2101_driver.kicad_pcb (2025-06-28)

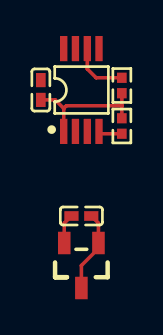
[picture p104: board microchip_emc2101_driver.kicad_pcb from above]

Board: 2 copper layers, 6 parts (0 on the bottom side), 6 nets.

Parts:
C1: 100nF ±10% 16V X7R; C0402
C2: 2.2nF ±10% 50V X7R; C0402
Q1: SOT-23-3_L2.9-W1.3-P1.90-LS2.4-TR
R1, R2: 10kΩ ±1% 62.5mW; R0402
U1: MSOP-8_L3.0-W3.0-P0.65-LS4.9-BL

Connections:
DN: C2.1, Q1.2, Q1.3, U1.3
DP: C2.2, Q1.1, U1.2
FAN: R1.1, U1.4
VDD: C1.1, R1.2, R2.2, U1.1
gnd: C1.2, U1.5
nALERT_TACH: R2.1, U1.6
