ruben-iteng/ato-library/packages/rs485/layouts/bus_protection/bus_protection.kicad_pcb

## KiCad design packages/rs485/layouts/bus_protection/bus_protection.kicad_pcb (2025-06-28)

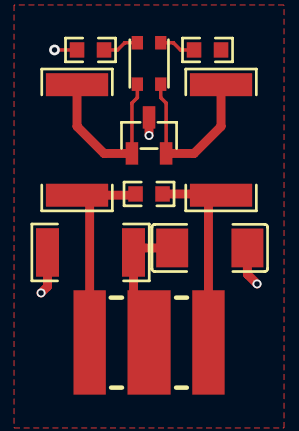
[picture p105: board bus_protection.kicad_pcb from above]

Board: 2 copper layers, 10 parts (0 on the bottom side), 8 nets.

Parts:
C1: 1nF ±10% 2kV X7R; C1808
FL1: FILTER-SMD_4P-L2.5-W2.0-BL
GDT1: DIO-DT-SMD_L7.2-W5.0
R1, R2: 2.7Ω ±5% 1W; R2512
R3: 1MΩ ±1% 750mW; R2010
R4, R5: 390Ω ±1% 100mW; R0603
R6: 120Ω ±1% 100mW; R0603
U1: SOT-23-3_L2.9-W1.3-P1.90-LS2.4-BR

Connections:
earth: C1.2, GDT1.2, R3.2
gnd: C1.1, R3.1, R5.2, U1.3
line: FL1.4, R5.1
line-1: FL1.2, R1.1, U1.2
line-2: FL1.3, R4.1
line-3: FL1.1, R2.1, U1.1
tube_1: GDT1.1, R2.2, R6.1
tube_2: GDT1.3, R1.2, R6.2
