ruben-iteng/ato-library/packages/usb/layouts/usb_pd_power_sink_horizontal_connector/usb_pd_power_sink_horizontal_connector.kicad_pcb

## KiCad design packages/usb/layouts/usb_pd_power_sink_horizontal_connector/usb_pd_power_sink_horizontal_connector.kicad_pcb (2025-06-28)

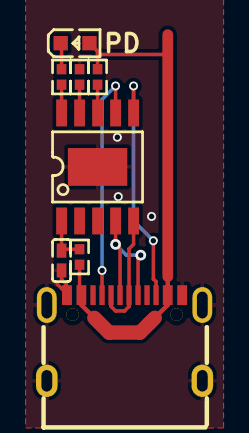
[picture p106: board usb_pd_power_sink_horizontal_connector.kicad_pcb from above]

Board: 2 copper layers, 8 parts (0 on the bottom side), 11 nets.

Parts:
C1: 1µF ±10% 25V X5R; C0402
LED1: LED0603-RD
R1, R2, R4: 10kΩ ±1% 62.5mW; R0402
R3: 1kΩ ±1% 62.5mW; R0402
U1: ESSOP-10_L4.9-W3.9-P1.0-LS6.0-TL-EP
X1: USB-C-SMD_TYPE-C-6PIN-2MD-073

Connections:
anode: LED1.2, R2.1, R3.1, X1.2, X1.11
cathode: LED1.1, R1.1
gnd: C1.2, R4.2, U1.11, X1.1, X1.12, X1.13, X1.14
hv: C1.1, R3.2, U1.1
line: U1.7, X1.4
line-1: U1.6, X1.10
line-4: U1.5, X1.5, X1.7
line-5: U1.4, X1.6, X1.8
pd_trigger-gnd: R1.2, U1.10
pd_trigger-line: R4.1, U1.9
pd_trigger-line-1: R2.2, U1.8
