ruben-iteng/ato-library/packages/ina228/layouts/ina228/ina228.kicad_pcb

## KiCad design packages/ina228/layouts/ina228/ina228.kicad_pcb (2025-06-28)

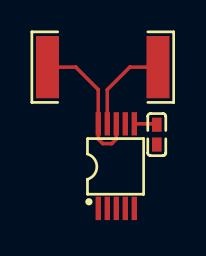
[picture p107: board ina228.kicad_pcb from above]

Board: 2 copper layers, 3 parts (0 on the bottom side), 4 nets.

Parts:
C1: 100nF ±10% 16V X7R; C0402
R1: 15mΩ ±1% 3W; R2512
U1: VSSOP-10_L3.0-W3.0-P0.50-LS4.9-BL

Connections:
INneg: R1.2, U1.9
INpos: R1.1, U1.8, U1.10
VS: C1.1, U1.6
gnd: C1.2, U1.7
