ruben-iteng/ato-library/packages/switches/layouts/test/test.kicad_pcb

## KiCad design packages/switches/layouts/test/test.kicad_pcb (2025-06-28)

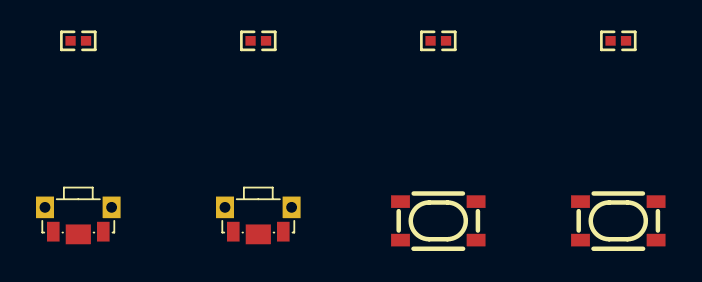
[picture p108: board test.kicad_pcb from above]

Board: 2 copper layers, 8 parts (0 on the bottom side), 6 nets, no tracks yet.

Parts:
R1, R2, R3, R4: 10kΩ ±1% 62.5mW; R0402
U1, U3: KEY-SMD_SKTDLDE010
U2, U4: KEY-SMD_4P-L4.2-W3.2-P2.20-LS4.6

Connections:
gnd: U4.3, U4.4
hv: U2.3, U2.4
line: R4.1, U4.1, U4.2
line-1: R3.1, U3.1
line-2: R2.1, U2.1, U2.2
line-3: R1.1, U1.1
