ruben-iteng/ato-library/packages/rs485/layouts/chipanalog_is2092a_driver/chipanalog_is2092a_driver.kicad_pcb

## KiCad design packages/rs485/layouts/chipanalog_is2092a_driver/chipanalog_is2092a_driver.kicad_pcb (2025-06-28)

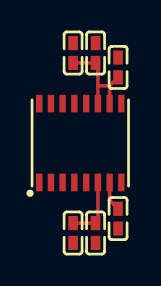
[picture p109: board chipanalog_is2092a_driver.kicad_pcb from above]

Board: 2 copper layers, 7 parts (0 on the bottom side), 5 nets.

Parts:
C1, C2: 1µF ±10% 25V X5R; C0402
C3, C4: 10µF ±20% 6.3V X5R; C0402
C5, C6: 100nF ±10% 16V X7R; C0402
U1: LGA-16_L5.2-W4.7-P0.65-TL_CA-IS2062A-FRANK2

Connections:
VDDL: C1.1, U1.7
VDDP: C3.1, C5.1, U1.6
gnd: C1.2, C3.2, C5.2, U1.5, U1.8
gnd-1: C2.2, C4.2, C6.2, U1.9, U1.12
hv: C2.1, C4.1, C6.1, U1.10, U1.11
