ruben-iteng/ato-library/packages/analog-devices-max14778/layouts/analog_devices_max14778_driver/analog_devices_max14778_driver.kicad_pcb

## KiCad design packages/analog-devices-max14778/layouts/analog_devices_max14778_driver/analog_devices_max14778_driver.kicad_pcb (2025-06-28)

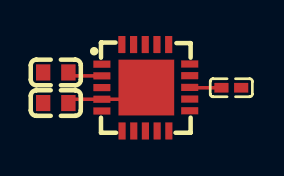
[picture p110: board analog_devices_max14778_driver.kicad_pcb from above]

Board: 2 copper layers, 4 parts (0 on the bottom side), 4 nets.

Parts:
C1: 100nF ±10% 16V X7R; C0402
C2, C3: 100nF ±10% 100V X7R; C0603
U1: TQFN-20_L5.0-W5.0-P0.65-TL-EP3.1

Connections:
EP: C2.1, U1.4, U1.21
VP: C3.1, U1.2
gnd: C1.2, C2.2, C3.2, U1.3
hv: C1.1, U1.13
