ruben-iteng/ato-library/packages/texas_instruments_lm66200/layouts/lm66200/lm66200.kicad_pcb

## KiCad design packages/texas_instruments_lm66200/layouts/lm66200/lm66200.kicad_pcb (2025-06-28)

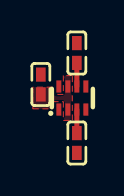
[picture p111: board lm66200.kicad_pcb from above]

Board: 2 copper layers, 4 parts (0 on the bottom side), 4 nets.

Parts:
C1, C2, C3: 100nF ±10% 16V X7R; C0402
U1: SOT-583-8_L2.1-W1.2-P0.50-LS1.6-BL

Connections:
VOUT: C3.1, U1.2, U1.7
gnd: C1.2, C2.2, C3.2, U1.1, U1.5
hv: C1.1, U1.3
hv-1: C2.1, U1.6
