ruben-iteng/ato-library/packages/logic/layouts/aip74lvc1t45_driver/aip74lvc1t45_driver.kicad_pcb

## KiCad design packages/logic/layouts/aip74lvc1t45_driver/aip74lvc1t45_driver.kicad_pcb (2025-06-28)

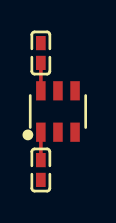
[picture p112: board aip74lvc1t45_driver.kicad_pcb from above]

Board: 2 copper layers, 3 parts (0 on the bottom side), 3 nets.

Parts:
C1, C2: 100nF ±10% 16V X7R; C0402
U1: SOT-23-6_L2.9-W1.6-P0.95-LS2.8-BL

Connections:
gnd: C1.2, C2.2, U1.2
hv: C1.1, U1.1
hv-1: C2.1, U1.6
