ruben-iteng/ato-library/packages/dcdc-converters/layouts/b0505s1wr3/b0505s1wr3.kicad_pcb

## KiCad design packages/dcdc-converters/layouts/b0505s1wr3/b0505s1wr3.kicad_pcb (2025-06-28)

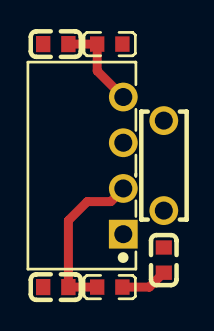
[picture p113: board b0505s1wr3.kicad_pcb from above]

Board: 2 copper layers, 7 parts (0 on the bottom side), 5 nets.

Parts:
C1: 270pF ±10% 2kV; CAP-TH_L6.0-W2.5-P5.00-D1.0
C2, C3: 4.7nF ±10% 50V X7R; C0603
C4: 10µF ±10% 10V X5R; C0603
L1, L2: L0603
U1: PWRM-TH_B0505S-1WR3

Connections:
Vinpos: C2.1, L1.1, U1.2
Voutpos: C4.1, L2.1, U1.4
gnd: C1.1, C2.2, C3.2, U1.1
gnd-1: C1.2, C4.2, U1.3
hv: C3.1, L1.2
