ruben-iteng/ato-library/packages/switches/layouts/rotary_encoder_advanced/rotary_encoder_advanced.kicad_pcb

## KiCad design packages/switches/layouts/rotary_encoder_advanced/rotary_encoder_advanced.kicad_pcb (2025-06-28)

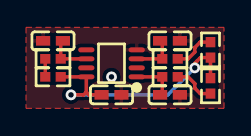
[picture p114: board rotary_encoder_advanced.kicad_pcb from above]

Board: 2 copper layers, 11 parts (0 on the bottom side), 8 nets.

Parts:
C1, C2, C3, C4: 100nF ±10% 16V X7R; C0402
R1, R2, R3, R4, R5, R6: 10kΩ ±1% 62.5mW; R0402
U1: VSSOP-8_L2.3-W2.0-P0.50-LS3.1-BR

Connections:
a: R1.1, R4.1
b: R2.1, R5.1
gnd: C1.2, C2.2, C3.2, C4.2, U1.4
hv: C1.1, R1.2, R2.2, R3.2, U1.8
line-2: C2.1, R4.2, U1.1
line-3: C3.1, R5.2, U1.3
line-4: C4.1, R6.2, U1.6
switch: R3.1, R6.1
