ruben-iteng/ato-library/packages/relays/layouts/dc_motor_driver/dc_motor_driver.kicad_pcb

## KiCad design packages/relays/layouts/dc_motor_driver/dc_motor_driver.kicad_pcb (2025-06-28)

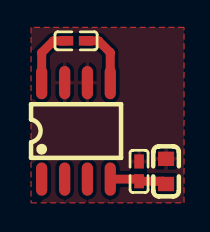
[picture p115: board dc_motor_driver.kicad_pcb from above]

Board: 2 copper layers, 4 parts (0 on the bottom side), 4 nets.

Parts:
C1: 100nF ±10% 16V X7R; C0402
C2: 4.7µF ±10% 16V X5R; C0603
C3: 100pF ±5% 50V C0G; C0402
U1: SOP-8_L4.9-W3.9-P1.27-LS6.0-BL

Connections:
OUTA: C3.1, U1.8
VDD: C1.1, C2.1, U1.4
gnd: C1.2, C2.2, U1.6, U1.7
gnd-1: C3.2, U1.5
