ruben-iteng/ato-library/packages/rs485/layouts/analog_devices_adm2587ebrwz_driver/analog_devices_adm2587ebrwz_driver.kicad_pcb

## KiCad design packages/rs485/layouts/analog_devices_adm2587ebrwz_driver/analog_devices_adm2587ebrwz_driver.kicad_pcb (2025-06-28)

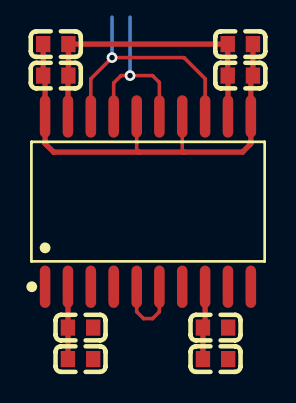
[picture p116: board analog_devices_adm2587ebrwz_driver.kicad_pcb from above]

Board: 2 copper layers, 9 parts (0 on the bottom side), 7 nets.

Parts:
C1, C3, C5, C7: 100nF ±5% 50V X7R; C0603
C2, C4, C6, C8: 10nF ±5% 50V X7R; C0603
U1: SOIC-20_L13.0-W7.6-P1.27-LS10.3-BL

Connections:
gnd: C1.2, C2.2, C3.2, C4.2, U1.11, U1.14, U1.16, U1.20
gnd-1: C5.2, C6.2, C7.2, C8.2, U1.1, U1.3, U1.9, U1.10
hv: C1.1, C2.1, C3.1, C4.1, U1.12, U1.19
hv-1: C5.1, C6.1, C7.1, C8.1, U1.2, U1.8
line: U1.5, U1.6
line-1: U1.15, U1.17
line-2: U1.13, U1.18
