ruben-iteng/ato-library/packages/esp32s3/layouts/esp32_s3_wroom_driver/esp32_s3_wroom_driver.kicad_pcb

## KiCad design packages/esp32s3/layouts/esp32_s3_wroom_driver/esp32_s3_wroom_driver.kicad_pcb (2025-06-28)

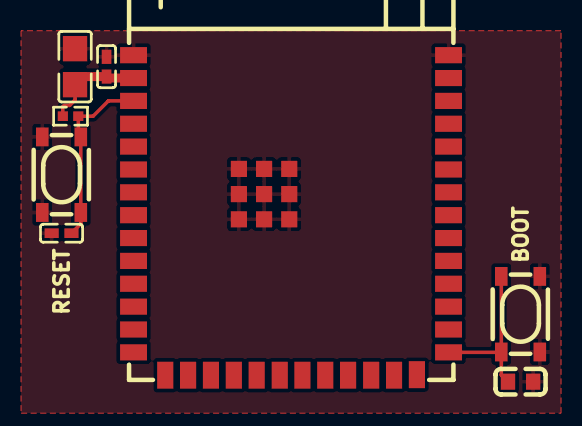
[picture p117: board esp32_s3_wroom_driver.kicad_pcb from above]

Board: 2 copper layers, 8 parts (0 on the bottom side), 4 nets.

Parts:
C1: 100nF ±10% 50V X7R; C0805
C2, C3: 100nF ±10% 16V X7R; C0402
C4: 100nF ±10% 50V X7R; C0603
R1: 10kΩ ±1% 62.5mW; R0402
U1, U3: KEY-SMD_4P-L4.2-W3.2-P2.20-LS4.6
U2: WIRELM-SMD_ESP32-S3-WROOM-1

Connections:
gnd: C1.2, C2.2, C3.2, C4.2, U1.1, U1.2, U2.1, U2.40, U2.41, U3.3, U3.4
hv: C1.1, C2.1, R1.2, U2.2
line: C3.1, R1.1, U2.3, U3.1, U3.2
line-1: C4.1, U1.3, U1.4, U2.27
