ruben-iteng/ato-library/packages/ldos/layouts/5v_to_3v3/5v_to_3v3.kicad_pcb

## KiCad design packages/ldos/layouts/5v_to_3v3/5v_to_3v3.kicad_pcb (2025-06-28)

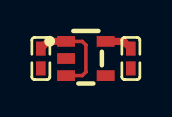
[picture p118: board 5v_to_3v3.kicad_pcb from above]

Board: 2 copper layers, 3 parts (0 on the bottom side), 3 nets.

Parts:
C1, C2: 100nF ±10% 16V X7R; C0402
U1: SOT-23-5_L2.9-W1.6-P0.95-LS2.8-BR

Connections:
VOUT: C2.1, U1.5
gnd: C1.2, C2.2, U1.2
hv: C1.1, U1.1, U1.3
