ruben-iteng/ato-library/packages/usb/layouts/usb_2_0_type_c_data_power_horizontal_connector/usb_2_0_type_c_data_power_horizontal_connector.kicad_pcb

## KiCad design packages/usb/layouts/usb_2_0_type_c_data_power_horizontal_connector/usb_2_0_type_c_data_power_horizontal_connector.kicad_pcb (2025-06-28)

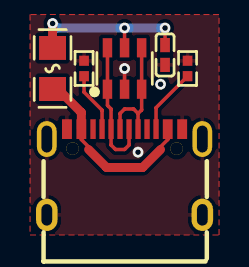
[picture p119: board usb_2_0_type_c_data_power_horizontal_connector.kicad_pcb from above]

Board: 2 copper layers, 6 parts (0 on the bottom side), 7 nets.

Parts:
C1: 100nF ±10% 16V X7R; C0402
F1: F0805
R1, R2: 5.1kΩ ±1% 62.5mW; R0402
U1: SOT-23-6_L2.9-W1.6-P0.95-LS2.8-BL
X1: USB-C-SMD_TYPE-C-6PIN-2MD-073

Connections:
gnd: C1.2, R1.2, R2.2, U1.2, X1.1, X1.12, X1.13, X1.14
hv: F1.1, X1.2, X1.11
hv-1: C1.1, F1.2, U1.5
line: R1.1, X1.4
line-1: R2.1, X1.10
line-4: U1.1, U1.6, X1.5, X1.7
line-5: U1.3, U1.4, X1.6, X1.8
