ruben-iteng/ato-library/(commit log)

2025-04-13 Add relays package
    [driven_dpdt_bistable_relay.kicad_pcb]
2025-04-13 Add debug connectors package
    [arm_cortex_m_debug_header.kicad_pcb, swd_tc2030_idc_fp.kicad_pcb, swd_tc2030_idc_nl.kicad_pcb]
2025-04-18 Add new packages
    - debug interfaces
    - connectors
    - ina228
    - rs485
    - relays
    [addressable_led_connector.kicad_pcb, arm_cortex_m_debug_header.kicad_pcb, bus_protection.kicad_pcb, isolated_ina228.kicad_pcb, isolated_transceiver.kicad_pcb, screw_terminal_3_81mm_2p.kicad_pcb, screw_terminal_3_81mm_3p.kicad_pcb, screw_terminal_3_81mm_4p.kicad_pcb]
2025-04-22 Fix pulldown on RE pins
    [isolated_transceiver.kicad_pcb, transceiver.kicad_pcb]
2025-04-22 Add logo package
    [faebryk.kicad_pcb]
2025-04-22 Add LDOs package
    [5v_to_3v3.kicad_pcb]
2025-04-22 Add USB2.0 Type-C interface to connector package
    [usb_2_0_type_c.kicad_pcb]
2025-04-22 Update build script and regenerate outputs
    [addressable_led_connector.kicad_pcb, arm_cortex_m_debug_header.kicad_pcb, bus_protection.kicad_pcb, driven_dpdt_bistable_relay.kicad_pcb, isolated_ina228.kicad_pcb, screw_terminal_3_81mm_2p.kicad_pcb, screw_terminal_3_81mm_3p.kicad_pcb, screw_terminal_3_81mm_4p.kicad_pcb]
2025-04-27 Add ESP32S3, BM9002, Logic; Various naming updates and splitting of packages
    [AiP74LVC1T45.kicad_pcb, cbm9002a_56ilg_reference_design.kicad_pcb, esp32_s3_wroom_reference_design.kicad_pcb, usb_2_0_type_c_data_power.kicad_pcb]
2025-04-27 Don't generate board renders with pre-commit hook.
    Then change every time they are generated
2025-04-29 Remove connectors and replace with leds package
    [addressable_led_connector.kicad_pcb, screw_terminal_3_81mm_2p.kicad_pcb, screw_terminal_3_81mm_3p.kicad_pcb, screw_terminal_3_81mm_4p.kicad_pcb]
2025-04-29 rename bm9002 package
    [cbm9002a_56ilg_reference_design.kicad_pcb]
2025-04-29 Build all packages without designators on silkscreen.
    Also disable fail_on_drc and enable keep_picked_parts for build
    [5v_to_3v3.kicad_pcb, AiP74LVC1T45.kicad_pcb, arm_cortex_m_debug_header.kicad_pcb, bus_protection.kicad_pcb, driven_dpdt_bistable_relay.kicad_pcb, esp32_s3_wroom_reference_design.kicad_pcb, faebryk.kicad_pcb, isolated_ina228.kicad_pcb]
2025-05-01 Fix publish on failed build & fix pull resistor that should not be there (#2)
    * Remove pull resistor (should not be part of the tranceiver)
    * Fix publish if build fails
    [isolated_transceiver.kicad_pcb, transceiver.kicad_pcb]
2025-05-02 [Publish] Rebuild modules (with no dep on upstream atopile pr) (#5)
    * Fixes image link on published packages
    [5v_to_3v3.kicad_pcb, addressable_led_connector.kicad_pcb, arm_cortex_m_debug_header.kicad_pcb, driven_dpdt_bistable_relay.kicad_pcb, esp32_s3_wroom_reference_design.kicad_pcb, swd_tc2030_idc_fp.kicad_pcb, swd_tc2030_idc_nl.kicad_pcb]
2025-05-06 [Publish] Driven DPDT bistable-relay with push in terminal (#6)
    [driven_dpdt_bistable_relay.kicad_pcb, driven_dpdt_bistable_relay_push_terminal.kicad_pcb]
2025-05-06 Add Rotaty encoder with signal cleaning, I2C isolator, and logic schmitt trigger (#8)
    [SN74LVC3G14DCUR.kicad_pcb, iso1540.kicad_pcb, rotary_encoder_advanced.kicad_pcb]
2025-05-09 Add USB PD trigger (#9)
    [usb_2_0_type_c_data_power.kicad_pcb, usb_pd_power_sink.kicad_pcb]
2025-05-09 Update with new ato 0.7.x features (#10)
    [esp32_s3_wroom_reference_design.kicad_pcb]
2025-05-09 Add various addressable LEDs (#11)
    [addressable_led.kicad_pcb, addressable_led_connector.kicad_pcb]
2025-05-09 Rebuild modules frozen (#12)
    * Rebuild logic package
    * Add updated docs for logic package
    * Rebuild relays package
    * Rebuild usb package
    * Rebuild switches package
    * Rebuild rs485 package
    * Add option to specify package to doc generator
    * Add updated docs for rs485 package
    * Update main README
    [SN74LVC3G14DCUR.kicad_pcb, aip74lvc1t45.kicad_pcb, bus_protection.kicad_pcb, driven_dpdt_bistable_relay.kicad_pcb, driven_dpdt_bistable_relay_push_terminal.kicad_pcb, iso1540.kicad_pcb, isolated_transceiver.kicad_pcb, rotary_encoder_advanced.kicad_pcb]
2025-05-12 Add various new packages (#14)
    Add:
    - DCDC converters
    - Connectors
    Update:
    - logic
    - add dual buffer
    - ldos
    - change to better default ldo
    - usb
    - add missing connection
    - switches
    - update rotary encoder advanced layout
    [5v_to_3v3.kicad_pcb, b0505s.kicad_pcb, bus_protection.kicad_pcb, dual_banana_connectors.kicad_pcb, dual_buffer.kicad_pcb, faebryk_8x9mm.kicad_pcb, qwiic_horizontal.kicad_pcb, qwiic_vertical.kicad_pcb]
2025-05-12 Fix missing connection between JTAG and reset (enable) (#15)
    [esp32_s3_wroom_reference_design.kicad_pcb]
2025-05-13 Add isolated and powered RS485 tranceiver (#16)
    [isolated_powered_transceiver.kicad_pcb]
2025-05-14 Add ESP32C3 package 📦 (#17)
    [esp32_c3_mini_reference_design.kicad_pcb, esp32_c3_mini_ufl_reference_design.kicad_pcb]
2025-05-16 Add SN74CB3Q3251PWR (de)muxer (#18)
    [sn74cb3q3251pwr.kicad_pcb]
2025-05-18 Remove unpublished package and fix INA228 and DCDC package (#22)
    * Remove unpublished package
    * Convert B0505 into ato
    * Fix INA228 package
    * Run precommit
    * Update READMEs
    * Update images
    [b0505s1wr3.kicad_pcb, cbm9002a_56ilg_reference_design.kicad_pcb, ina228.kicad_pcb]
2025-05-18 Add NXP PCA95xx series package (#20)
    * Add NXP PCA95xx series package
    [pca9536_driver.kicad_pcb, pca9554_driver.kicad_pcb, pca9554a_driver.kicad_pcb, test.kicad_pcb]
2025-05-18 Add Analog Devices MAX14778 package (#21)
    [analog_devices_max14778_driver.kicad_pcb]
2025-05-18 Cleaning-up and updating to latest standards (#23)
    * Update packages:
    - add required flag
    - package > driver method
    - cleaning up
    - aligning packages
    * Rebuild all
    [5v_to_3v3.kicad_pcb, addressable_led_connector_driver.kicad_pcb, addressable_led_driver.kicad_pcb, aip74lvc1t45_driver.kicad_pcb, analog_devices_adm2587ebrwz_driver.kicad_pcb, arm_cortex_m_debug_header.kicad_pcb, b0505s1wr3.kicad_pcb, bus_protection.kicad_pcb]
2025-05-18 Fix missing images (#24)
    [sn74cb3q3251pwr_driver.kicad_pcb]
2025-05-20 Add fan connector and controller packages (#25)
    * Add Fan connector and interface
    * Add microchip EMC2101 fan driver
    [fan_connector.kicad_pcb, microchip_emc2101_driver.kicad_pcb]
2025-05-21 Fix bistable relay (#26)
    * Fix wrong logic reference.
    * Split driver into own module
    [dc_motor_driver.kicad_pcb, driven_dpdt_bistable_relay.kicad_pcb, driven_dpdt_bistable_relay_push_terminal.kicad_pcb]
2025-05-21 Fix LDO power in voltage range (#27)
    [chipanalog_is2092a_driver.kicad_pcb, maxlinear_sp3485en_driver.kicad_pcb]
2025-05-24 Add J-Link compact footprint (#28)
    [segger_jlink_compact.kicad_pcb]
2025-05-24 Add MPM3610 DCDC converter (#29)
    [mpm3610-12vin-5vout.kicad_pcb]
2025-05-25 Add Texas Instruments LM66200 double ideal diode package (#31)
    [lm66200.kicad_pcb]
2025-05-25 ESP32C3 fix USB connection (#32)
2025-05-30 Add vertical usb connector option (#33)
    [usb_2_0_type_c_data_power_horizontal_connector.kicad_pcb, usb_2_0_type_c_data_power_vertical_connector.kicad_pcb, usb_pd_power_sink_horizontal_connector.kicad_pcb, usb_pd_power_sink_vertical_connector.kicad_pcb]
2025-05-30 Add rohm_semiconductor_bh1750fvi (#34)
    [bh1750_driver.kicad_pcb]
2025-06-28 Update packages to ato v0.9.x (#36)
    [5v_to_3v3.kicad_pcb, ANT-TH_L33.0-W12.0_BLACK.step, ANT-TH_L33.0-W12.0_RED.step, C0402_L1.0-W0.5-H0.5.step, C0603_L1.6-W0.8-H0.8.step, C0805_L2.0-W1.3-H1.3.step, C1808_L4.5-W2.0-H2.0.step, CAP-TH_L6.0-W2.5-P5.0.step]
2025-06-28 fix(esp32c3): frozen build & unconnected pads (#38)
    [esp32_c3_mini_driver.kicad_pcb, esp32_c3_mini_ufl_driver.kicad_pcb]
